kaichodesu/sotond5/liblcd/graphics/backgrounds/002.png

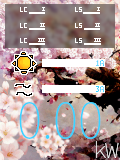
liblcd/graphics/backgrounds/002.png
