kaichodesu/sotond5/liblcd/graphics/backgrounds/characters/Agiri.png

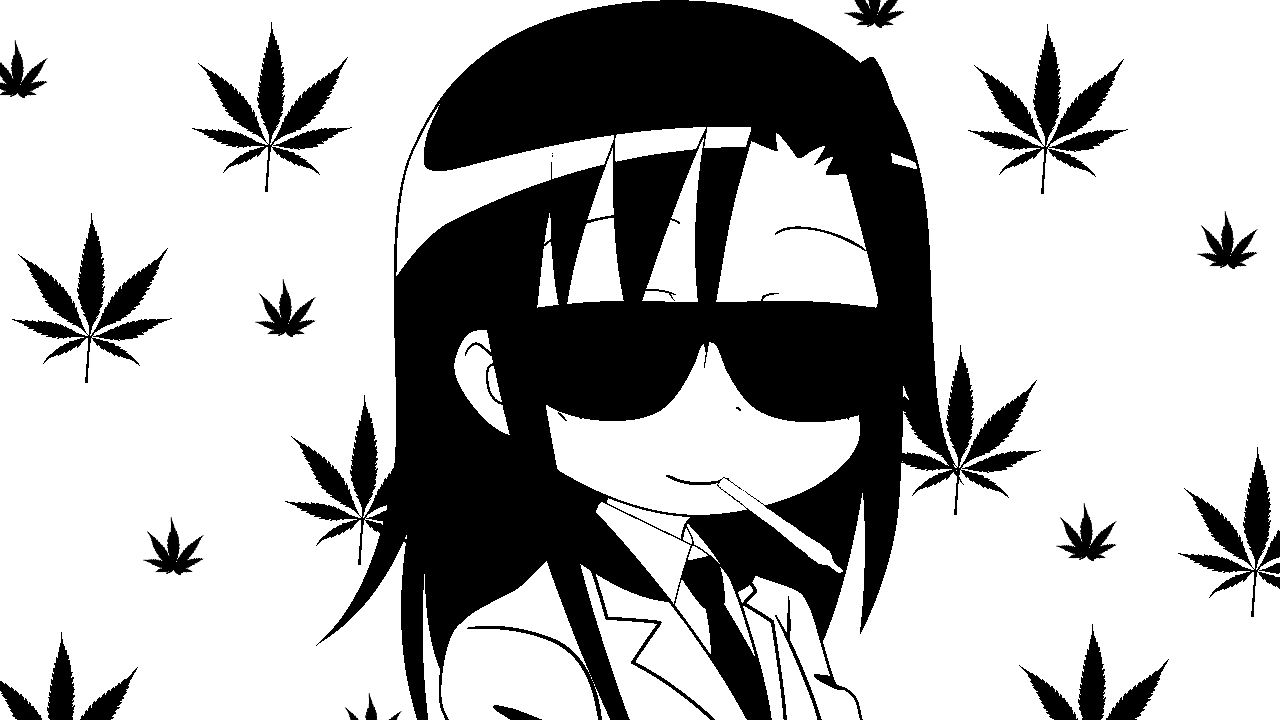
liblcd/graphics/backgrounds/characters/Agiri.png
