kaichodesu/sotond5/liblcd/graphics/backgrounds/characters/Akarin.png

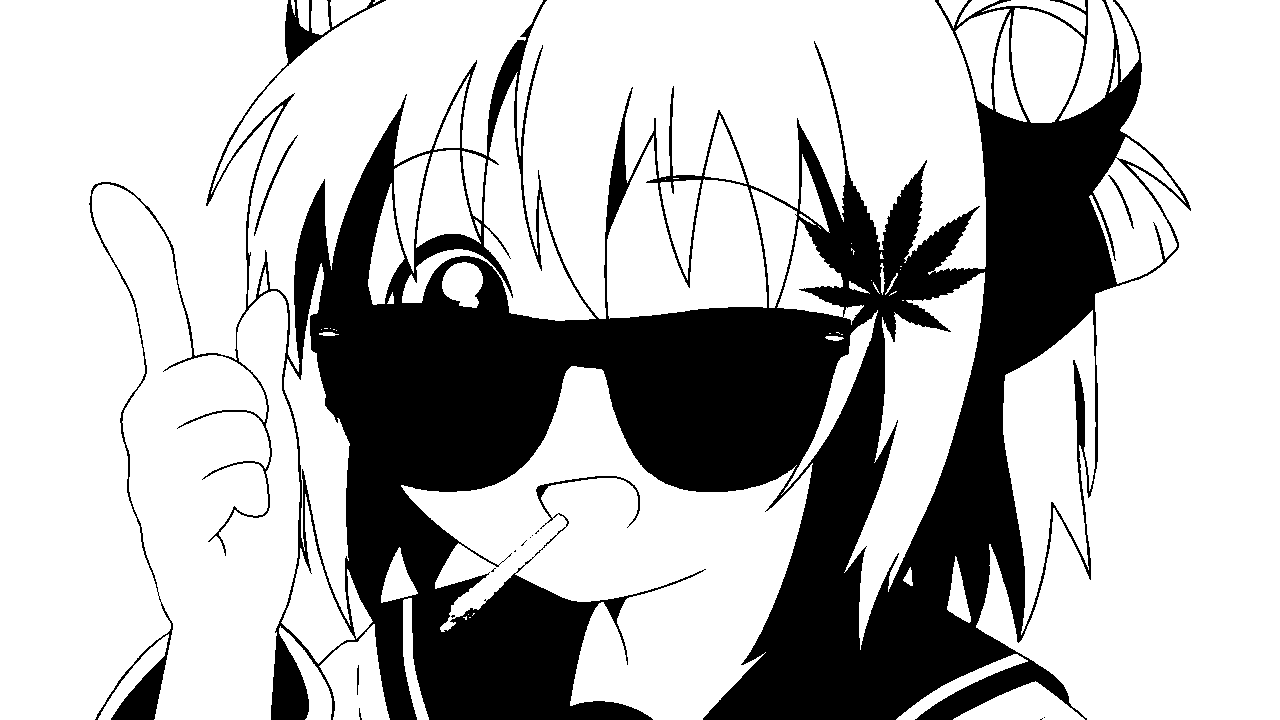
liblcd/graphics/backgrounds/characters/Akarin.png
