kaichodesu/sotond5/liblcd/graphics/backgrounds/characters/Astraea.png

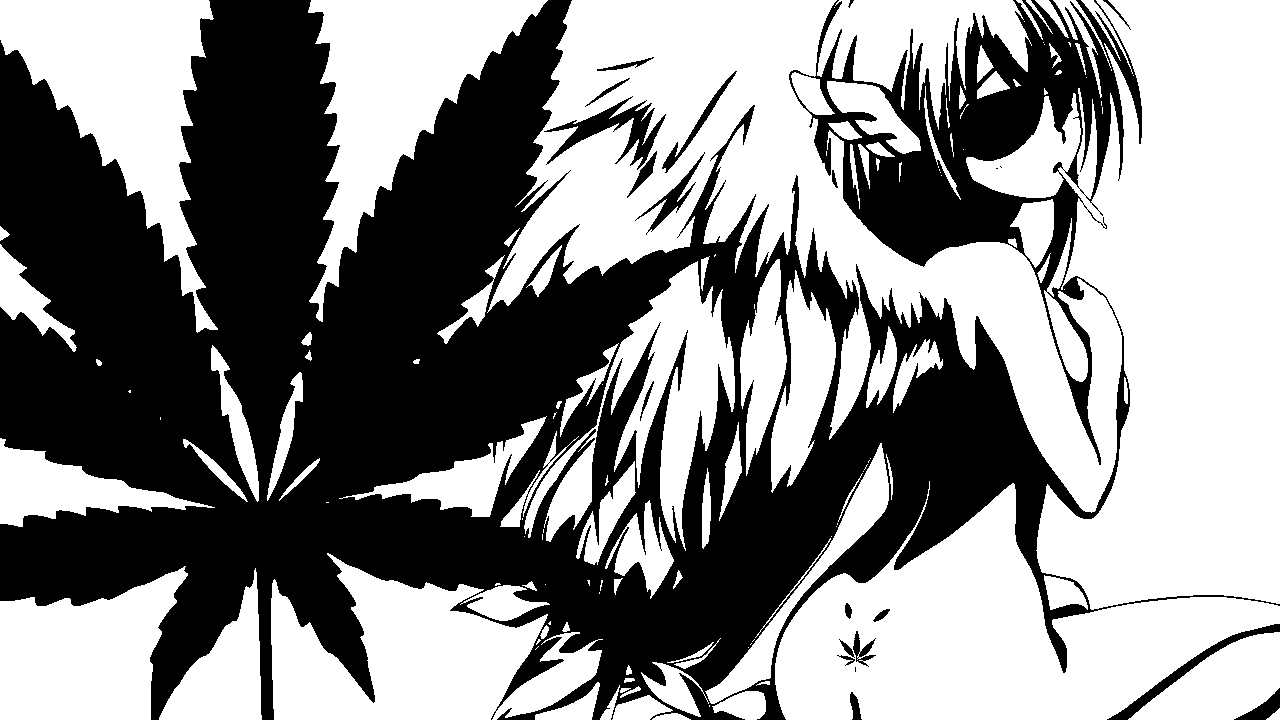
liblcd/graphics/backgrounds/characters/Astraea.png
