kaichodesu/sotond5/liblcd/graphics/backgrounds/characters/Ayase.png

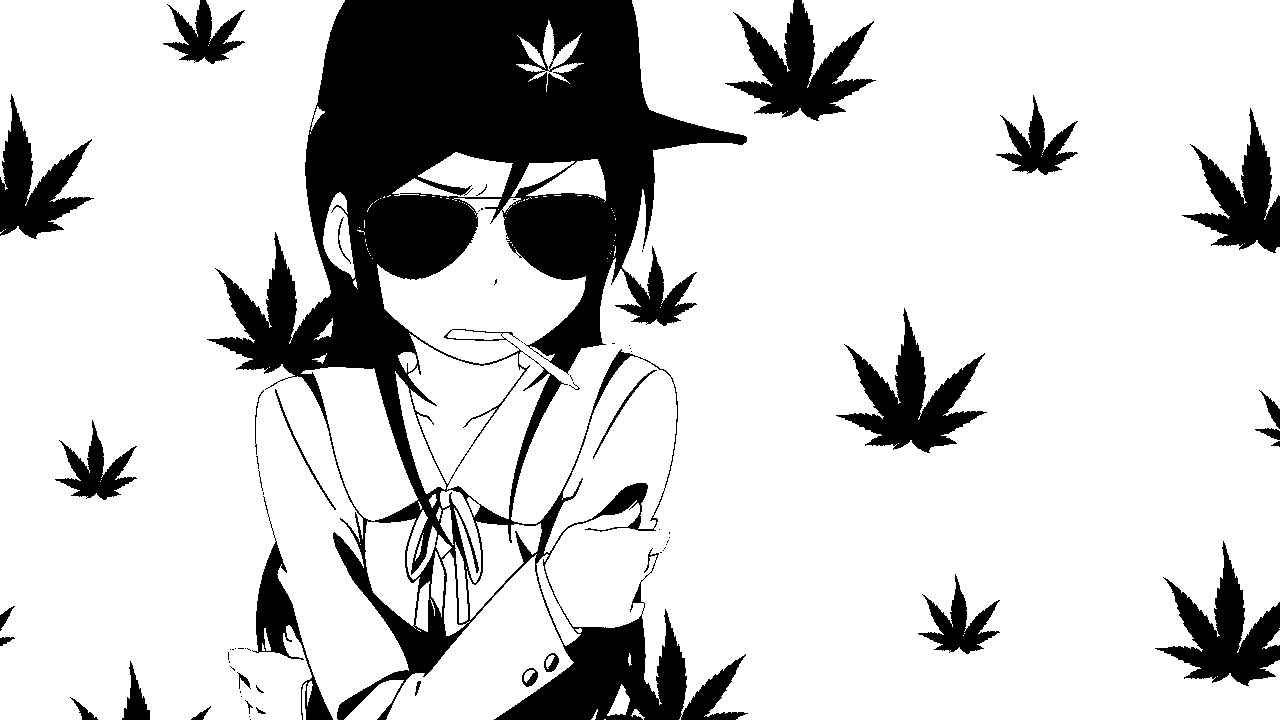
liblcd/graphics/backgrounds/characters/Ayase.png
