kaichodesu/sotond5/liblcd/graphics/backgrounds/characters/Cirno.png

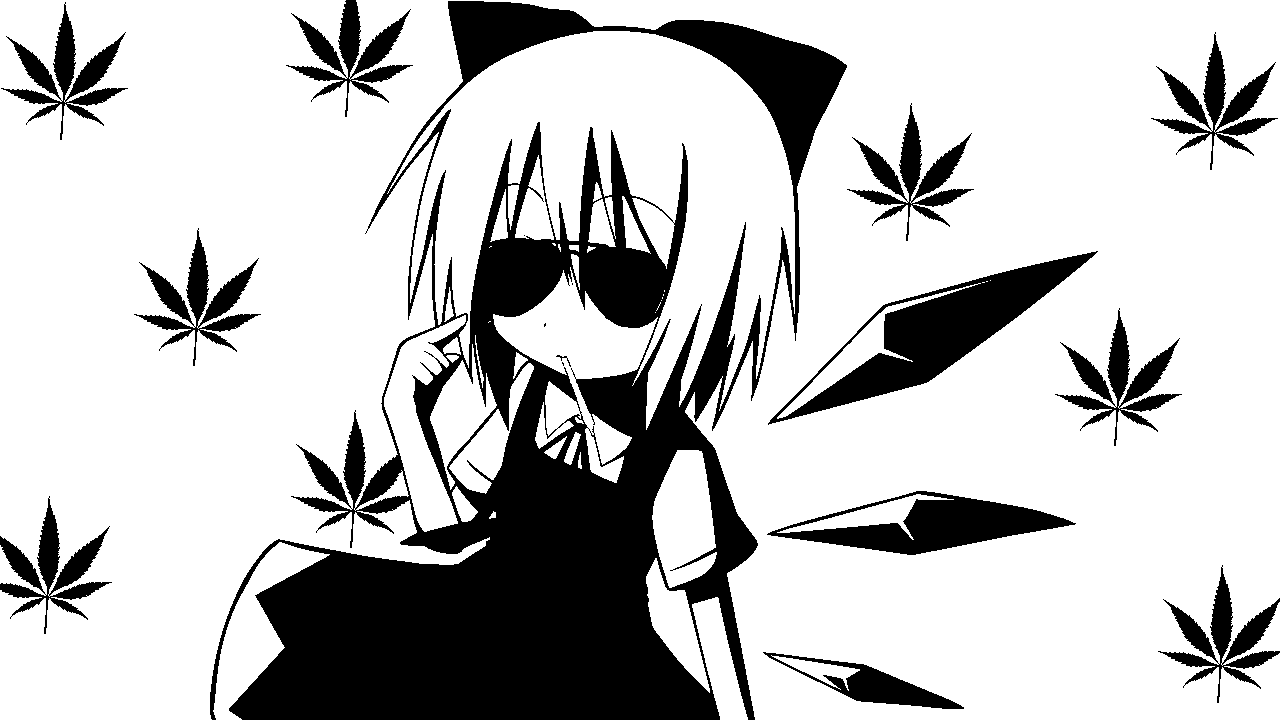
liblcd/graphics/backgrounds/characters/Cirno.png
