kaichodesu/sotond5/liblcd/graphics/backgrounds/characters/Eureka.png

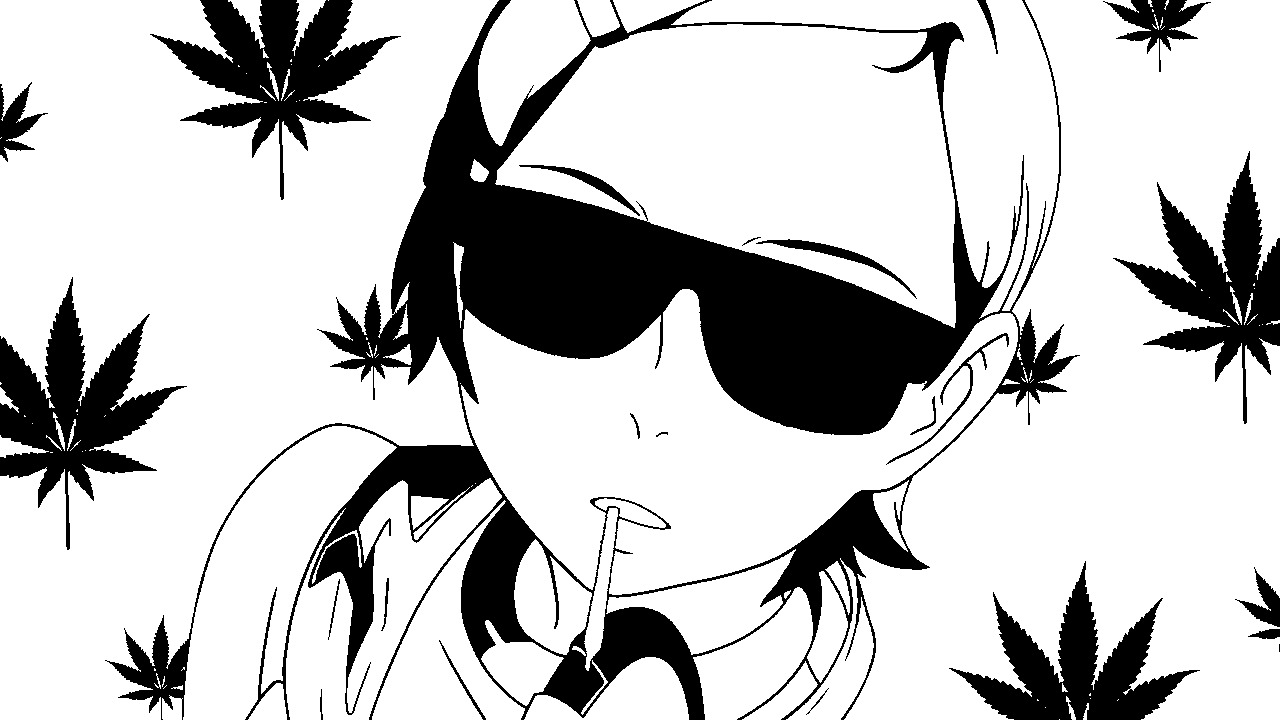
liblcd/graphics/backgrounds/characters/Eureka.png
