kaichodesu/sotond5/liblcd/graphics/backgrounds/characters/Fuu.png

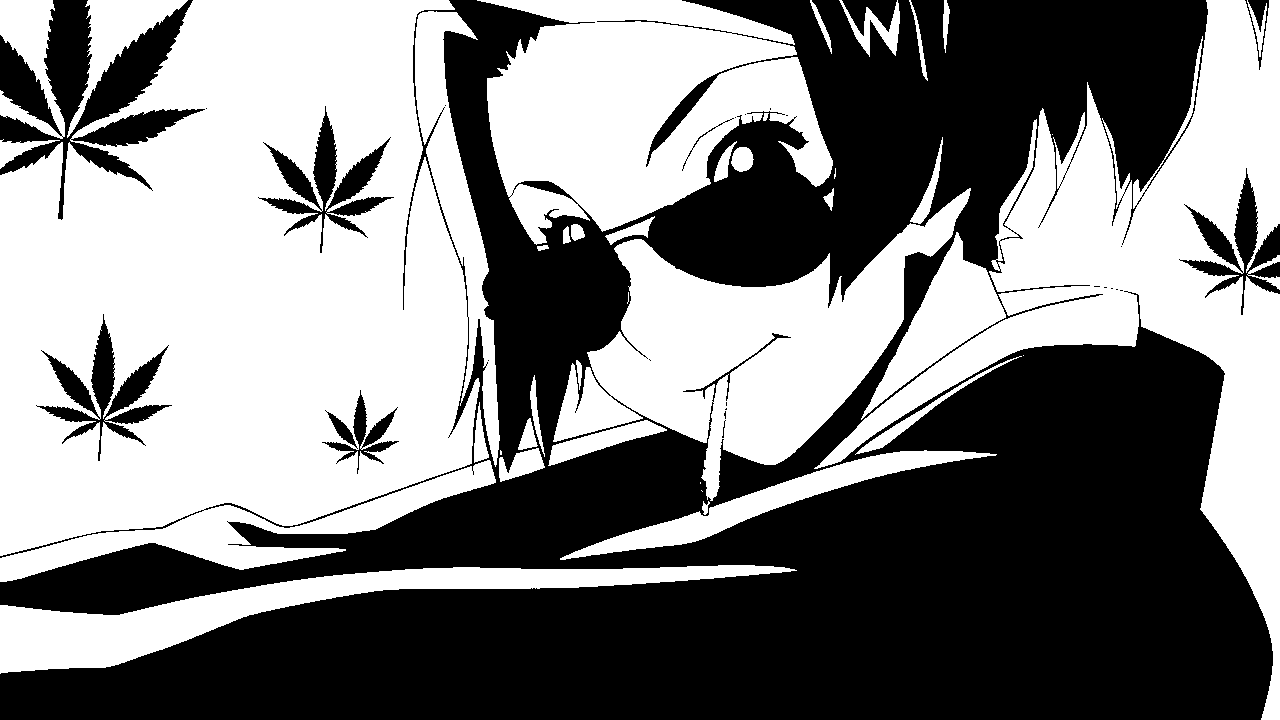
liblcd/graphics/backgrounds/characters/Fuu.png
