kaichodesu/sotond5/liblcd/graphics/backgrounds/characters/Hajime Ichinose.png

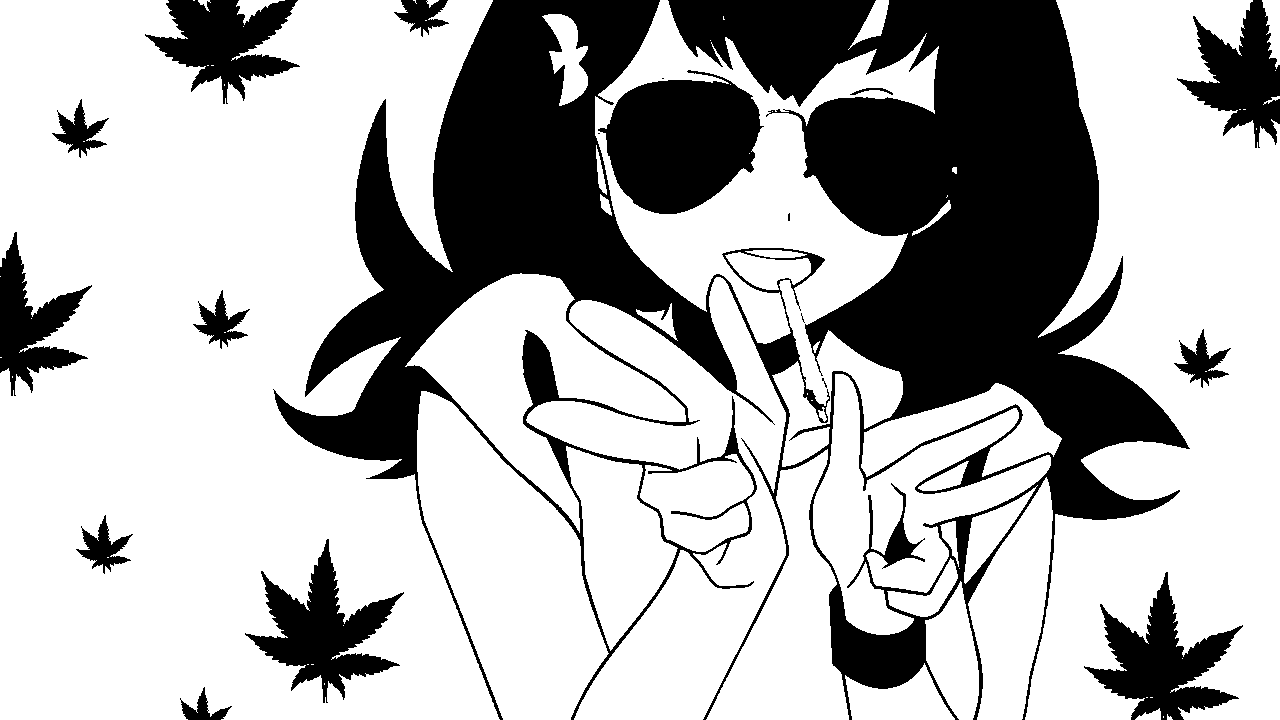
liblcd/graphics/backgrounds/characters/Hajime Ichinose.png
