kaichodesu/sotond5/liblcd/graphics/backgrounds/characters/Hanako.png

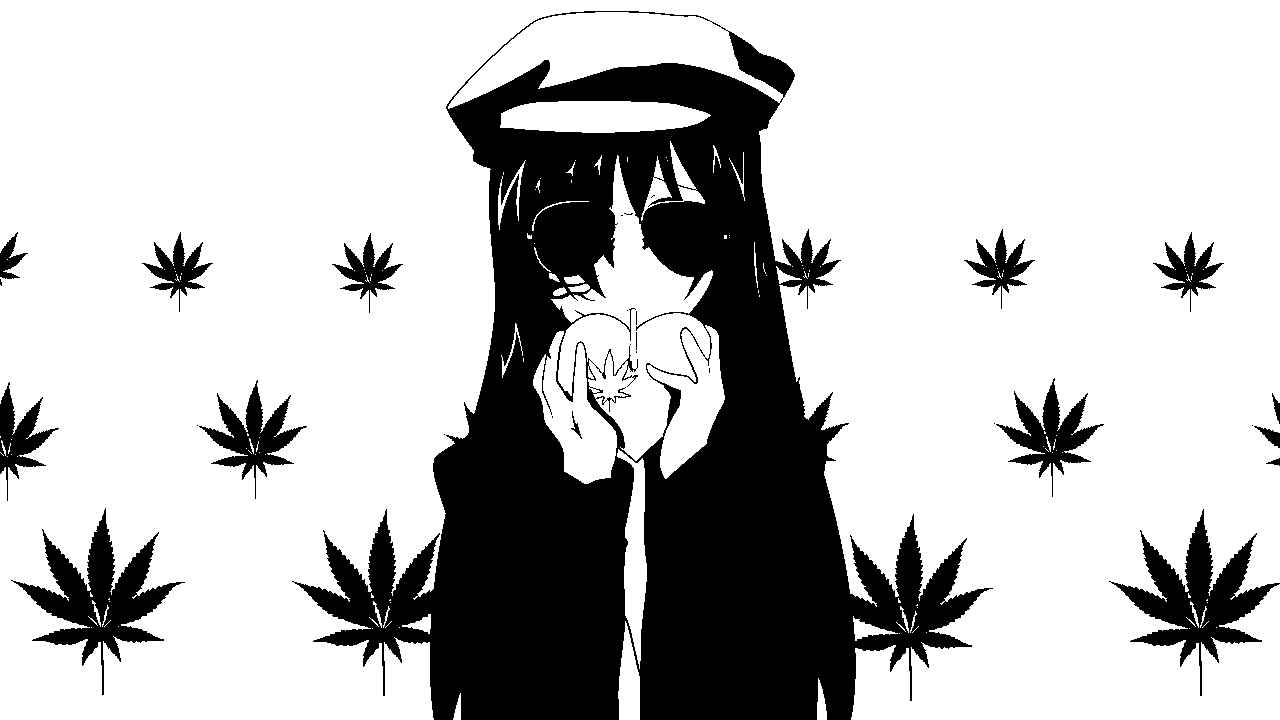
liblcd/graphics/backgrounds/characters/Hanako.png
