kaichodesu/sotond5/liblcd/graphics/backgrounds/characters/Haruhi.png

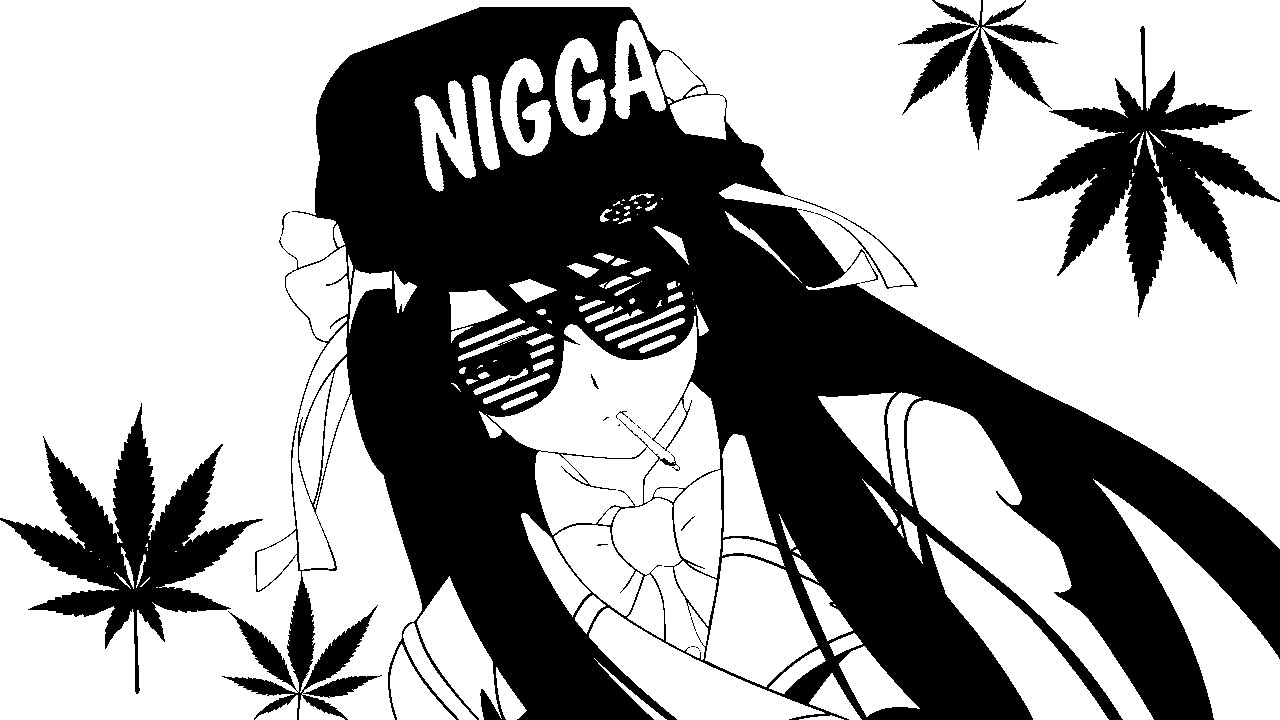
liblcd/graphics/backgrounds/characters/Haruhi.png
