kaichodesu/sotond5/liblcd/graphics/backgrounds/characters/Holo.png

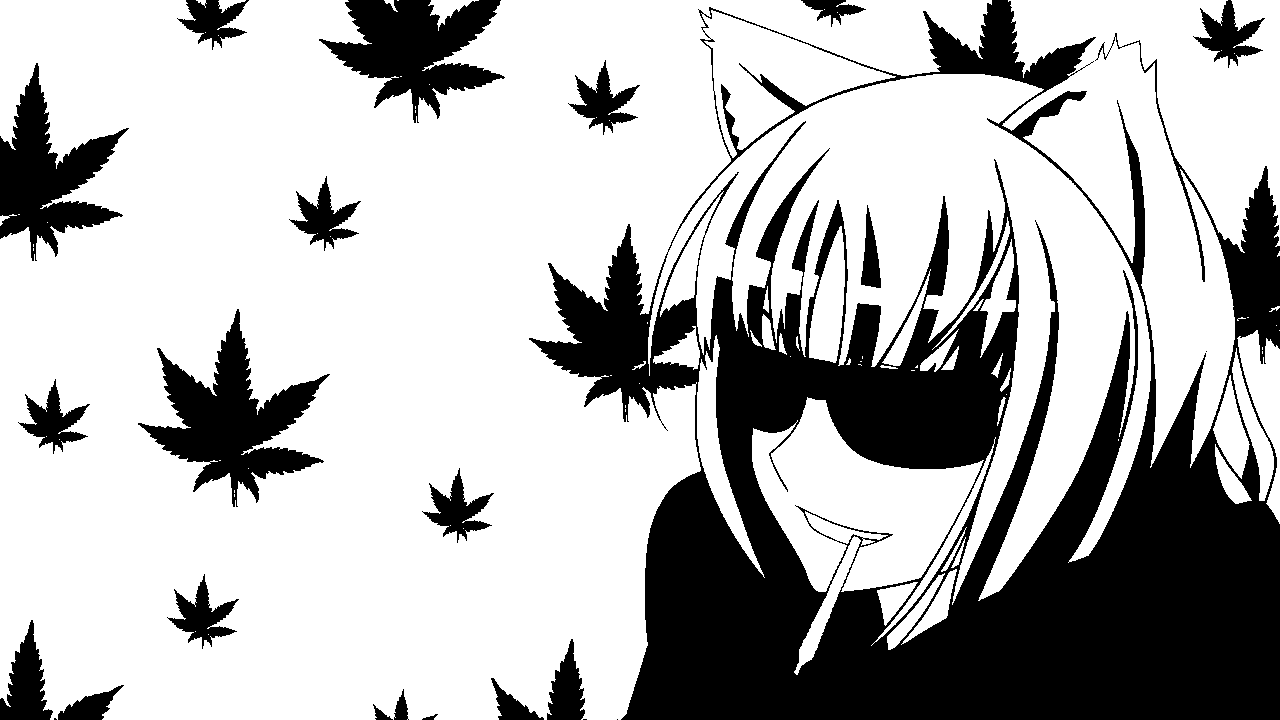
liblcd/graphics/backgrounds/characters/Holo.png
