kaichodesu/sotond5/liblcd/graphics/backgrounds/characters/Kanade.png

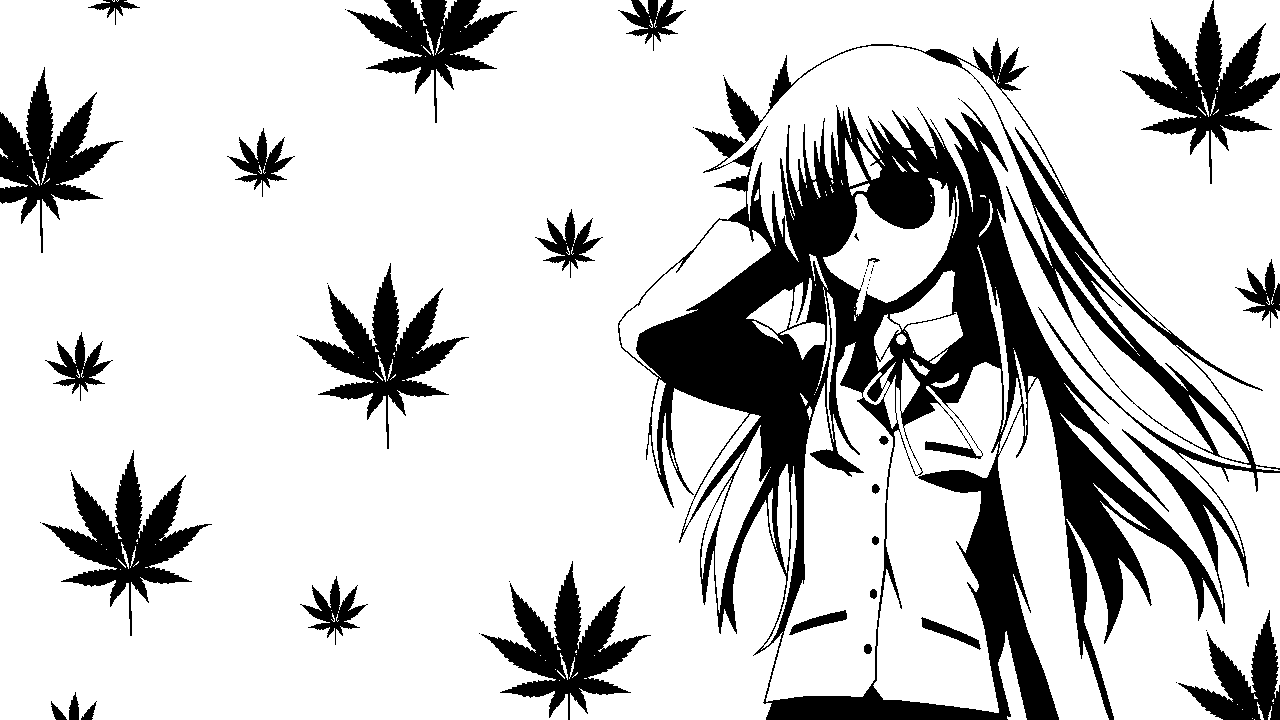
liblcd/graphics/backgrounds/characters/Kanade.png
