kaichodesu/sotond5/liblcd/graphics/backgrounds/characters/Kanoe.png

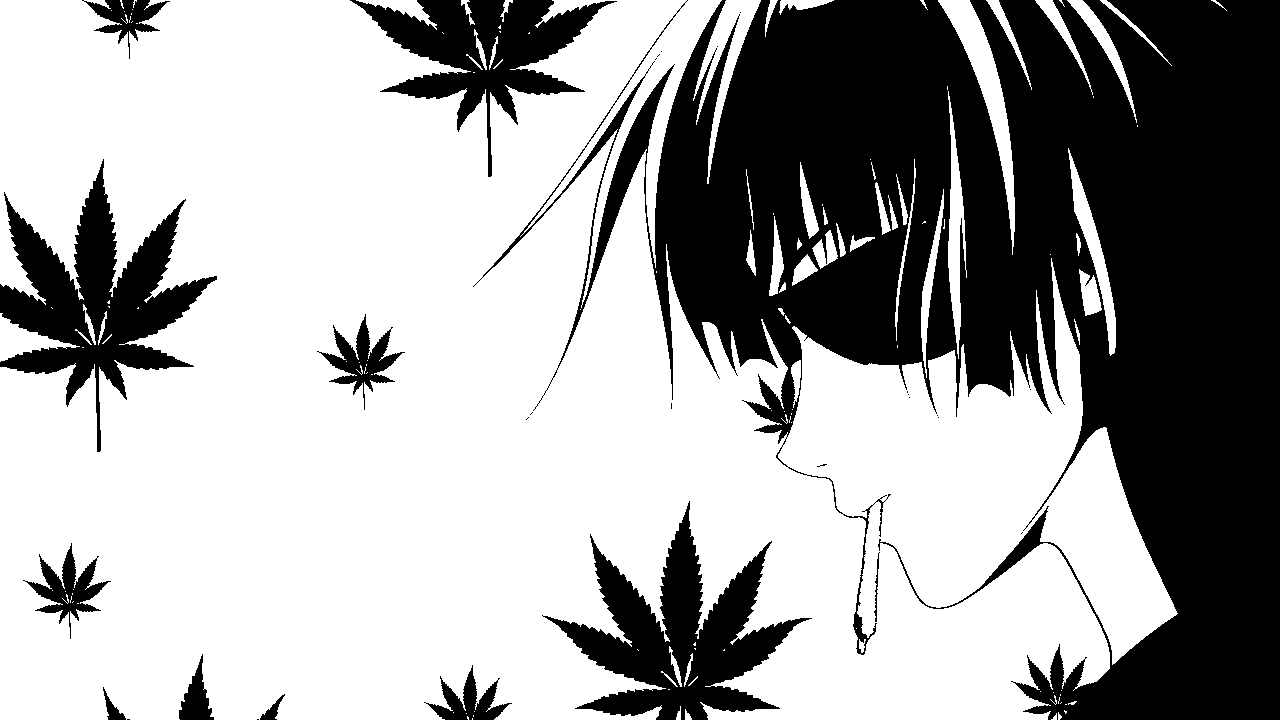
liblcd/graphics/backgrounds/characters/Kanoe.png
