kaichodesu/sotond5/liblcd/graphics/backgrounds/characters/Kyoko.png

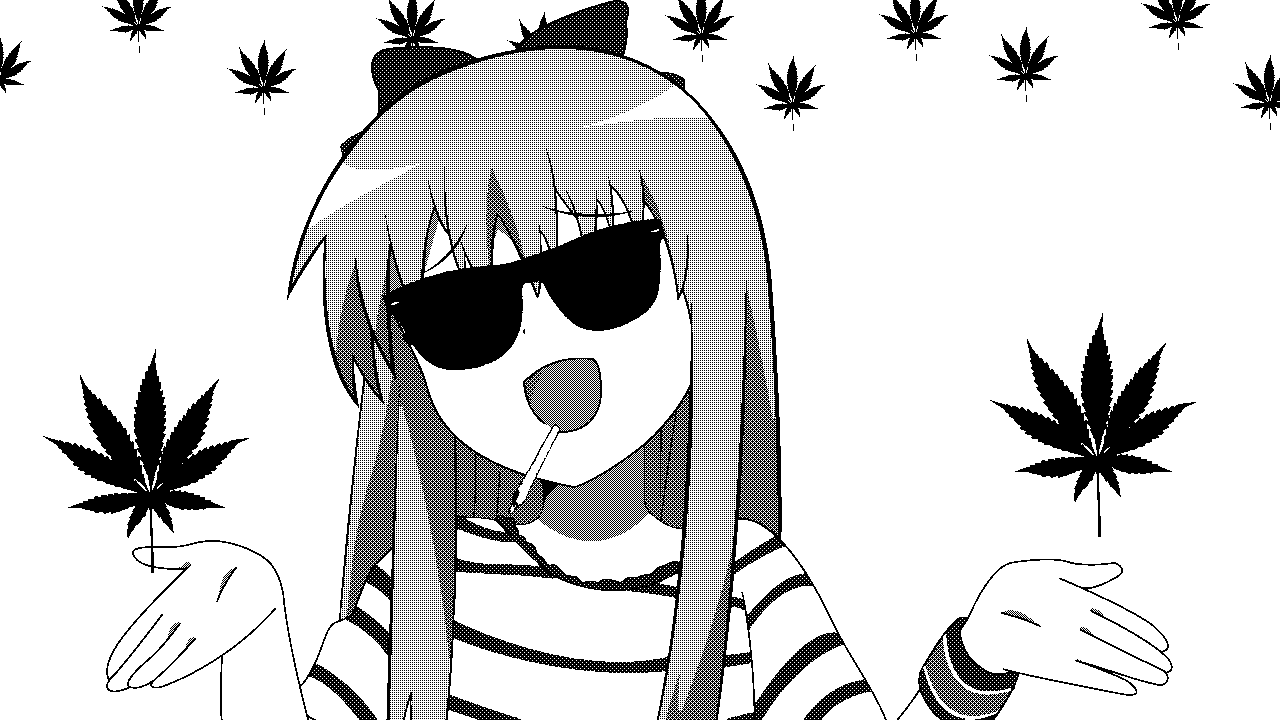
liblcd/graphics/backgrounds/characters/Kyoko.png
