kaichodesu/sotond5/liblcd/graphics/backgrounds/characters/Lala-Ru.png

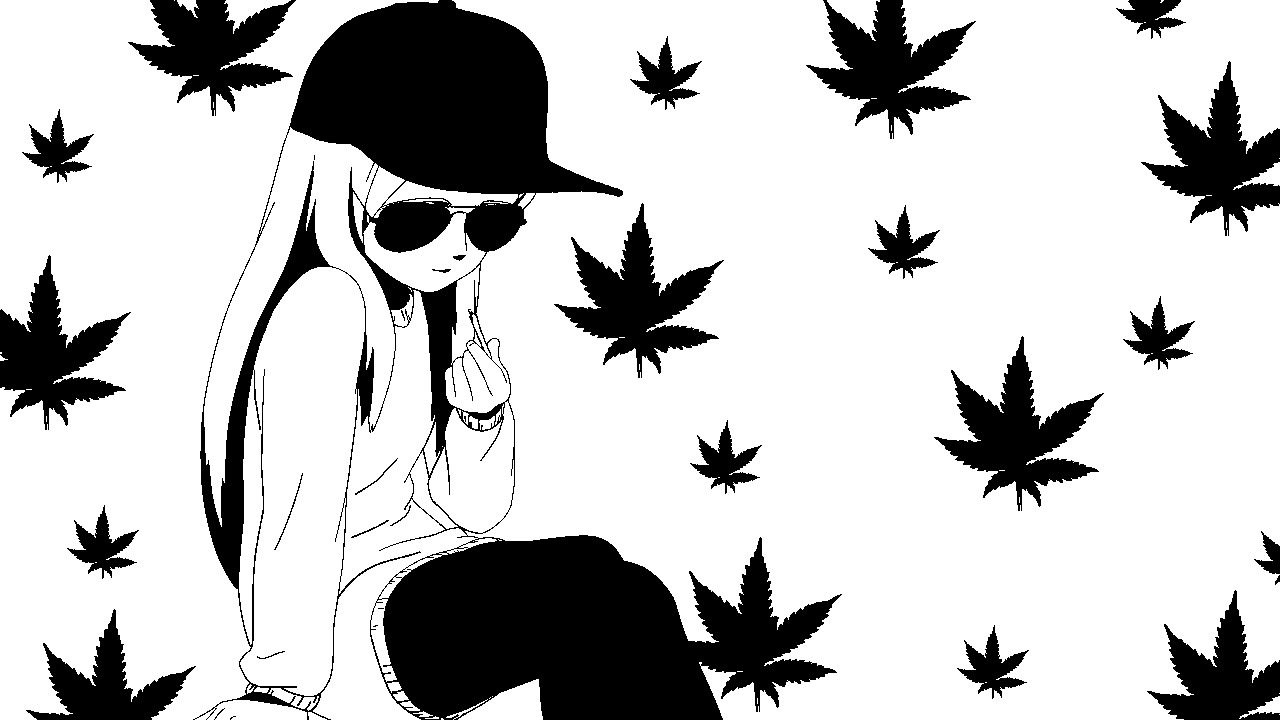
liblcd/graphics/backgrounds/characters/Lala-Ru.png
