kaichodesu/sotond5/liblcd/graphics/backgrounds/characters/Lucy.gif

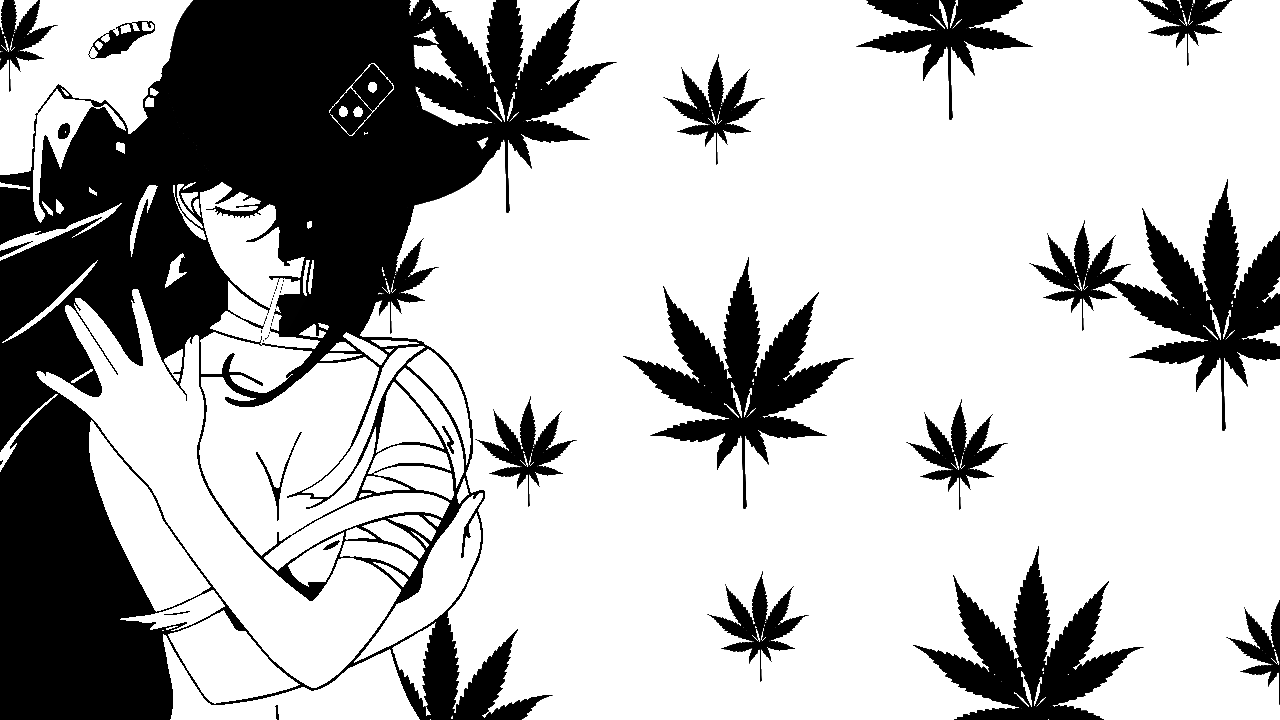
liblcd/graphics/backgrounds/characters/Lucy.gif
