kaichodesu/sotond5/liblcd/graphics/backgrounds/characters/Madotsuki.png

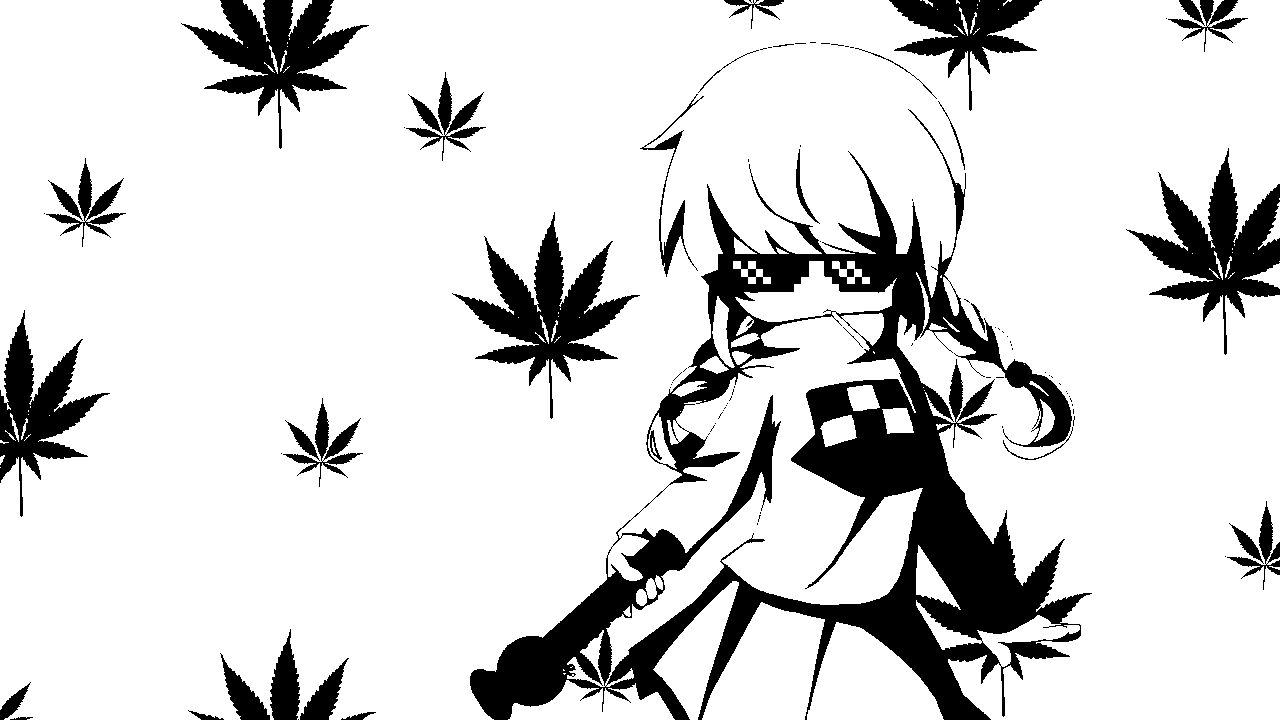
liblcd/graphics/backgrounds/characters/Madotsuki.png
