kaichodesu/sotond5/liblcd/graphics/backgrounds/characters/Mao.png

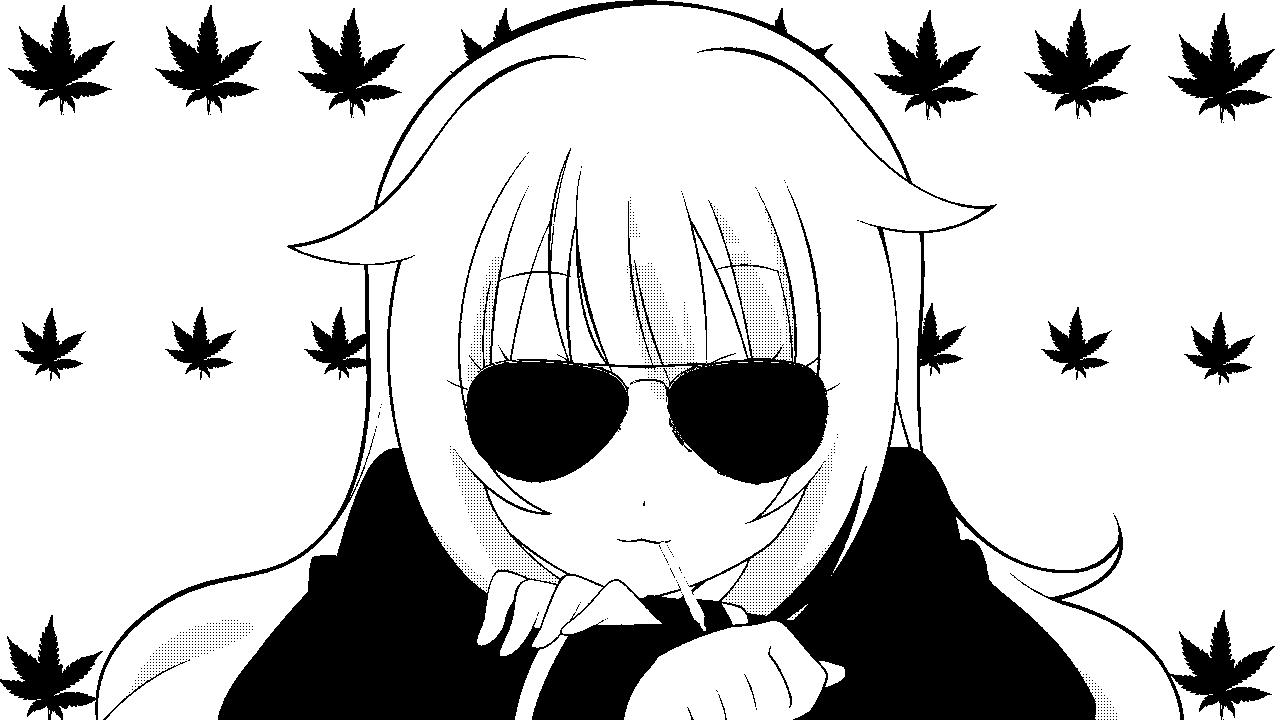
liblcd/graphics/backgrounds/characters/Mao.png
