kaichodesu/sotond5/liblcd/graphics/backgrounds/characters/Mayoi.png

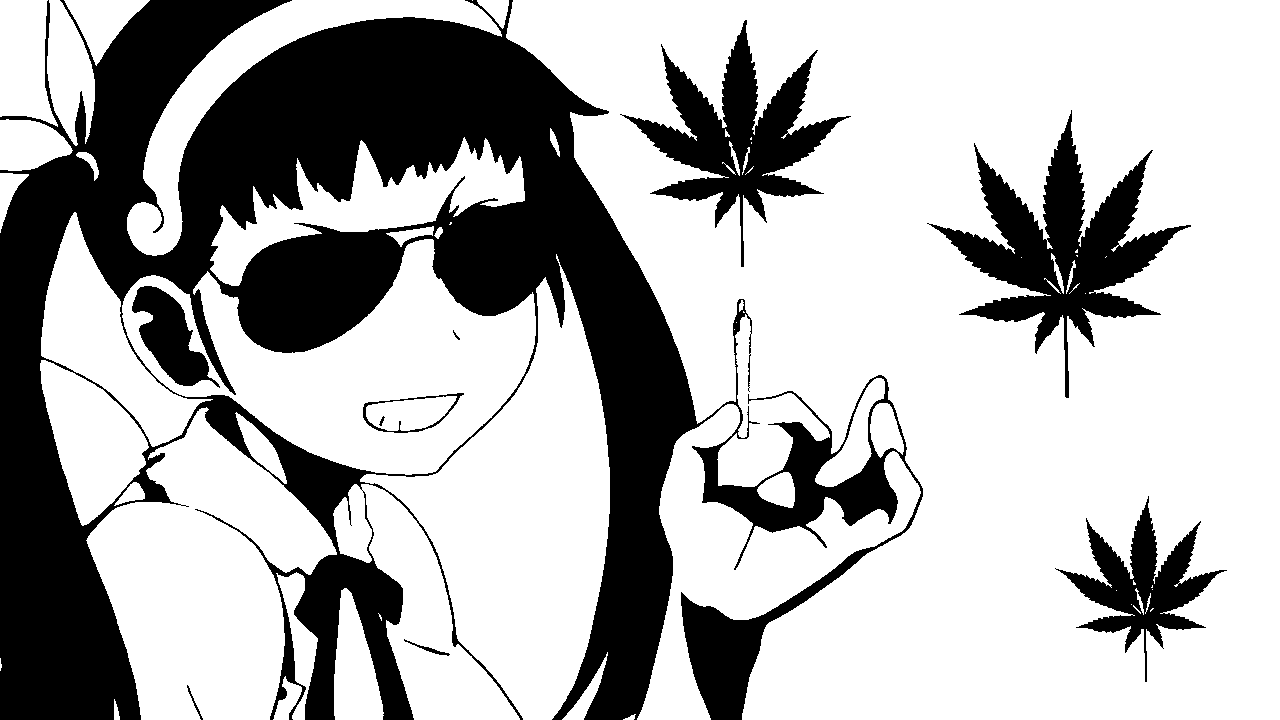
liblcd/graphics/backgrounds/characters/Mayoi.png
