kaichodesu/sotond5/liblcd/graphics/backgrounds/characters/Megumi.png

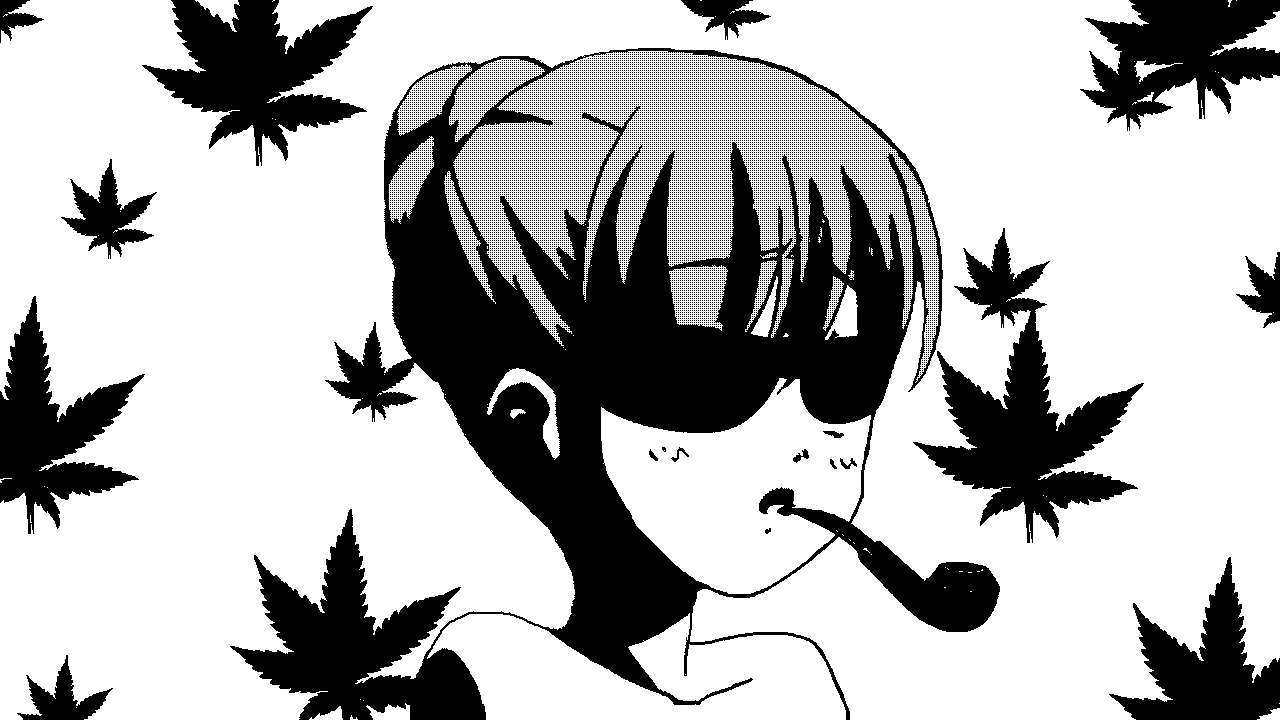
liblcd/graphics/backgrounds/characters/Megumi.png
