kaichodesu/sotond5/liblcd/graphics/backgrounds/characters/Mirai.png

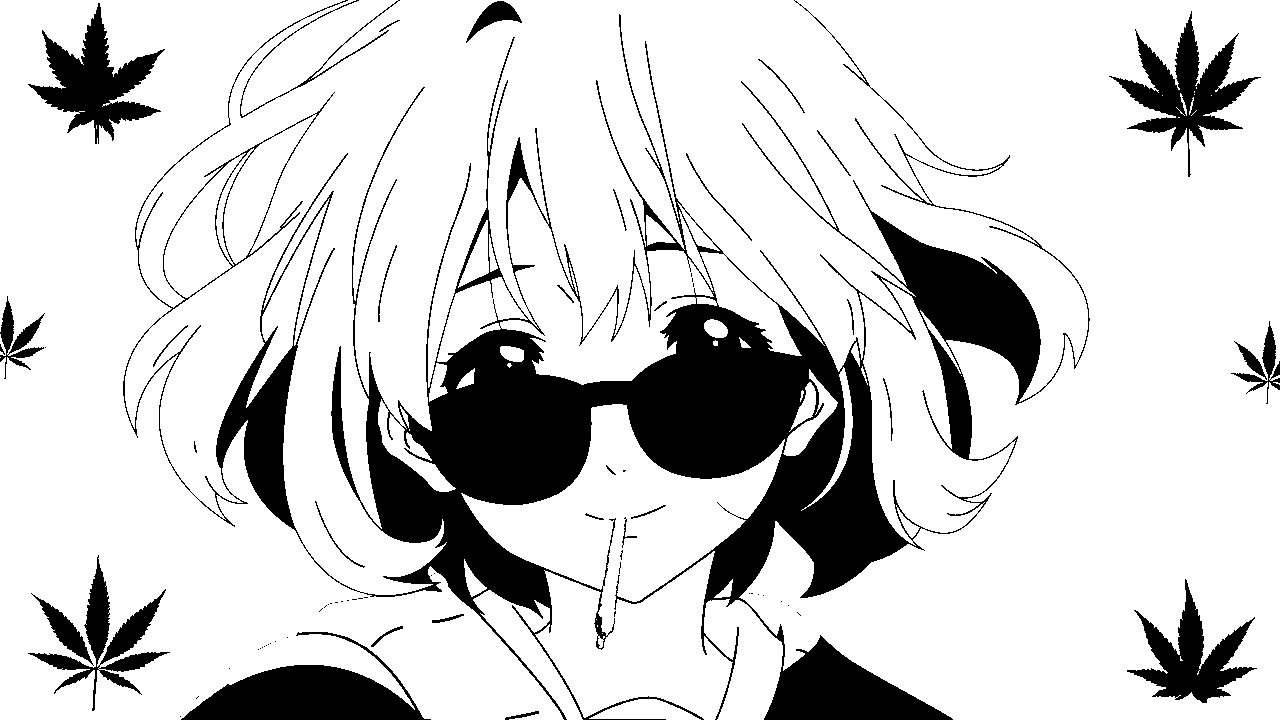
liblcd/graphics/backgrounds/characters/Mirai.png
