kaichodesu/sotond5/liblcd/graphics/backgrounds/characters/Misaki.png

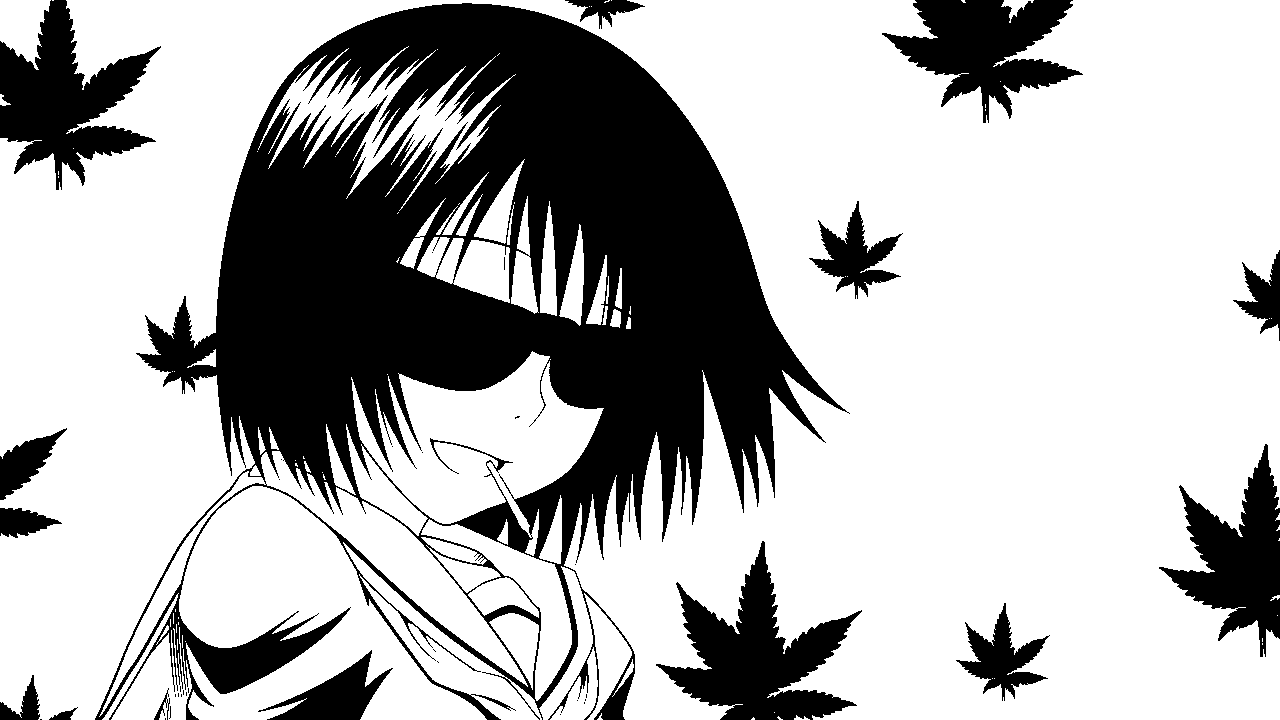
liblcd/graphics/backgrounds/characters/Misaki.png
