kaichodesu/sotond5/liblcd/graphics/backgrounds/characters/Morgiana.png

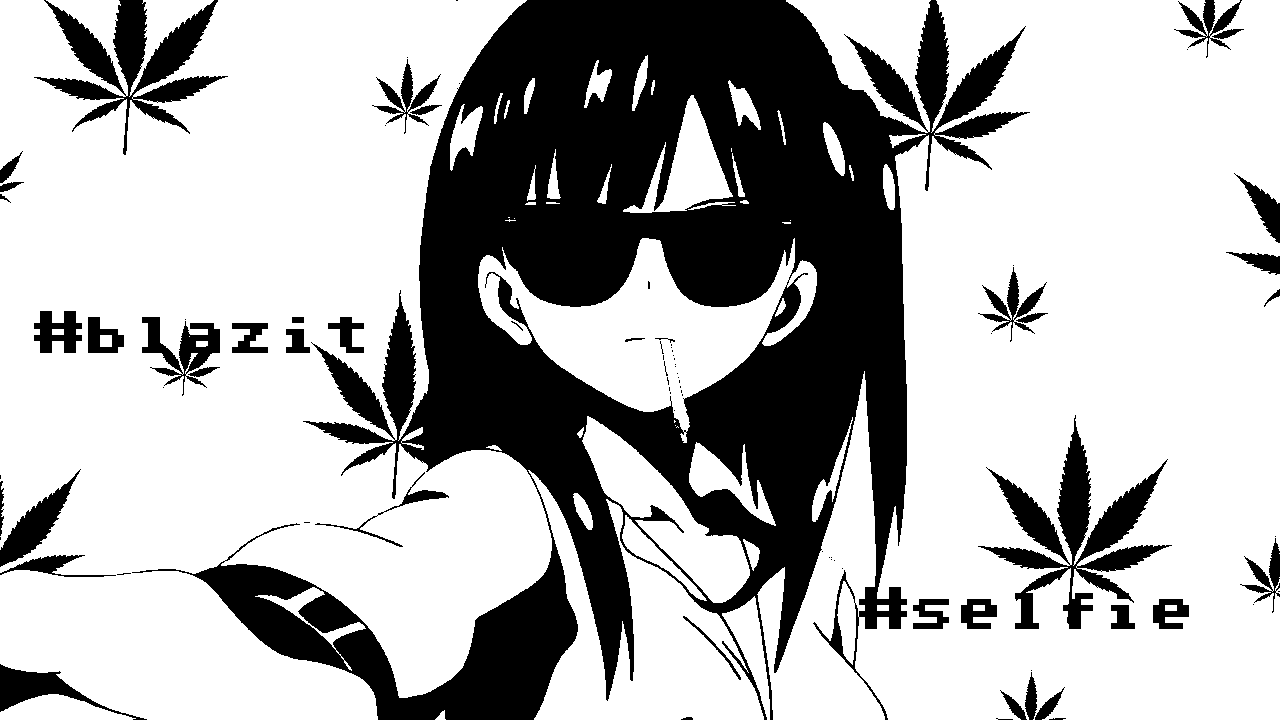
liblcd/graphics/backgrounds/characters/Morgiana.png
