kaichodesu/sotond5/liblcd/graphics/backgrounds/characters/Noel.png

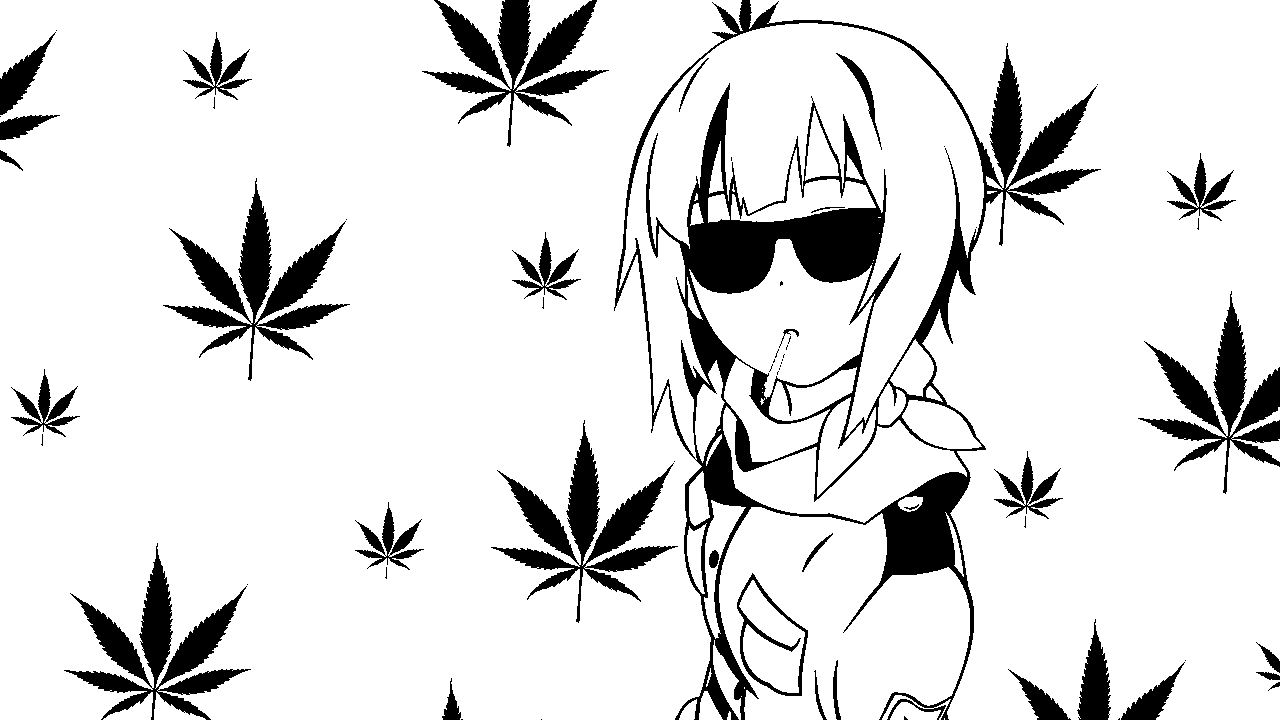
liblcd/graphics/backgrounds/characters/Noel.png
