kaichodesu/sotond5/liblcd/graphics/backgrounds/characters/Nymph.png

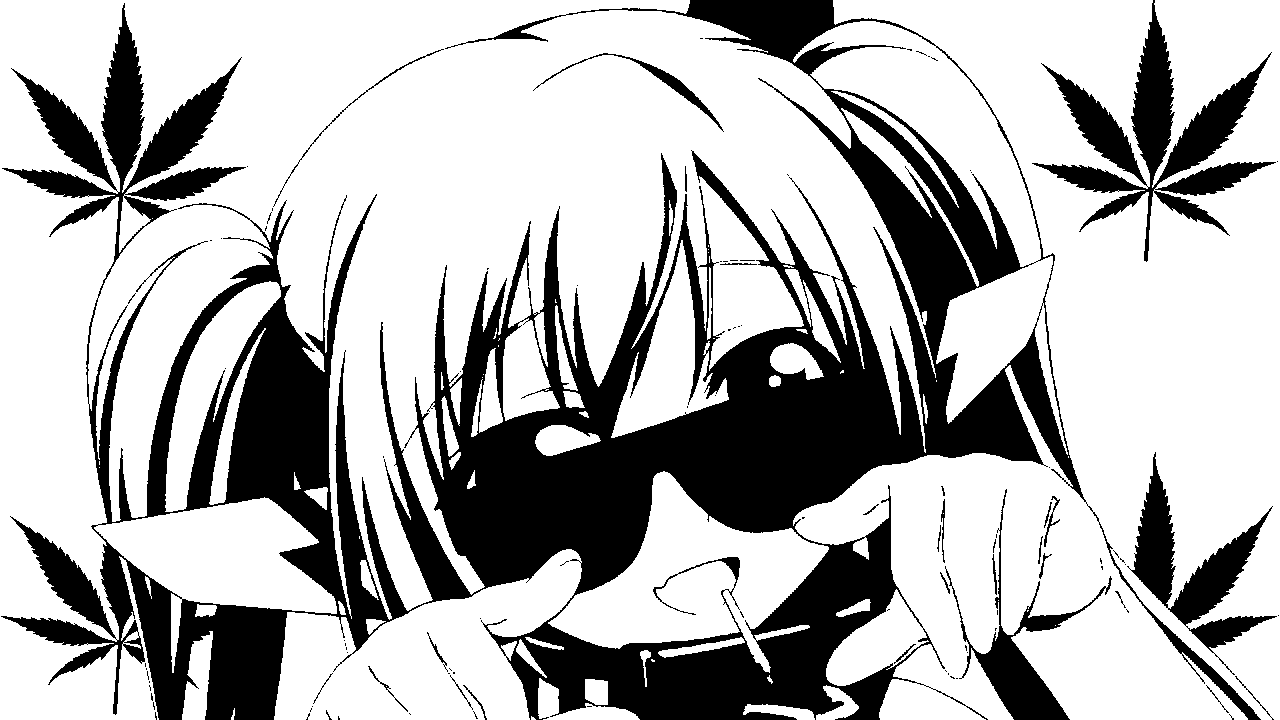
liblcd/graphics/backgrounds/characters/Nymph.png
