kaichodesu/sotond5/liblcd/graphics/backgrounds/characters/Renge.png

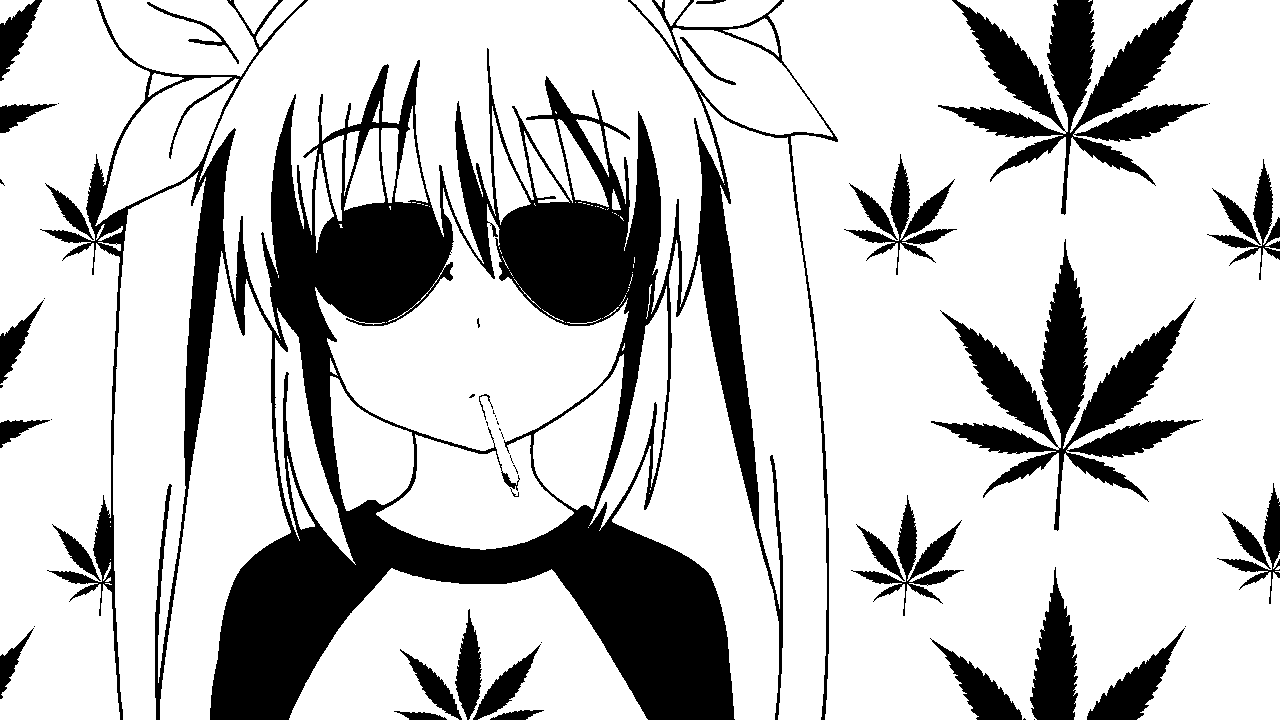
liblcd/graphics/backgrounds/characters/Renge.png
