kaichodesu/sotond5/liblcd/graphics/backgrounds/characters/Shinobu.png

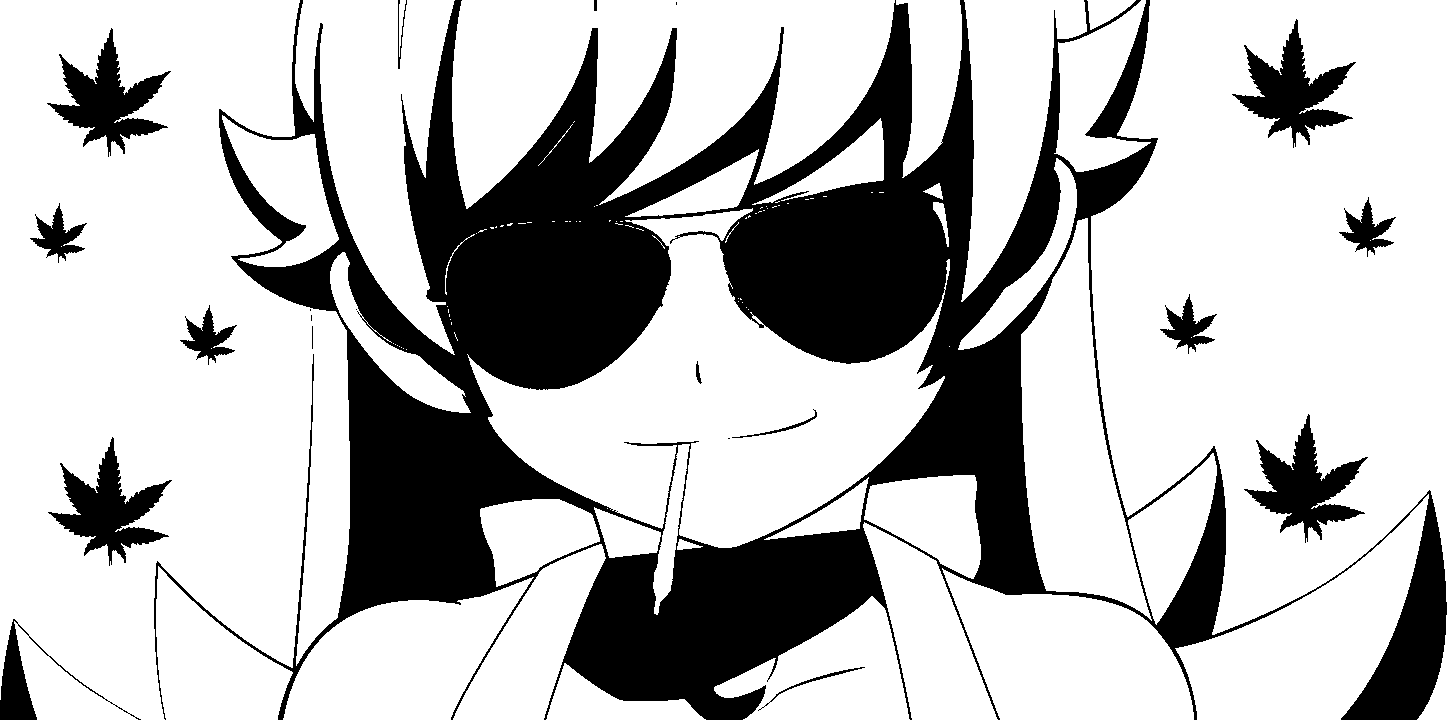
liblcd/graphics/backgrounds/characters/Shinobu.png
