kaichodesu/sotond5/liblcd/graphics/backgrounds/characters/Suiseiseki.png

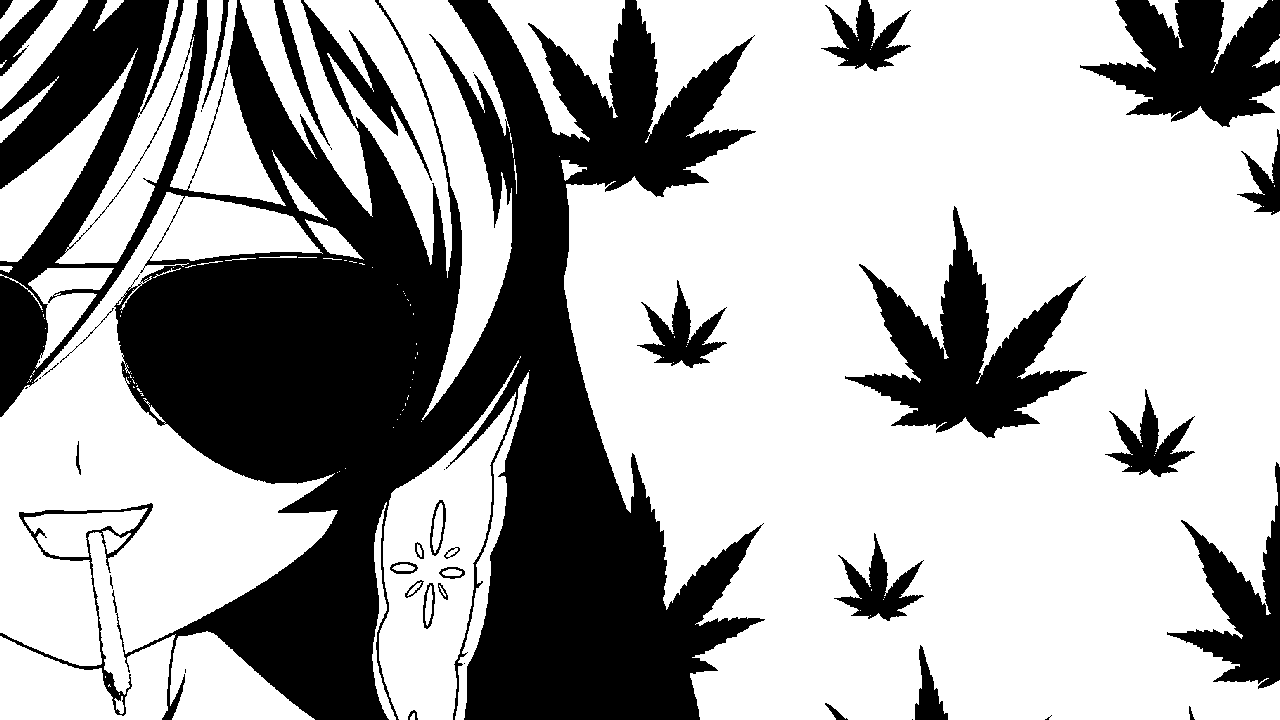
liblcd/graphics/backgrounds/characters/Suiseiseki.png
