kaichodesu/sotond5/Project Files/PSU Simulations and OrCAD files/Final/SMPS.png

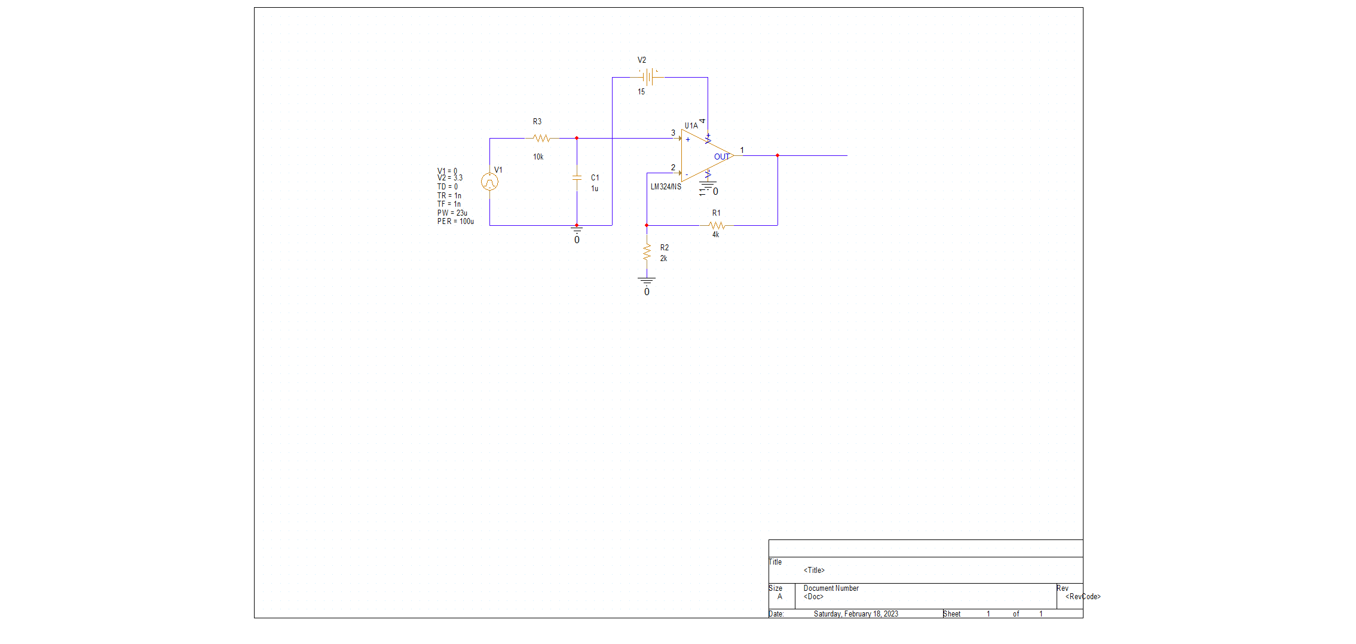
Project Files/PSU Simulations and OrCAD files/Final/SMPS.png
