kaichodesu/sotond5/Project Files/PSU Simulations and OrCAD files/Version 3/UCC28730_PSPICE_TRANS/UCC28730_DEB.png

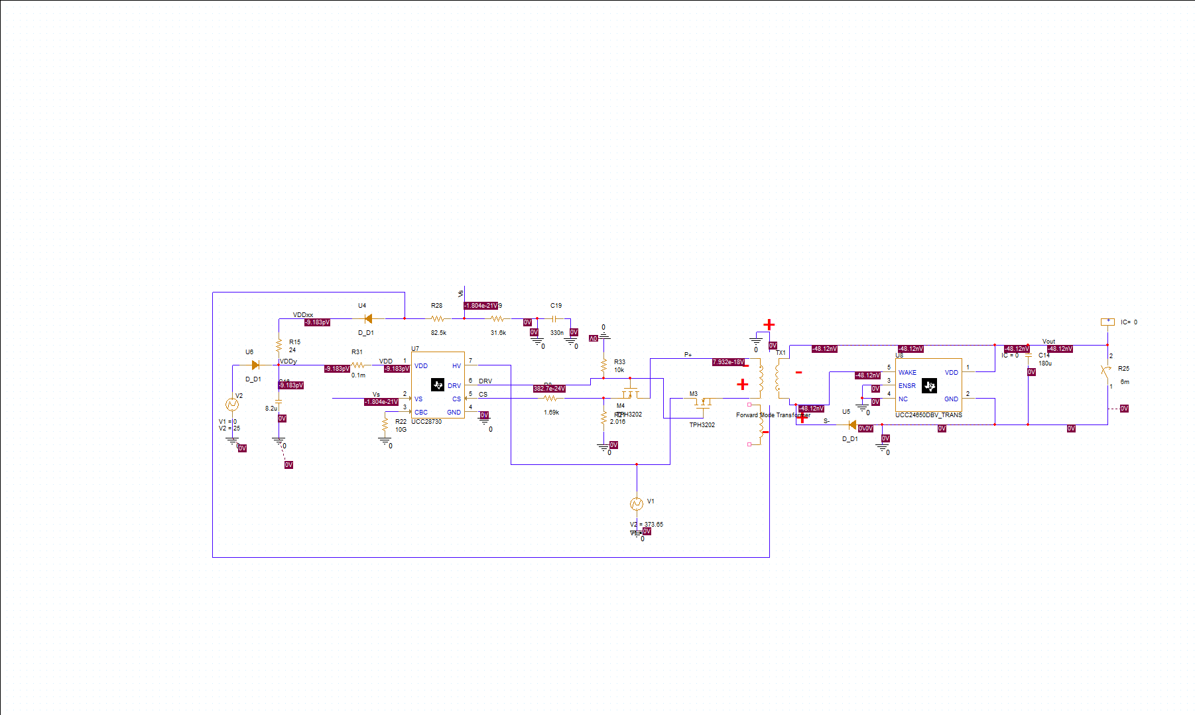
Project Files/PSU Simulations and OrCAD files/Version 3/UCC28730_PSPICE_TRANS/UCC28730_DEB.png
