kaichodesu/sotond5/Project Files/Report/D5/3.3v (main capacity) circuit.png

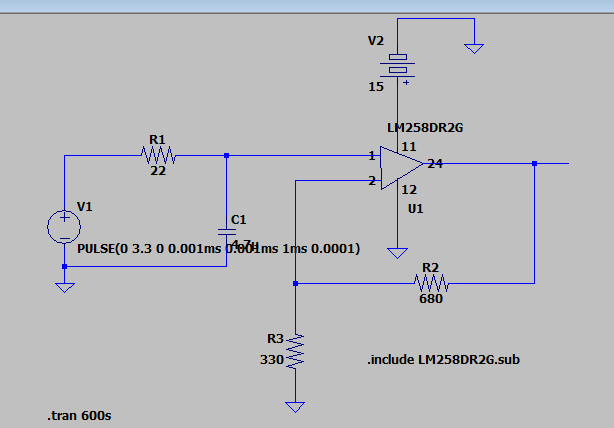
Project Files/Report/D5/3.3v (main capacity) circuit.png
