kaichodesu/sotond5/Project Files/Report/D5/4AC circuit.png

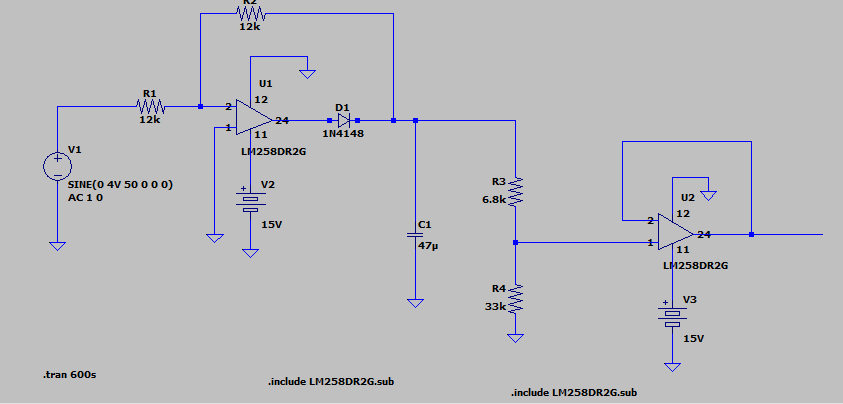
Project Files/Report/D5/4AC circuit.png
