kaichodesu/sotond5/Project Files/Report/D5/5 digital circuit.png

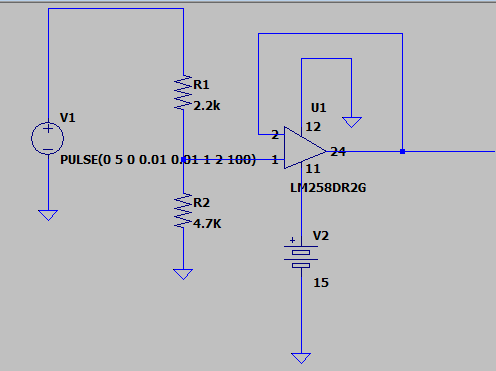
Project Files/Report/D5/5 digital circuit.png
