kaichodesu/sotond5/Project Files/Report/D5/5DC circuit.png

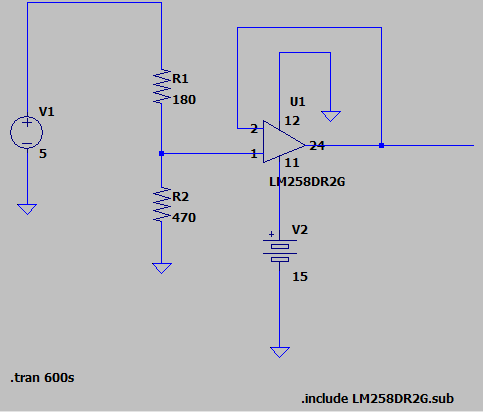
Project Files/Report/D5/5DC circuit.png
