kaichodesu/sotond5/Project Files/Report/D5/5DC.png

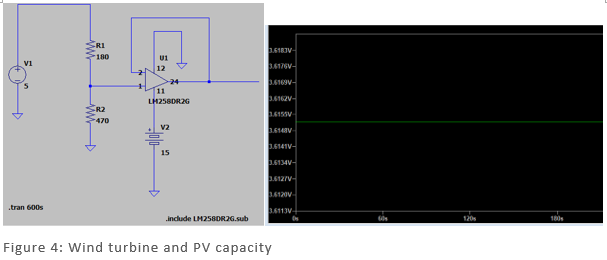
Project Files/Report/D5/5DC.png
