kaichodesu/sotond5/Project Files/Report/D5/10AC circuit.png

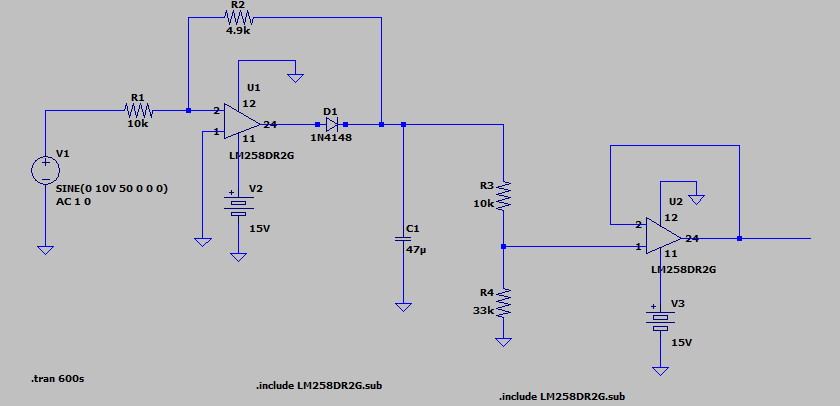
Project Files/Report/D5/10AC circuit.png
