kaichodesu/sotond5/Project Files/Report/D5/Enclosure CAD model.png

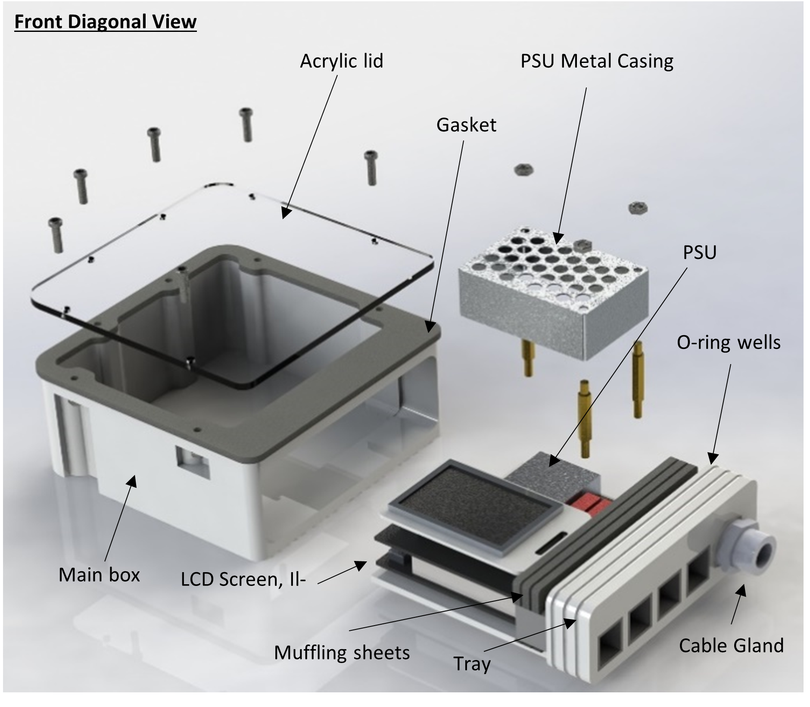
Project Files/Report/D5/Enclosure CAD model.png
