kaichodesu/sotond5/Project Files/Report/D5/IMG_3582.jpg

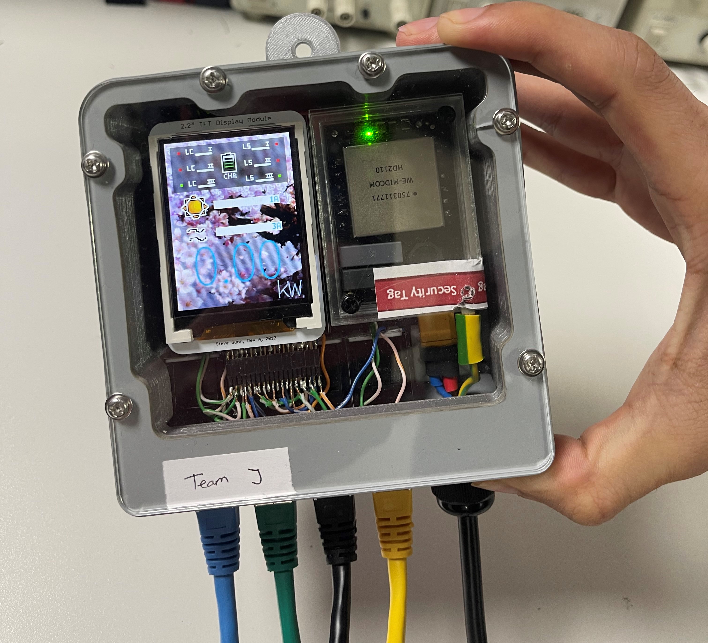
Project Files/Report/D5/IMG_3582.jpg
