kaichodesu/sotond5/Project Files/Report/D5/Tray.png

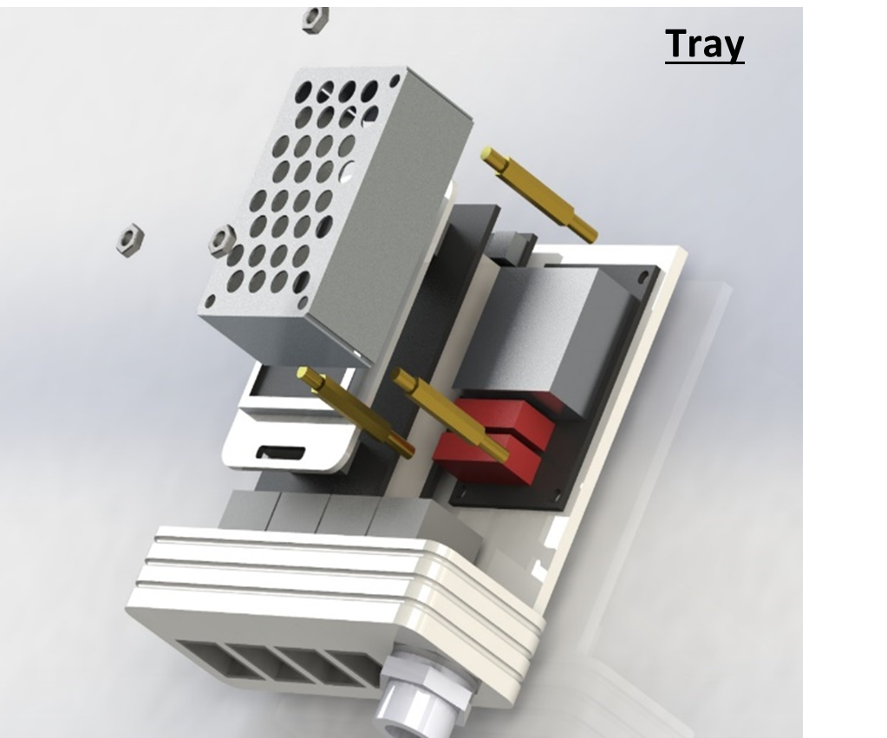
Project Files/Report/D5/Tray.png
