kaichodesu/sotond5/Project Files/Housing CAD design files/Update5.SLDASM

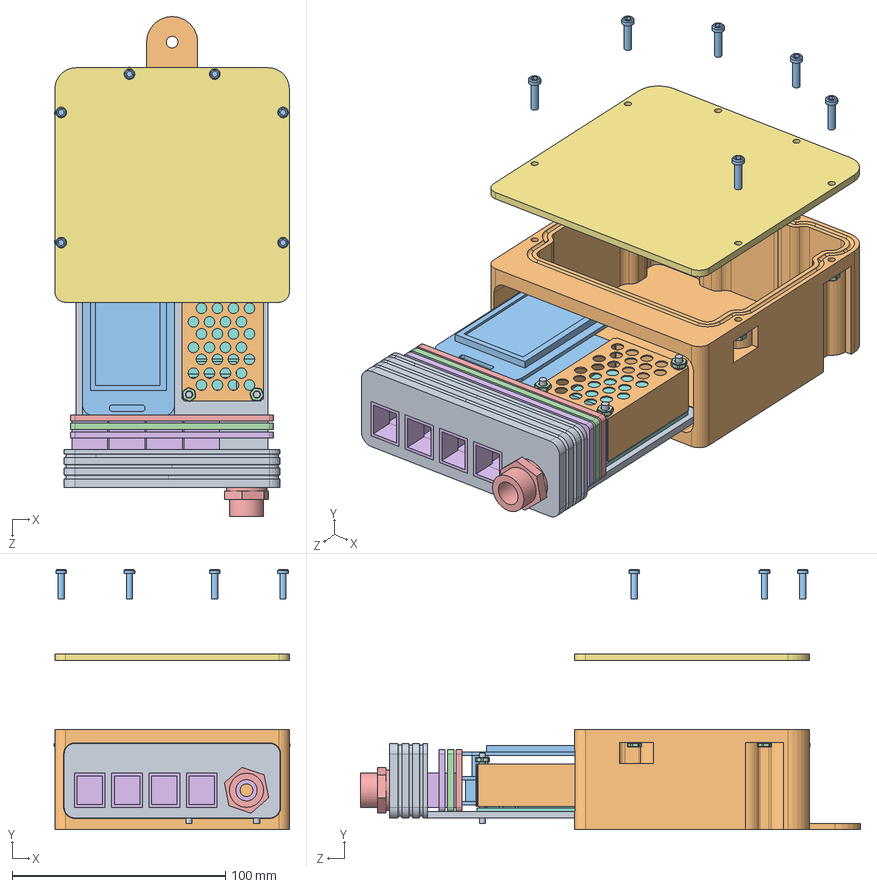
[picture p64: CAD file, 2023-03-17]
Project Files/Housing CAD design files/Update5.SLDASM
110.4 x 122.1 x 234.4 mm
Copy of Tray^Update5
Bolt x 6
Nut x 9
CableGland_1
RJ45 x 4
Acrylic_lid_latest
Part180^Update5
Part183^Update5 x 3
Part184^Update5
Part185^Update5
Copy of Part186
Copy (2) of Part186^Update5
Copy of Part186^Update5
