kaichodesu/sotond5/Project Files/Housing CAD design files/To Manufacture/3D Print/Body.STL

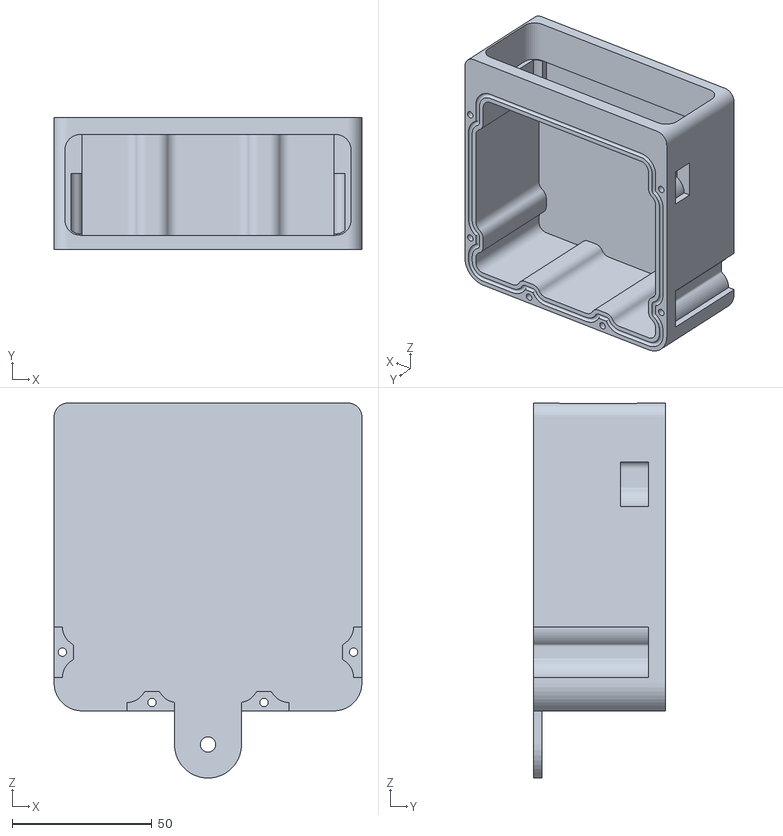
[picture p65: CAD file, 2023-03-17]
Project Files/Housing CAD design files/To Manufacture/3D Print/Body.STL
110.0 x 47.0 x 134.0
