kaichodesu/sotond5/Project Files/Housing CAD design files/To Manufacture/Laser Cut/Clear Acrylic 3mm.DXF

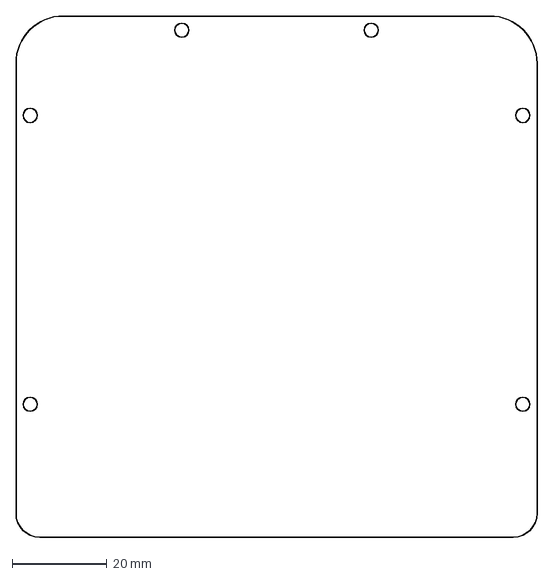
[picture p66: CAD file, 2023-03-17]
Project Files/Housing CAD design files/To Manufacture/Laser Cut/Clear Acrylic 3mm.DXF
110.0 x 110.0 mm
