kaichodesu/sotond5/Project Files/PSU Simulations and OrCAD files/Version 3/TEA2209T_1J/3D/TEA2209T_1J.stp

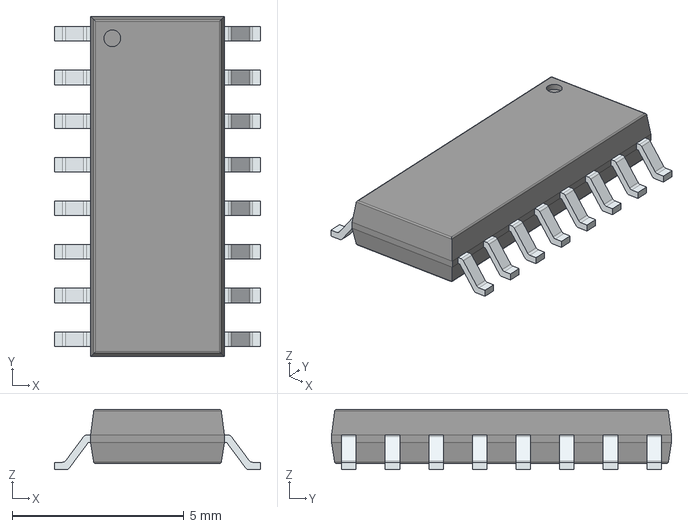
[picture p67: CAD file, 2023-03-17]
Project Files/PSU Simulations and OrCAD files/Version 3/TEA2209T_1J/3D/TEA2209T_1J.stp
6.00 x 9.90 x 1.75 mm
PinsArrayLR
