kaichodesu/sotond5/Project Files/Schematics and PCB Layout/D5/PSU.step

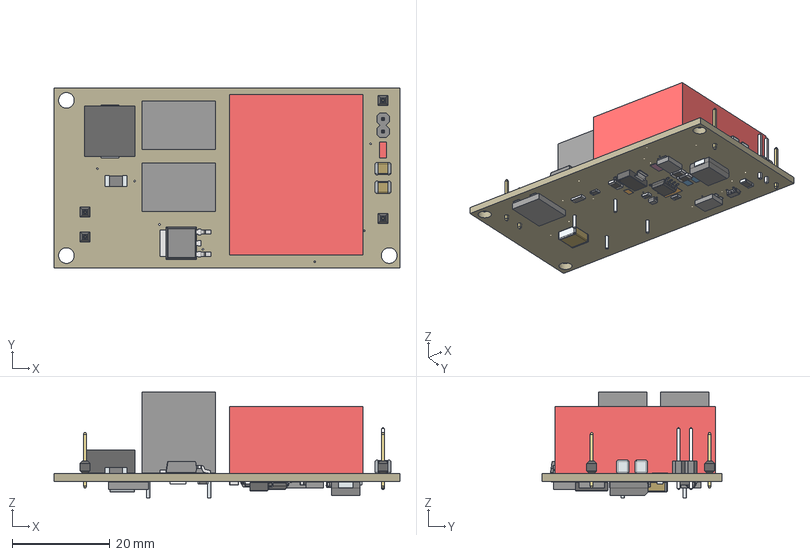
[picture p68: CAD file, 2023-03-17]
Project Files/Schematics and PCB Layout/D5/PSU.step
70.8 x 36.8 x 21.6 mm
Board
Pins
Pins (1)
FilletPinL
FilletPinR
Pins (2)
BODY-SO
LEAD-D0007A x 7
BODY-SOT
LEAD-SOT x 5
LEAD-DUMMY
1X01
1X01 (1)
1X02
APHD1608LCGCK
IPN70R1K2P7SATMA1
FQD2P40TM
820m
5k
ERA-8ARW7152V
ERA-6AEB2742V
solidBody
Terminal
solidTop
term1
term2
ERA-6AEB2742V_1
solidBody (1)
solidTop (1)
solidTerminal1
solidTerminal2
solidTerminal3
UDZLVTE-17150
Leads
CL21A475KLCLQNC x 2
CRCW12062M74FKEA
term1 (1)
term2 (1)
term1 (2)
term2 (2)
1X01 (2)
1X01 (3)
Leads (1)
INDDFN1000X1000X480-2N
FilletPin1
FilletPin2
