kaichodesu/sotond5/Project Files/Schematics and PCB Layout/EAGLE CAM Design Rules/lbr/1C20C0G220J050B/3D/1C20C0G220J050B.stp

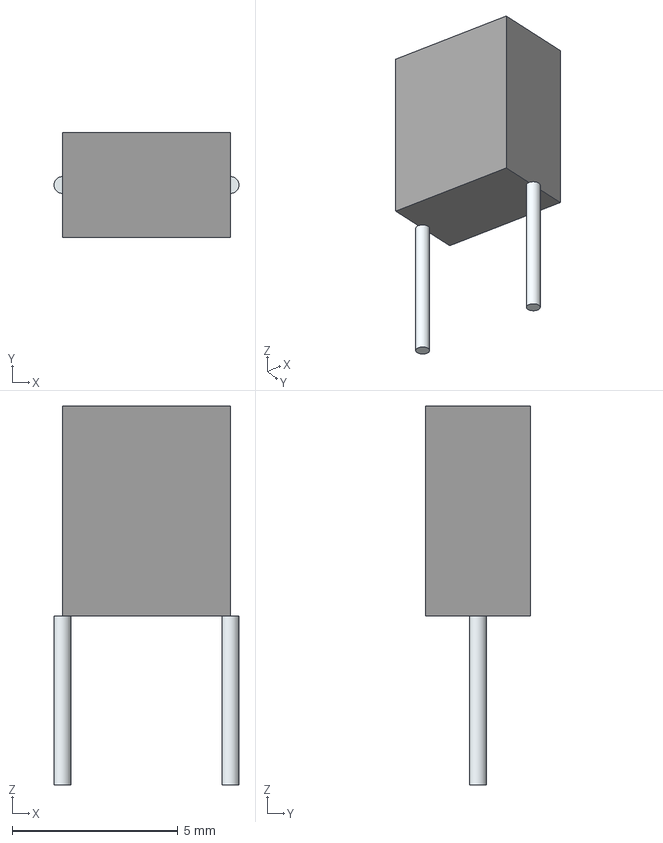
[picture p69: CAD file, 2023-03-17]
Project Files/Schematics and PCB Layout/EAGLE CAM Design Rules/lbr/1C20C0G220J050B/3D/1C20C0G220J050B.stp
5.59 x 3.18 x 11.4 mm
Leads x 2
