kaichodesu/sotond5/Project Files/Schematics and PCB Layout/EAGLE CAM Design Rules/lbr/1SS406,H3F/3D/1SS406,H3F.stp

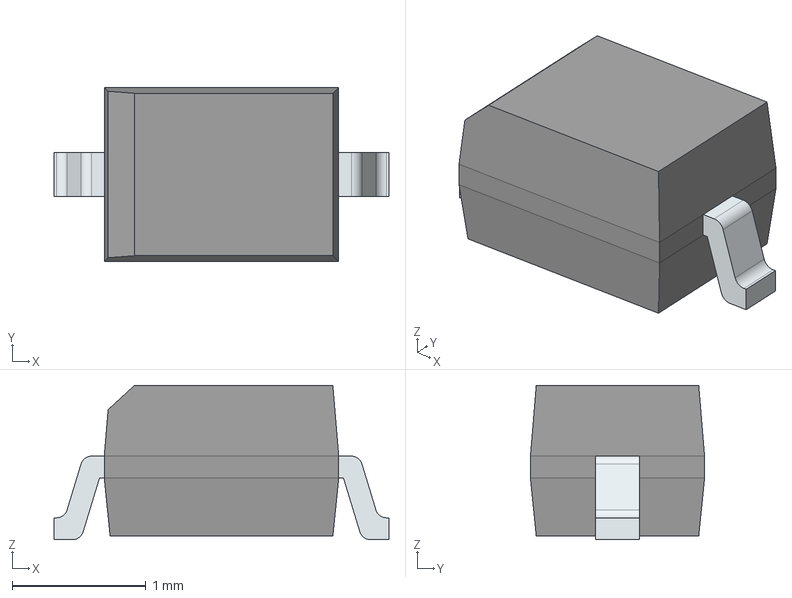
[picture p70: CAD file, 2023-03-17]
Project Files/Schematics and PCB Layout/EAGLE CAM Design Rules/lbr/1SS406,H3F/3D/1SS406,H3F.stp
2.50 x 1.30 x 1.15 mm
FilletPinL
FilletPinR
