kaichodesu/sotond5/Project Files/Schematics and PCB Layout/EAGLE CAM Design Rules/lbr/35SVPD8R2M/3D/35SVPD8R2M.stp

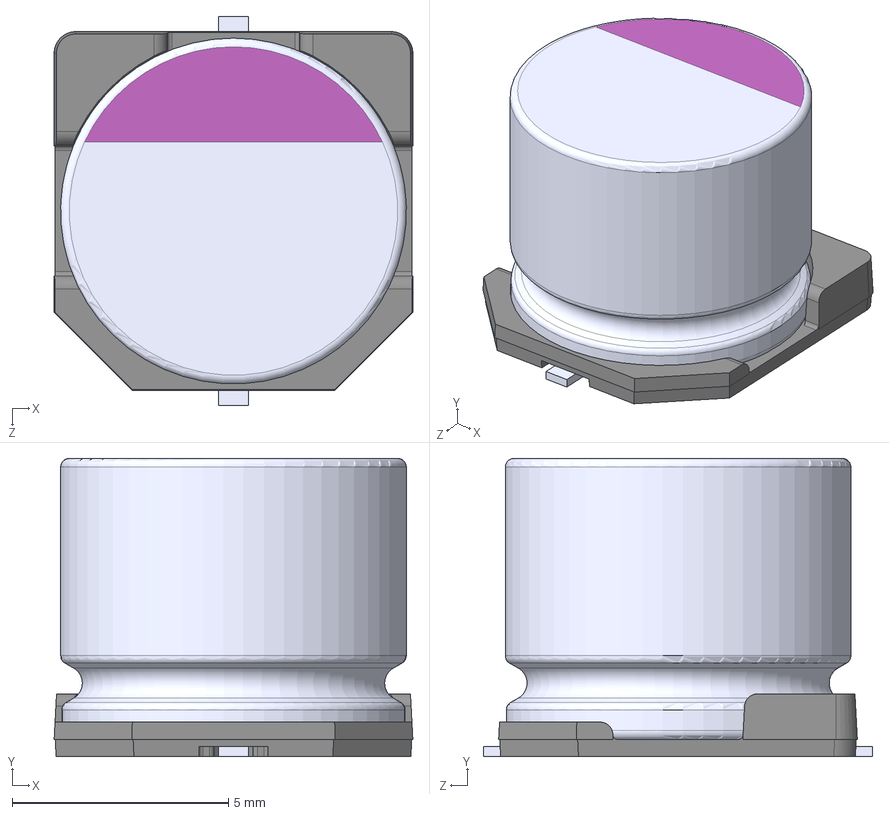
[picture p71: CAD file, 2023-03-17]
Project Files/Schematics and PCB Layout/EAGLE CAM Design Rules/lbr/35SVPD8R2M/3D/35SVPD8R2M.stp
8.30 x 6.90 x 9.00 mm
