kaichodesu/sotond5/Project Files/Schematics and PCB Layout/EAGLE CAM Design Rules/lbr/3v3/3D/MCP1799-3302H_DB.stp

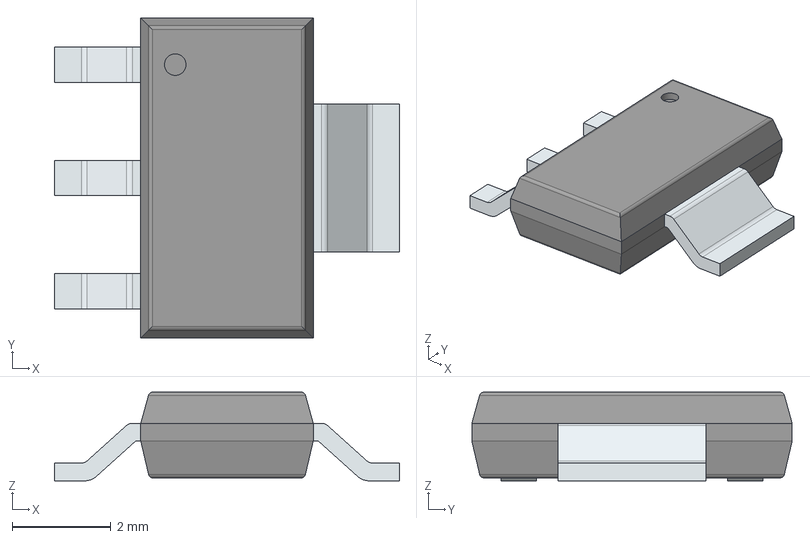
[picture p72: CAD file, 2023-03-17]
Project Files/Schematics and PCB Layout/EAGLE CAM Design Rules/lbr/3v3/3D/MCP1799-3302H_DB.stp
7.00 x 6.50 x 1.80 mm
PinsArrayL
FilletPinR
