kaichodesu/sotond5/Project Files/Schematics and PCB Layout/EAGLE CAM Design Rules/lbr/ACGRAT103L-HF/3D/ACGRAT103L-HF.stp

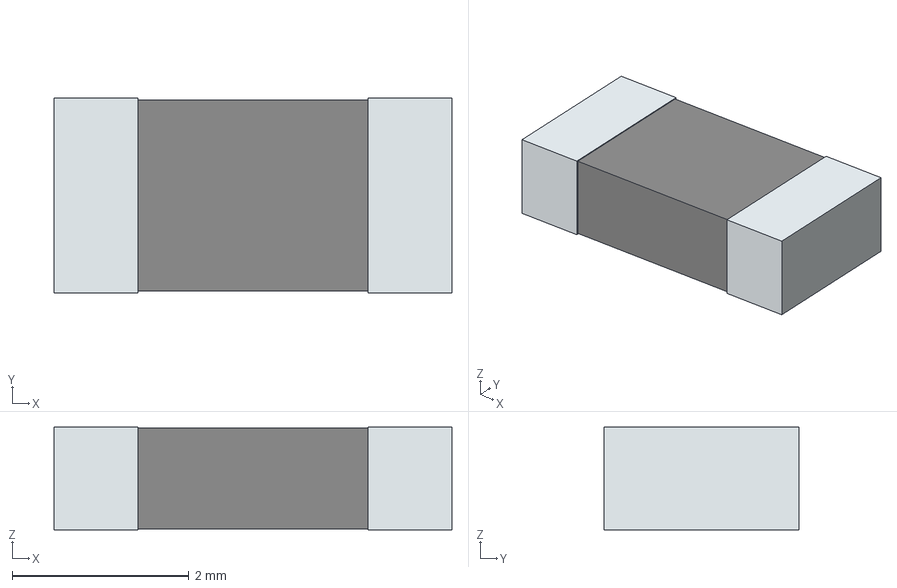
[picture p73: CAD file, 2023-03-17]
Project Files/Schematics and PCB Layout/EAGLE CAM Design Rules/lbr/ACGRAT103L-HF/3D/ACGRAT103L-HF.stp
4.50 x 2.20 x 1.16 mm
term1
term2
