kaichodesu/sotond5/Project Files/Schematics and PCB Layout/EAGLE CAM Design Rules/lbr/APHD1608LCGCK/3D/APHD1608LCGCK.stp

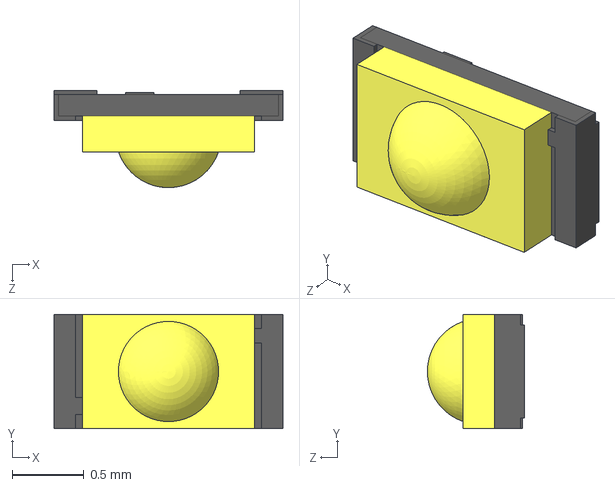
[picture p74: CAD file, 2023-03-17]
Project Files/Schematics and PCB Layout/EAGLE CAM Design Rules/lbr/APHD1608LCGCK/3D/APHD1608LCGCK.stp
1.60 x 0.8 x 0.68 mm
