kaichodesu/sotond5/Project Files/Schematics and PCB Layout/EAGLE CAM Design Rules/lbr/ATMEGA644P-20PU/3D/ATMEGA644P-20PU.stp

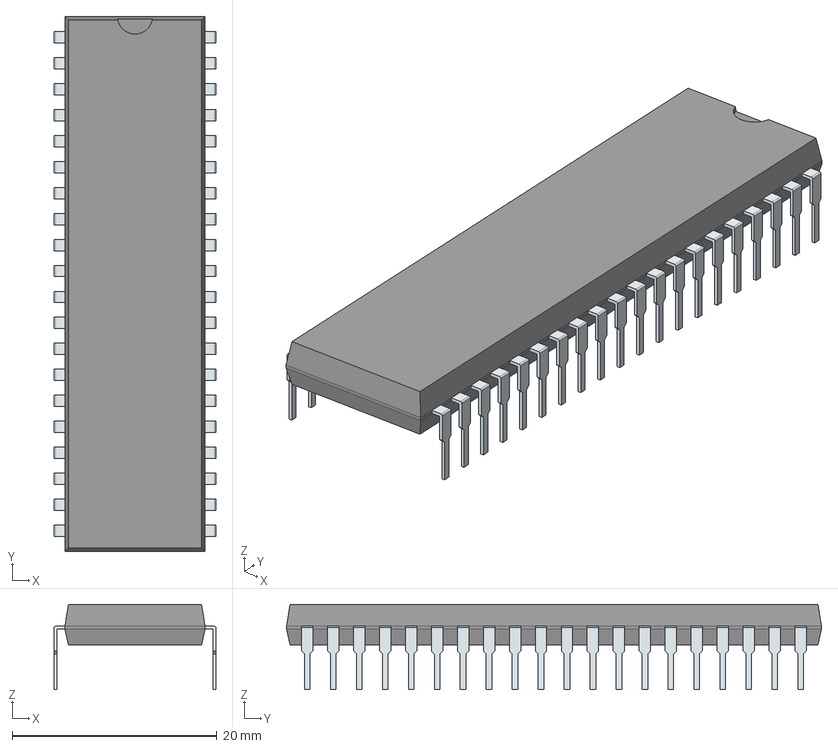
[picture p75: CAD file, 2023-03-17]
Project Files/Schematics and PCB Layout/EAGLE CAM Design Rules/lbr/ATMEGA644P-20PU/3D/ATMEGA644P-20PU.stp
15.8 x 52.3 x 8.33 mm
PinsArrayLR
