kaichodesu/sotond5/Project Files/Schematics and PCB Layout/EAGLE CAM Design Rules/lbr/BAS3007ARPPE6327HTSA1/3D/BAS3007ARPPE6327HTSA1.stp

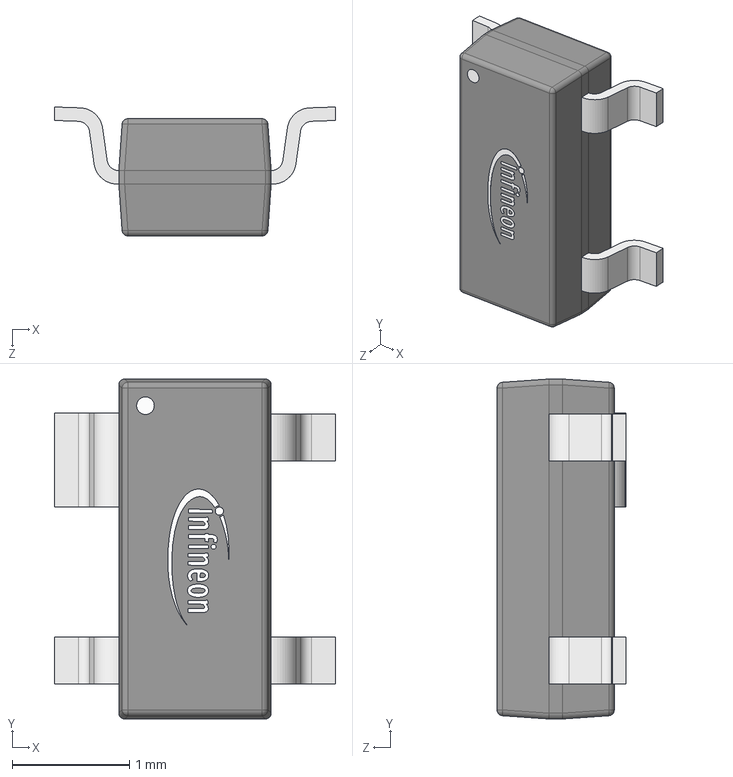
[picture p76: CAD file, 2023-03-17]
Project Files/Schematics and PCB Layout/EAGLE CAM Design Rules/lbr/BAS3007ARPPE6327HTSA1/3D/BAS3007ARPPE6327HTSA1.stp
2.40 x 2.90 x 1.10 mm
BAS70-07E6327
Infineon_Logo_1.4mm-LAPTOP-NQA1DCQ3
