kaichodesu/sotond5/Project Files/Schematics and PCB Layout/EAGLE CAM Design Rules/lbr/BZX84C3V3-7-F/3D/BZX84C3V3-7-F.stp

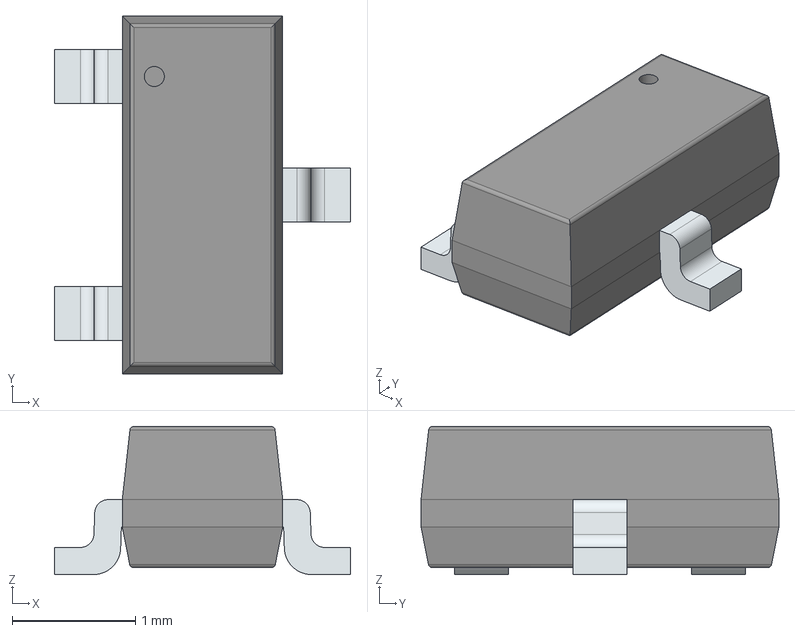
[picture p77: CAD file, 2023-03-17]
Project Files/Schematics and PCB Layout/EAGLE CAM Design Rules/lbr/BZX84C3V3-7-F/3D/BZX84C3V3-7-F.stp
2.40 x 2.90 x 1.20 mm
PinsArrayL
FilletPinR
