kaichodesu/sotond5/Project Files/Schematics and PCB Layout/EAGLE CAM Design Rules/lbr/C315C220J2G5TA/3D/C315C220J2G5TA.stp

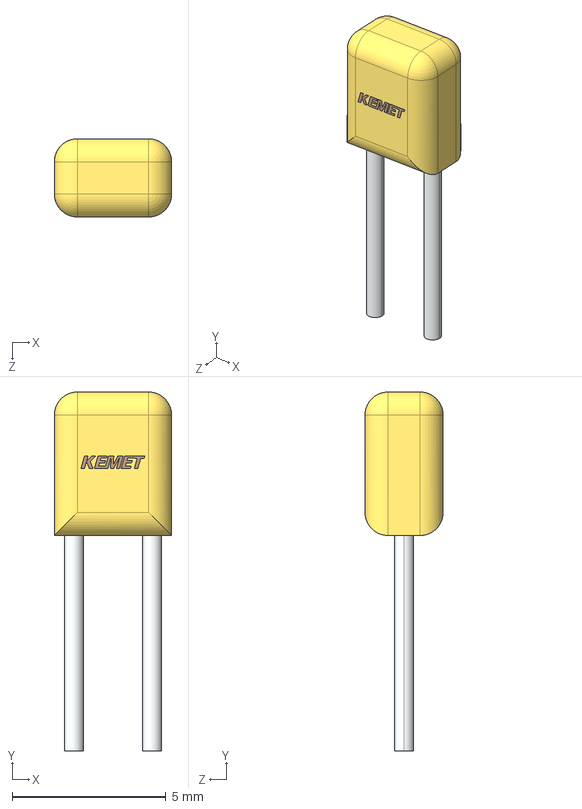
[picture p78: CAD file, 2023-03-17]
Project Files/Schematics and PCB Layout/EAGLE CAM Design Rules/lbr/C315C220J2G5TA/3D/C315C220J2G5TA.stp
3.81 x 11.7 x 2.54 mm
