kaichodesu/sotond5/Project Files/Schematics and PCB Layout/EAGLE CAM Design Rules/lbr/CD-DF406SL/3D/CD-DF406SL.stp

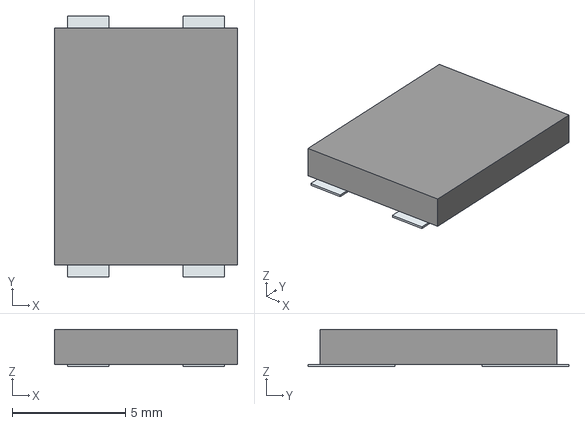
[picture p79: CAD file, 2023-03-17]
Project Files/Schematics and PCB Layout/EAGLE CAM Design Rules/lbr/CD-DF406SL/3D/CD-DF406SL.stp
8.10 x 11.5 x 1.65 mm
Pins
