kaichodesu/sotond5/Project Files/Schematics and PCB Layout/EAGLE CAM Design Rules/lbr/CD214B-FS2K/3D/CD214B-FS2K.stp

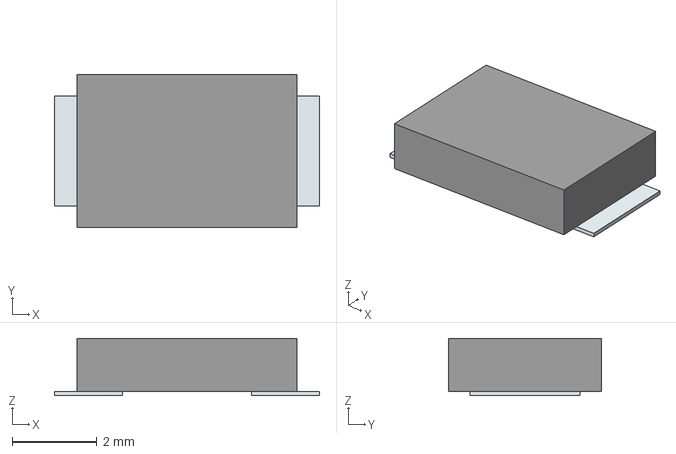
[picture p80: CAD file, 2023-03-17]
Project Files/Schematics and PCB Layout/EAGLE CAM Design Rules/lbr/CD214B-FS2K/3D/CD214B-FS2K.stp
6.25 x 3.60 x 1.35 mm
Pins
