kaichodesu/sotond5/Project Files/Schematics and PCB Layout/EAGLE CAM Design Rules/lbr/CDBC5200-HF/3D/CDBC5200-HF.stp

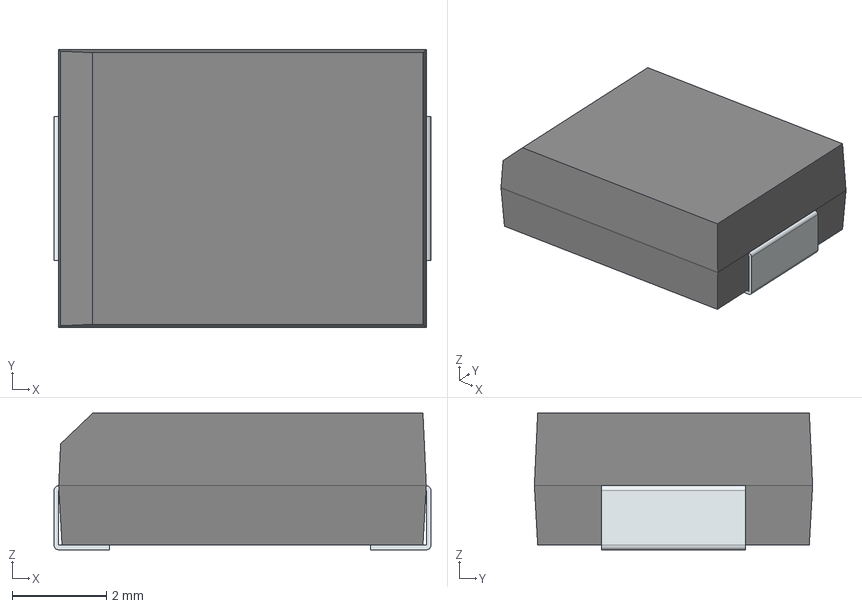
[picture p81: CAD file, 2023-03-17]
Project Files/Schematics and PCB Layout/EAGLE CAM Design Rules/lbr/CDBC5200-HF/3D/CDBC5200-HF.stp
8.00 x 5.91 x 2.90 mm
FilletPin1
FilletPin2
