kaichodesu/sotond5/Project Files/Schematics and PCB Layout/EAGLE CAM Design Rules/lbr/CL21A475KLCLQNC/3D/CL21A475KLCLQNC.stp

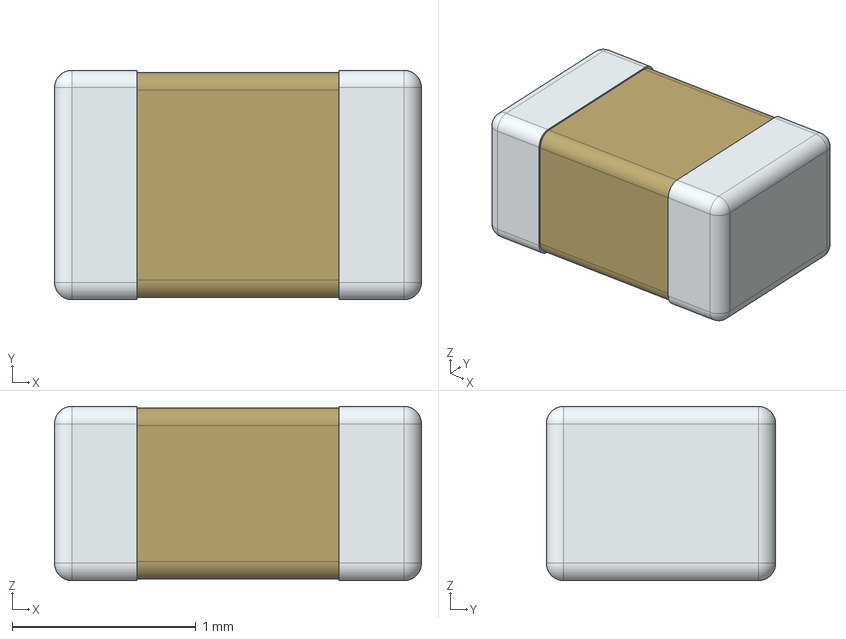
[picture p82: CAD file, 2023-03-17]
Project Files/Schematics and PCB Layout/EAGLE CAM Design Rules/lbr/CL21A475KLCLQNC/3D/CL21A475KLCLQNC.stp
2.00 x 1.25 x 0.95 mm
