kaichodesu/sotond5/Project Files/Schematics and PCB Layout/EAGLE CAM Design Rules/lbr/CR0603-FX-4701ELF/3D/CR0603-FX-4701ELF.stp

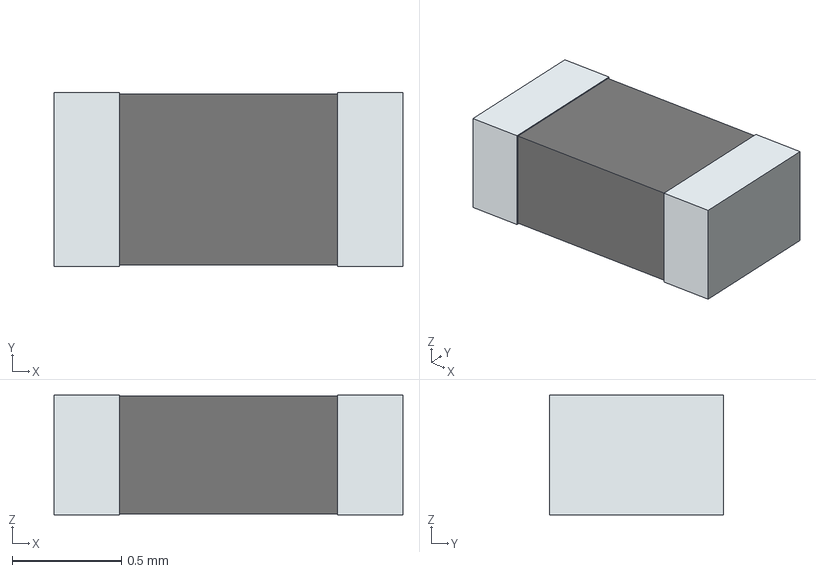
[picture p83: CAD file, 2023-03-17]
Project Files/Schematics and PCB Layout/EAGLE CAM Design Rules/lbr/CR0603-FX-4701ELF/3D/CR0603-FX-4701ELF.stp
1.60 x 0.8 x 0.55 mm
term1
term2
