kaichodesu/sotond5/Project Files/Schematics and PCB Layout/EAGLE CAM Design Rules/lbr/CR1206-FX-6491ELF/3D/CR1206-FX-6491ELF.stp

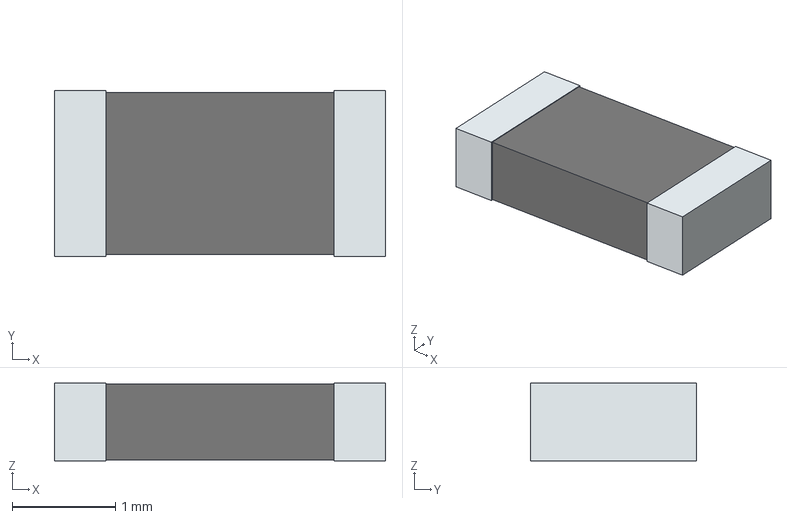
[picture p84: CAD file, 2023-03-17]
Project Files/Schematics and PCB Layout/EAGLE CAM Design Rules/lbr/CR1206-FX-6491ELF/3D/CR1206-FX-6491ELF.stp
3.20 x 1.60 x 0.75 mm
term1
term2
