kaichodesu/sotond5/Project Files/Schematics and PCB Layout/EAGLE CAM Design Rules/lbr/CRCW0805200MJPEAHR/3D/CRCW0805200MJPEAHR.stp

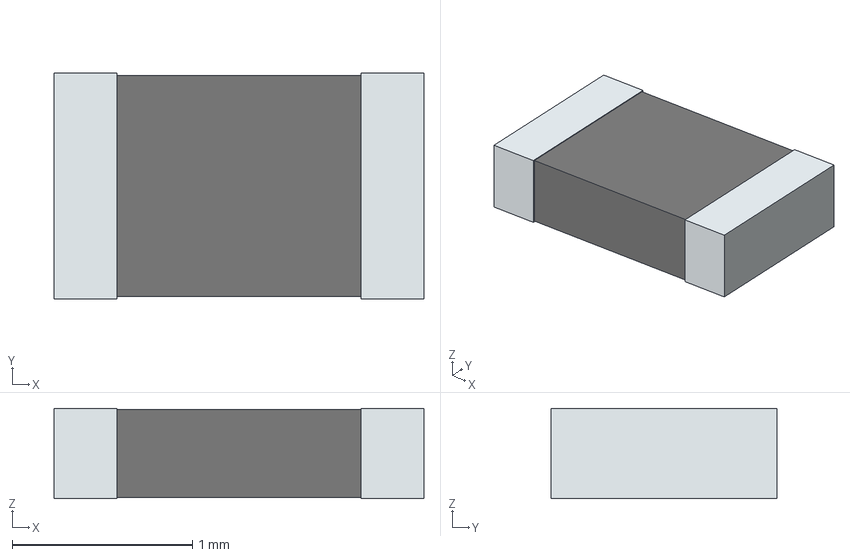
[picture p85: CAD file, 2023-03-17]
Project Files/Schematics and PCB Layout/EAGLE CAM Design Rules/lbr/CRCW0805200MJPEAHR/3D/CRCW0805200MJPEAHR.stp
2.05 x 1.25 x 0.5 mm
term1
term2
