kaichodesu/sotond5/Project Files/Schematics and PCB Layout/EAGLE CAM Design Rules/lbr/CRCW12062M74FKEA/3D/CRCW12062M74FKEA.stp

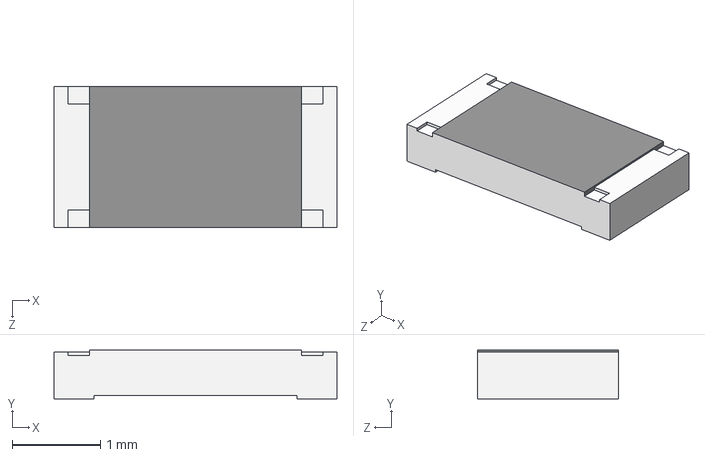
[picture p86: CAD file, 2023-03-17]
Project Files/Schematics and PCB Layout/EAGLE CAM Design Rules/lbr/CRCW12062M74FKEA/3D/CRCW12062M74FKEA.stp
3.20 x 0.55 x 1.60 mm
