kaichodesu/sotond5/Project Files/Schematics and PCB Layout/EAGLE CAM Design Rules/lbr/CRMA1206AF6M00DKEF/3D/CRMA1206AF6M00DKEF.stp

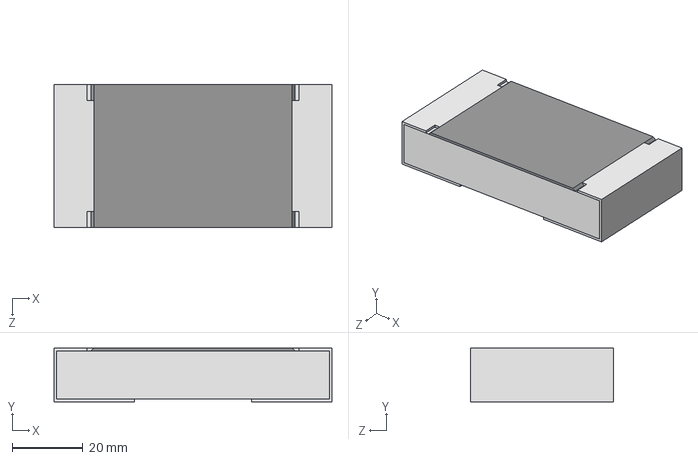
[picture p87: CAD file, 2023-03-17]
Project Files/Schematics and PCB Layout/EAGLE CAM Design Rules/lbr/CRMA1206AF6M00DKEF/3D/CRMA1206AF6M00DKEF.stp
78.7 x 15.2 x 40.6 mm
