kaichodesu/sotond5/Project Files/Schematics and PCB Layout/EAGLE CAM Design Rules/lbr/EG1218/3D/EG1218.stp

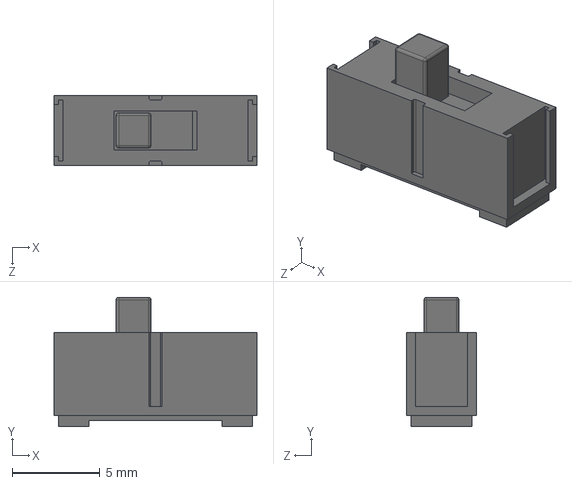
[picture p88: CAD file, 2023-03-17]
Project Files/Schematics and PCB Layout/EAGLE CAM Design Rules/lbr/EG1218/3D/EG1218.stp
11.6 x 7.40 x 4.00 mm
