kaichodesu/sotond5/Project Files/Schematics and PCB Layout/EAGLE CAM Design Rules/lbr/EMK325ABJ107MM-T/3D/EMK325ABJ107MM-T.stp

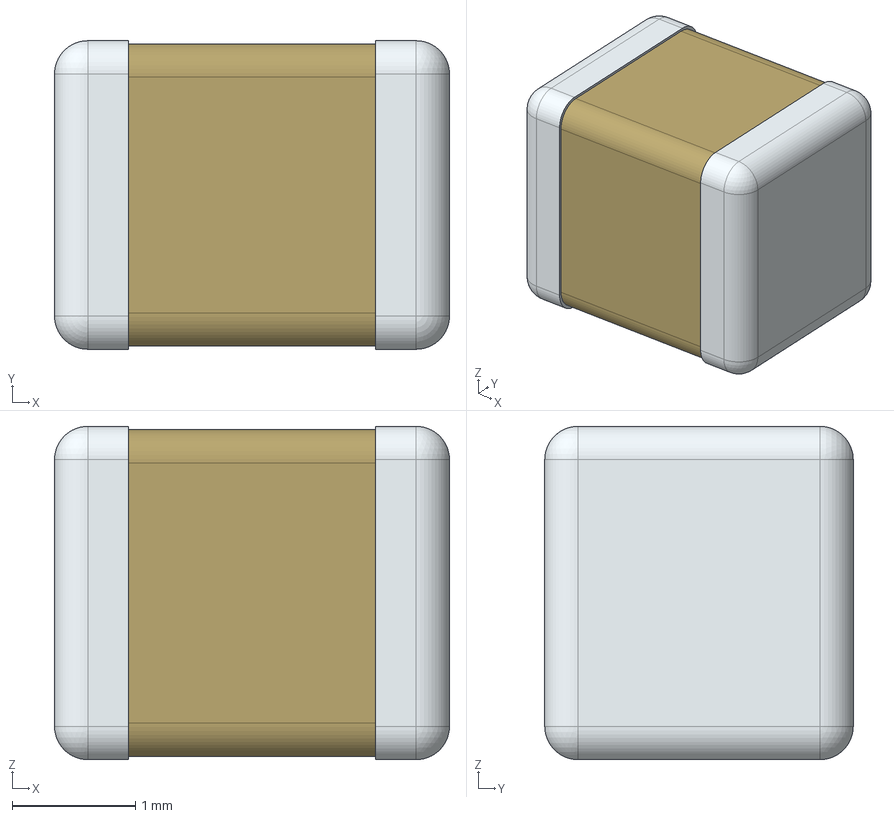
[picture p89: CAD file, 2023-03-17]
Project Files/Schematics and PCB Layout/EAGLE CAM Design Rules/lbr/EMK325ABJ107MM-T/3D/EMK325ABJ107MM-T.stp
3.20 x 2.50 x 2.70 mm
