kaichodesu/sotond5/Project Files/Schematics and PCB Layout/EAGLE CAM Design Rules/lbr/ERA-6AEB2742V/3D/ERA-6AEB2742V.stp

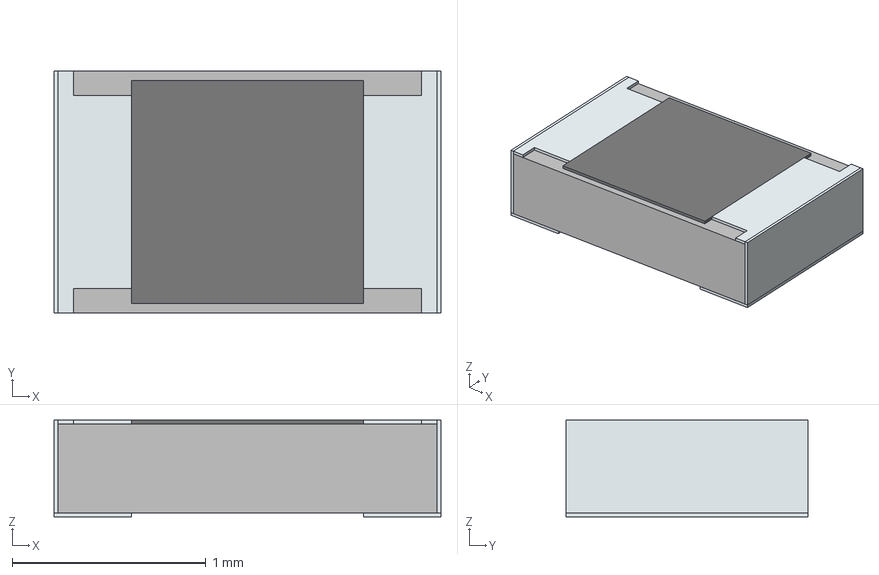
[picture p90: CAD file, 2023-03-17]
Project Files/Schematics and PCB Layout/EAGLE CAM Design Rules/lbr/ERA-6AEB2742V/3D/ERA-6AEB2742V.stp
2.00 x 1.25 x 0.5 mm
solidBody
solidTop
solidTerminal1
solidTerminal2
solidTerminal3
