kaichodesu/sotond5/Project Files/Schematics and PCB Layout/EAGLE CAM Design Rules/lbr/ERA-6VEB1000V/3D/ERA-6VEB1000V.stp

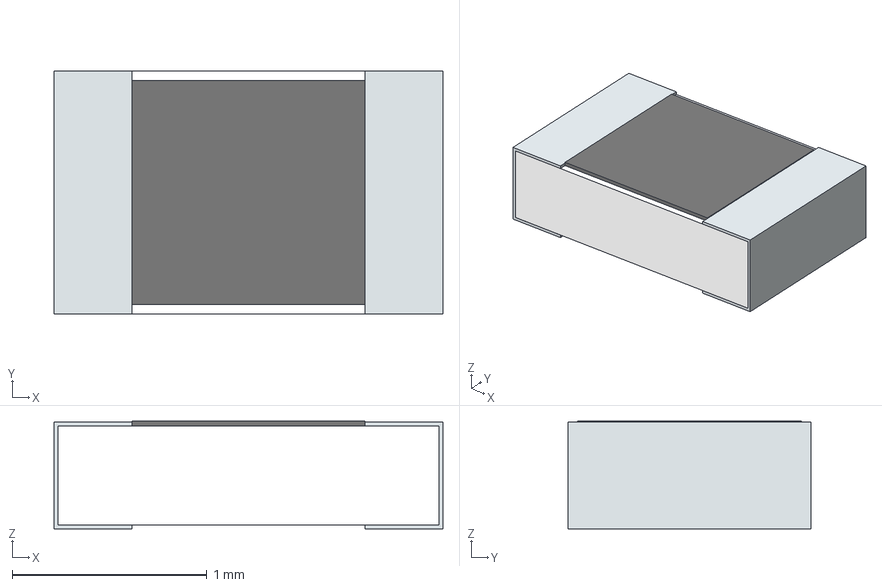
[picture p91: CAD file, 2023-03-17]
Project Files/Schematics and PCB Layout/EAGLE CAM Design Rules/lbr/ERA-6VEB1000V/3D/ERA-6VEB1000V.stp
2.00 x 1.25 x 0.555 mm
solidBody
Terminal
solidTop
