kaichodesu/sotond5/Project Files/Schematics and PCB Layout/EAGLE CAM Design Rules/lbr/ERA-8ARW7152V/3D/ERA-8ARW7152V.stp

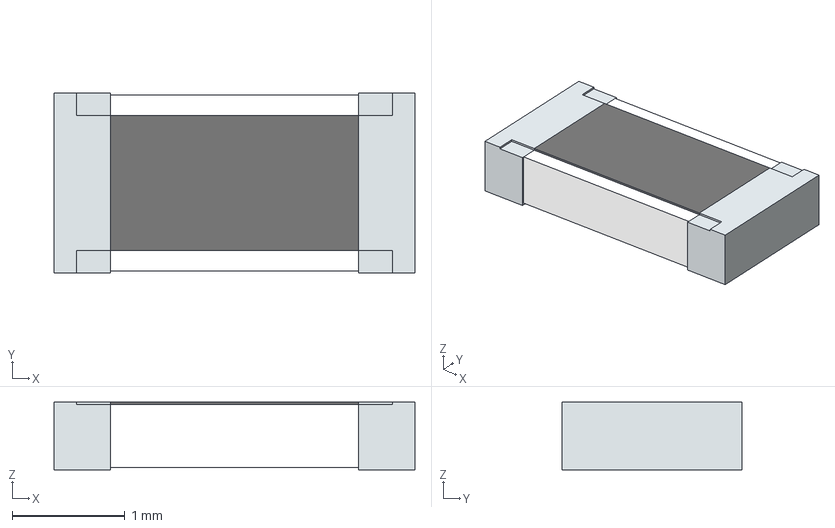
[picture p92: CAD file, 2023-03-17]
Project Files/Schematics and PCB Layout/EAGLE CAM Design Rules/lbr/ERA-8ARW7152V/3D/ERA-8ARW7152V.stp
3.20 x 1.60 x 0.6 mm
solidBody
Terminal
solidTop
