kaichodesu/sotond5/Project Files/Schematics and PCB Layout/EAGLE CAM Design Rules/lbr/F861BB104M310A/3D/F861BB104M310A.stp

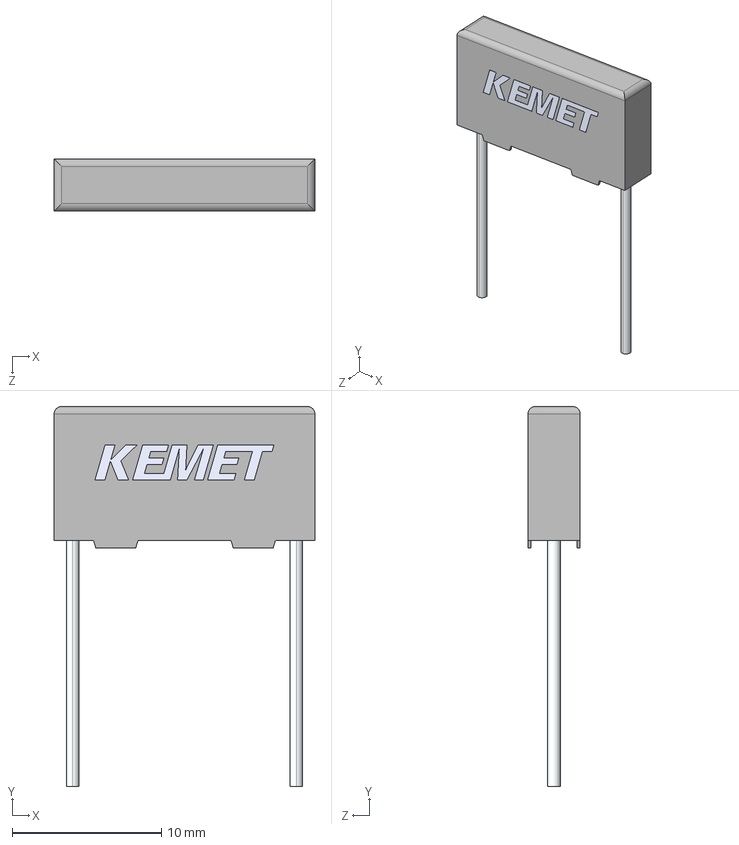
[picture p93: CAD file, 2023-03-17]
Project Files/Schematics and PCB Layout/EAGLE CAM Design Rules/lbr/F861BB104M310A/3D/F861BB104M310A.stp
17.5 x 25.5 x 3.50 mm
