kaichodesu/sotond5/Project Files/Schematics and PCB Layout/EAGLE CAM Design Rules/lbr/FQD2P40TM/3D/FQD2P40TM.stp

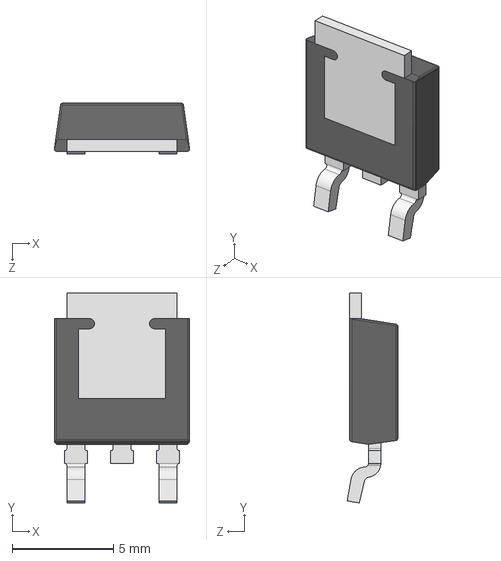
[picture p94: CAD file, 2023-03-17]
Project Files/Schematics and PCB Layout/EAGLE CAM Design Rules/lbr/FQD2P40TM/3D/FQD2P40TM.stp
6.70 x 10.4 x 2.51 mm
