kaichodesu/sotond5/Project Files/Schematics and PCB Layout/EAGLE CAM Design Rules/lbr/FSM4JH/3D/FSM4JH.stp

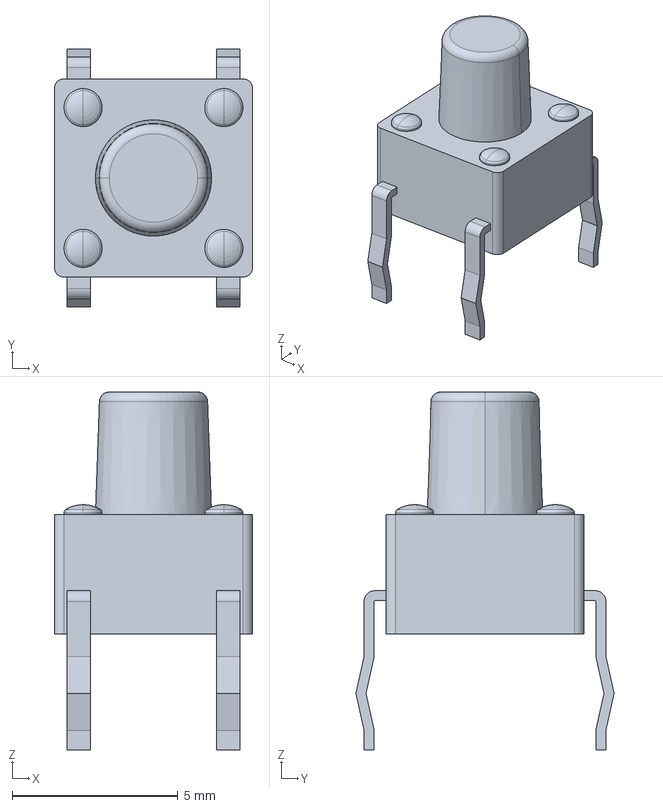
[picture p95: CAD file, 2023-03-17]
Project Files/Schematics and PCB Layout/EAGLE CAM Design Rules/lbr/FSM4JH/3D/FSM4JH.stp
5.99 x 7.80 x 10.8 mm
