kaichodesu/sotond5/Project Files/Schematics and PCB Layout/EAGLE CAM Design Rules/lbr/MBR5U100-TP/3D/MBR5U100-TP.stp

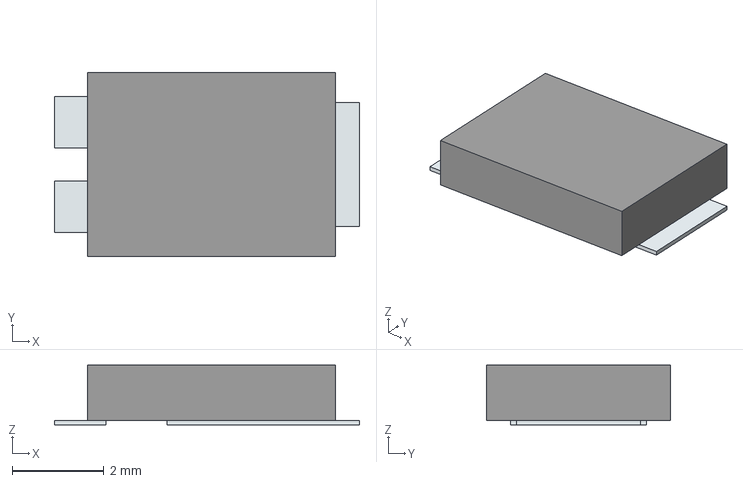
[picture p97: CAD file, 2023-03-17]
Project Files/Schematics and PCB Layout/EAGLE CAM Design Rules/lbr/MBR5U100-TP/3D/MBR5U100-TP.stp
6.63 x 4.00 x 1.30 mm
Pins
