kaichodesu/sotond5/Project Files/Schematics and PCB Layout/EAGLE CAM Design Rules/lbr/R463I32204002M/3D/R463I32204002M.stp

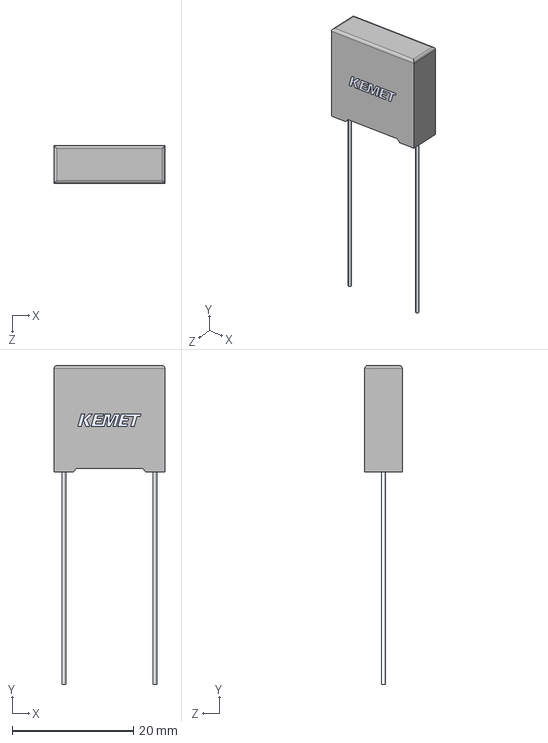
[picture p98: CAD file, 2023-03-17]
Project Files/Schematics and PCB Layout/EAGLE CAM Design Rules/lbr/R463I32204002M/3D/R463I32204002M.stp
18.3 x 52.6 x 6.20 mm
