kaichodesu/sotond5/Project Files/Schematics and PCB Layout/EAGLE CAM Design Rules/lbr/R523I322050P0K/3D/R523I322050P0K.stp

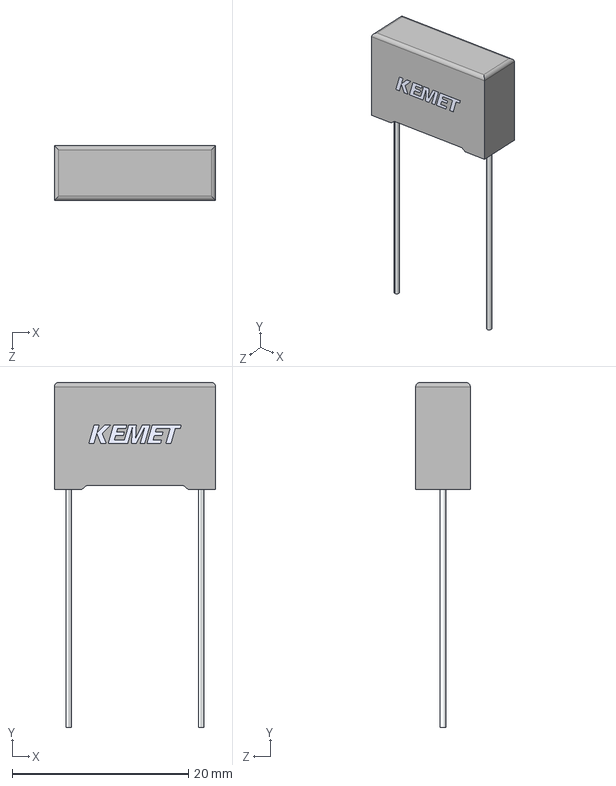
[picture p99: CAD file, 2023-03-17]
Project Files/Schematics and PCB Layout/EAGLE CAM Design Rules/lbr/R523I322050P0K/3D/R523I322050P0K.stp
18.3 x 39.1 x 6.20 mm
