kaichodesu/sotond5/Project Files/Schematics and PCB Layout/EAGLE CAM Design Rules/lbr/SSM3K15AFS,LF/3D/SSM3K15AFS,LF.stp

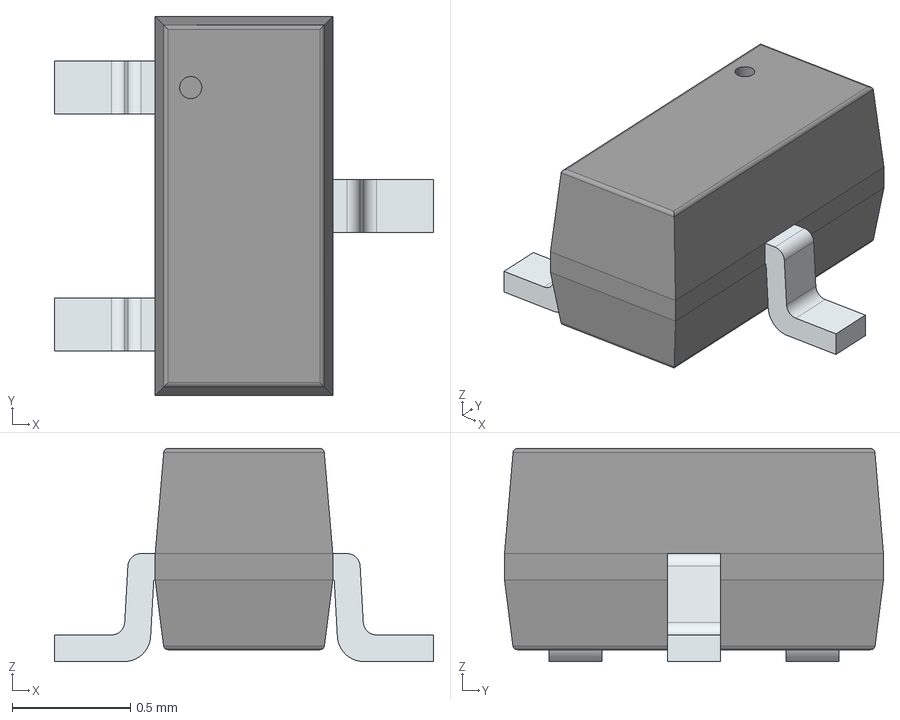
[picture p100: CAD file, 2023-03-17]
Project Files/Schematics and PCB Layout/EAGLE CAM Design Rules/lbr/SSM3K15AFS,LF/3D/SSM3K15AFS,LF.stp
1.60 x 1.60 x 0.9 mm
PinsArrayL
FilletPinR
