kaichodesu/sotond5/Project Files/Schematics and PCB Layout/EAGLE CAM Design Rules/lbr/UA78M05IDCYR/3D/UA78M05IDCYR.stp

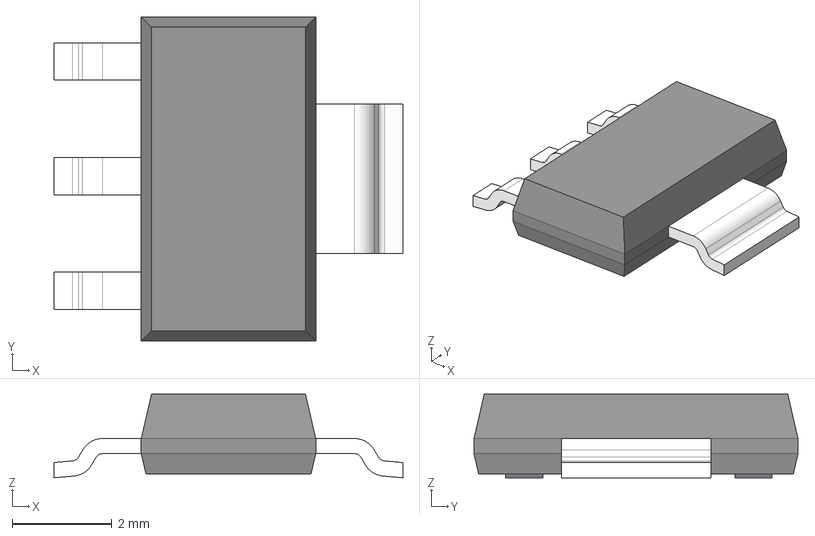
[picture p101: CAD file, 2023-03-17]
Project Files/Schematics and PCB Layout/EAGLE CAM Design Rules/lbr/UA78M05IDCYR/3D/UA78M05IDCYR.stp
7.00 x 6.50 x 1.68 mm
BODY-SOT
LEAD-SOT x 3
LEAD-SOT-WIDE
PIN1-ID
