kaichodesu/sotond5/Project Files/Schematics and PCB Layout/EAGLE CAM Design Rules/lbr/UDZLVTE-17150/3D/UDZLVTE-17150.stp

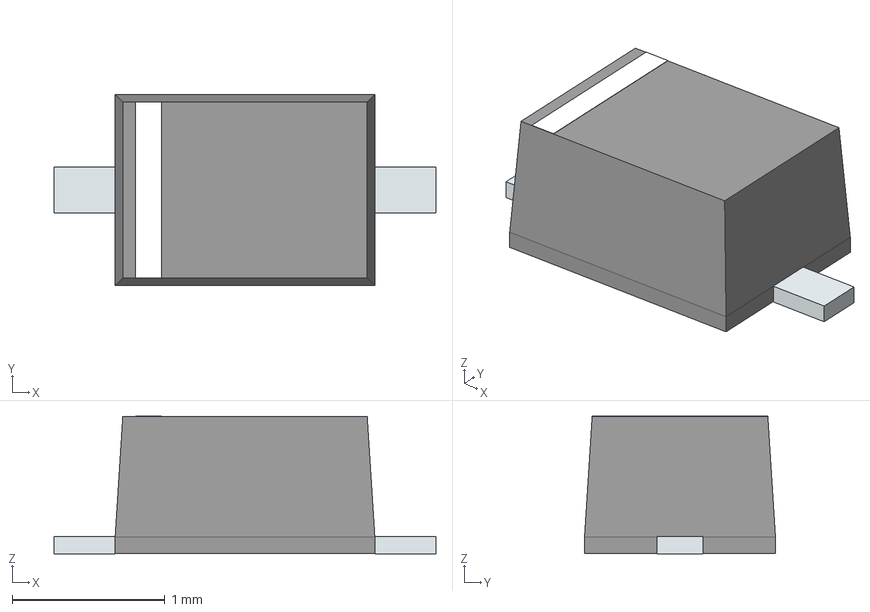
[picture p102: CAD file, 2023-03-17]
Project Files/Schematics and PCB Layout/EAGLE CAM Design Rules/lbr/UDZLVTE-17150/3D/UDZLVTE-17150.stp
2.50 x 1.25 x 0.9 mm
PinKIdent
PinK
PinA
