kaichodesu/sotond5/Project Files/Schematics and PCB Layout/EAGLE CAM Design Rules/lbr/VJ2220Y103KXUSTX2/3D/VJ2220Y103KXUSTX2.stp

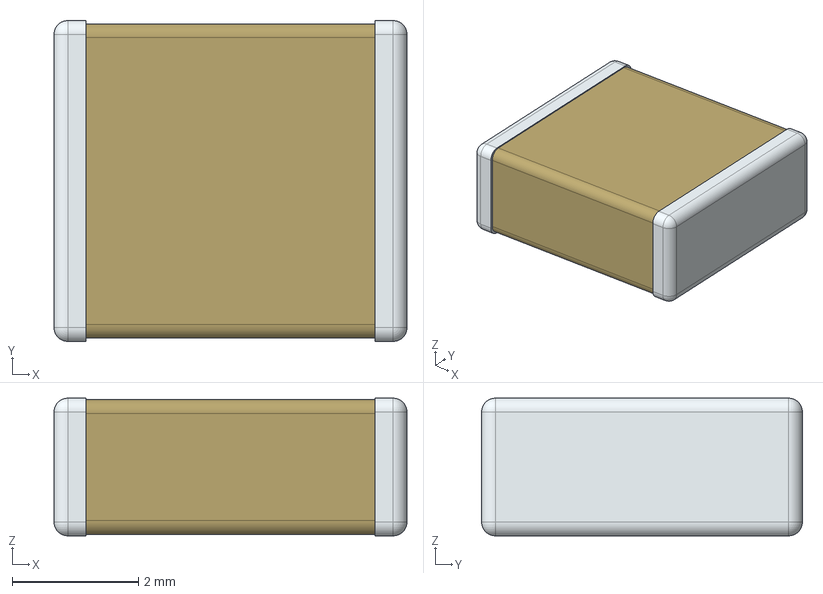
[picture p103: CAD file, 2023-03-17]
Project Files/Schematics and PCB Layout/EAGLE CAM Design Rules/lbr/VJ2220Y103KXUSTX2/3D/VJ2220Y103KXUSTX2.stp
5.59 x 5.08 x 2.18 mm
