kaichodesu/sotond5/Project Files/Schematics and PCB Layout/EAGLE CAM Design Rules/lbr/VY2472M41Y5VS63V7/3D/VY2472M41Y5VS63V7.stp

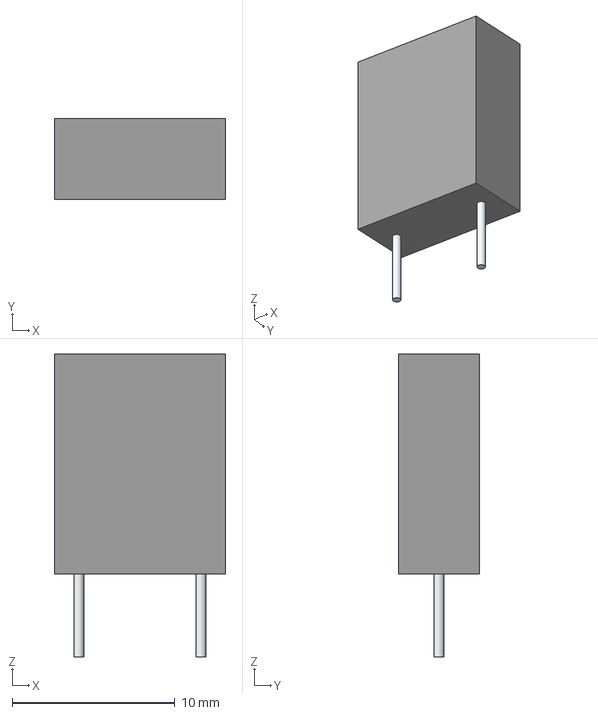
[picture p104: CAD file, 2023-03-17]
Project Files/Schematics and PCB Layout/EAGLE CAM Design Rules/lbr/VY2472M41Y5VS63V7/3D/VY2472M41Y5VS63V7.stp
10.5 x 5.00 x 18.6 mm
Leads
