kaichodesu/sotond5/Project Files/Schematics and PCB Layout/EAGLE CAM Design Rules/lbr/XT9S20ANA12M/3D/XT9S20ANA12M.stp

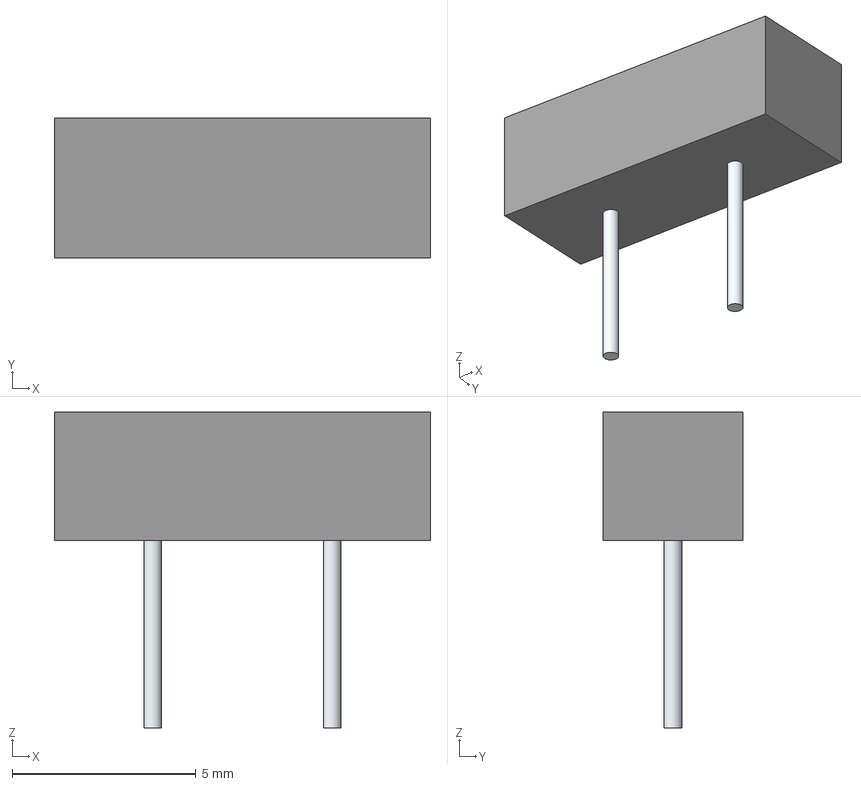
[picture p105: CAD file, 2023-03-17]
Project Files/Schematics and PCB Layout/EAGLE CAM Design Rules/lbr/XT9S20ANA12M/3D/XT9S20ANA12M.stp
10.2 x 3.81 x 8.60 mm
Leads x 2
