kaichodesu/sotond5/Project Files/Housing CAD design files/To Manufacture/3D Print/Tray.STL

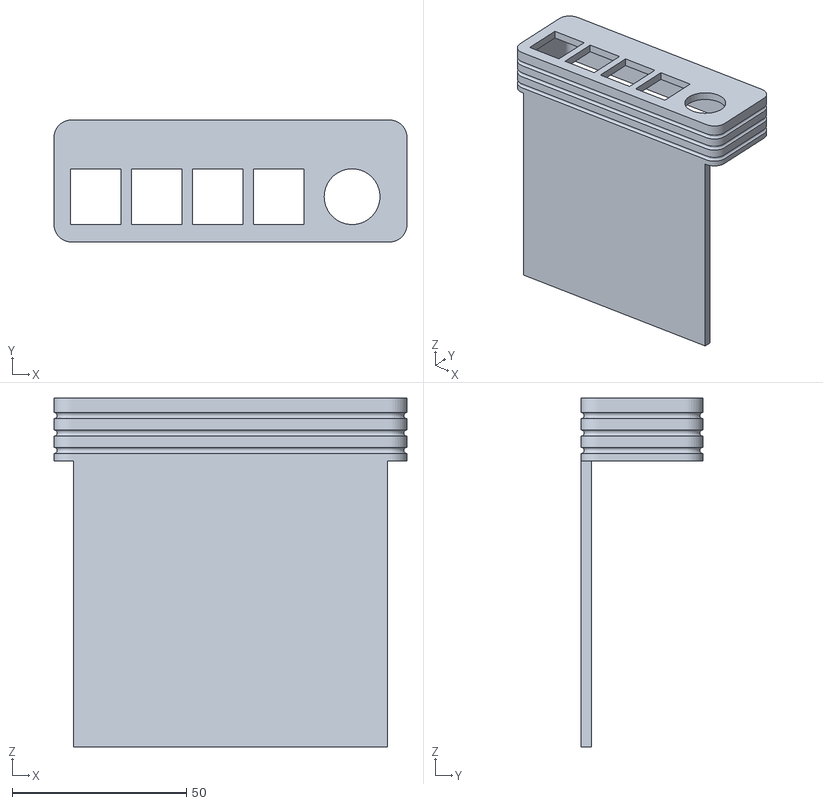
[picture p106: CAD file, 2023-03-17]
Project Files/Housing CAD design files/To Manufacture/3D Print/Tray.STL
101.2 x 35.0 x 100.0
