kaichodesu/sotond5/Project Files/Housing CAD design files/To Manufacture/Laser Cut/Gasket Sheet.DXF

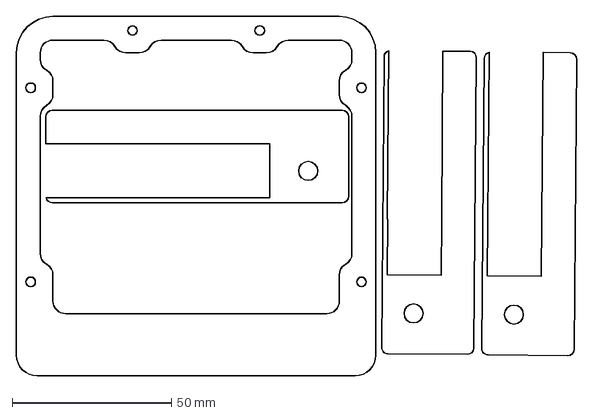
[picture p107: CAD file, 2023-03-17]
Project Files/Housing CAD design files/To Manufacture/Laser Cut/Gasket Sheet.DXF
176.1 x 113.0 mm
