kaichodesu/sotond5/Project Files/Housing CAD design files/RJ45.SLDPRT

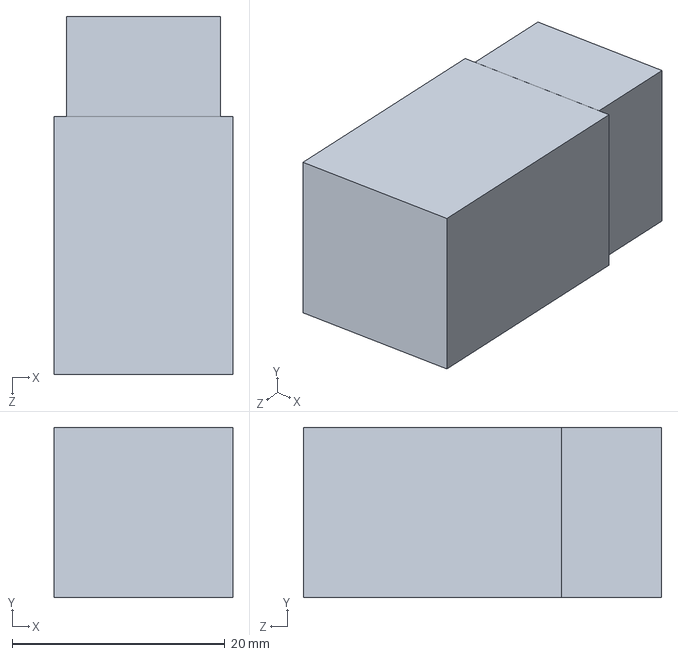
[picture p108: CAD file, 2023-03-17]
Project Files/Housing CAD design files/RJ45.SLDPRT
16.8 x 16.0 x 33.7 mm
