kaichodesu/sotond5/Project Files/Housing CAD design files/Acrylic_lid.SLDPRT

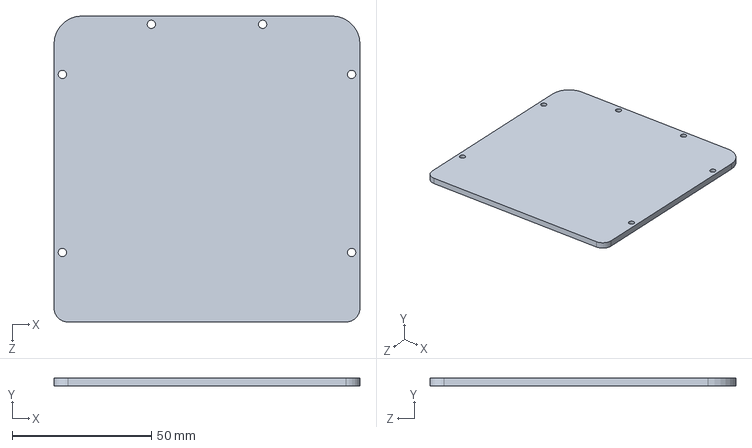
[picture p109: CAD file, 2023-03-17]
Project Files/Housing CAD design files/Acrylic_lid.SLDPRT
110.0 x 3.00 x 110.0 mm
