kaichodesu/sotond5/Project Files/Housing CAD design files/CableGland_1.SLDPRT

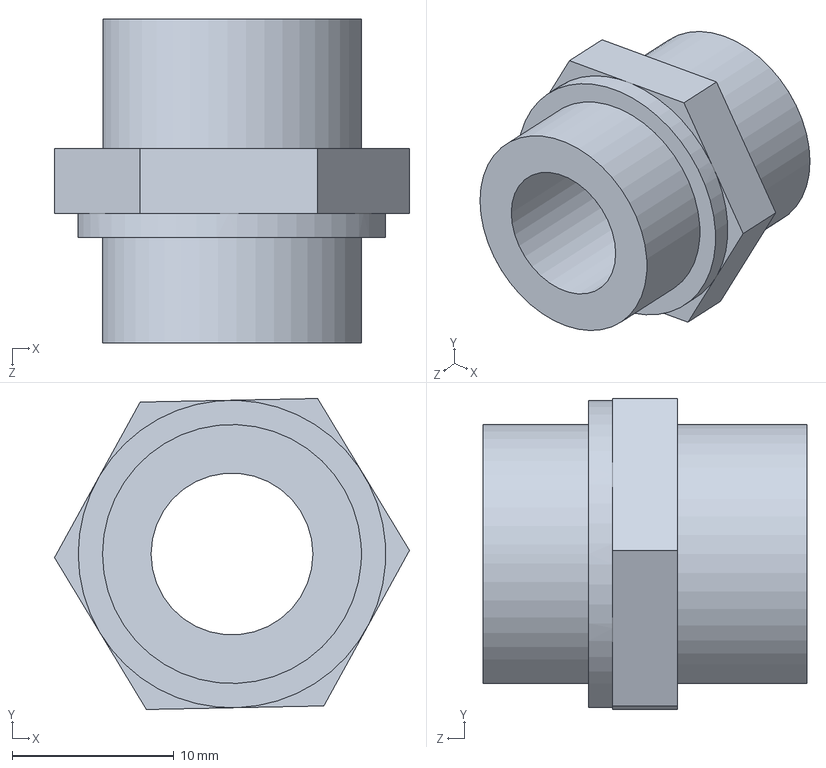
[picture p110: CAD file, 2023-03-17]
Project Files/Housing CAD design files/CableGland_1.SLDPRT
21.9 x 19.2 x 20.0 mm
