kaichodesu/sotond5/Project Files/Housing CAD design files/PSU only.step

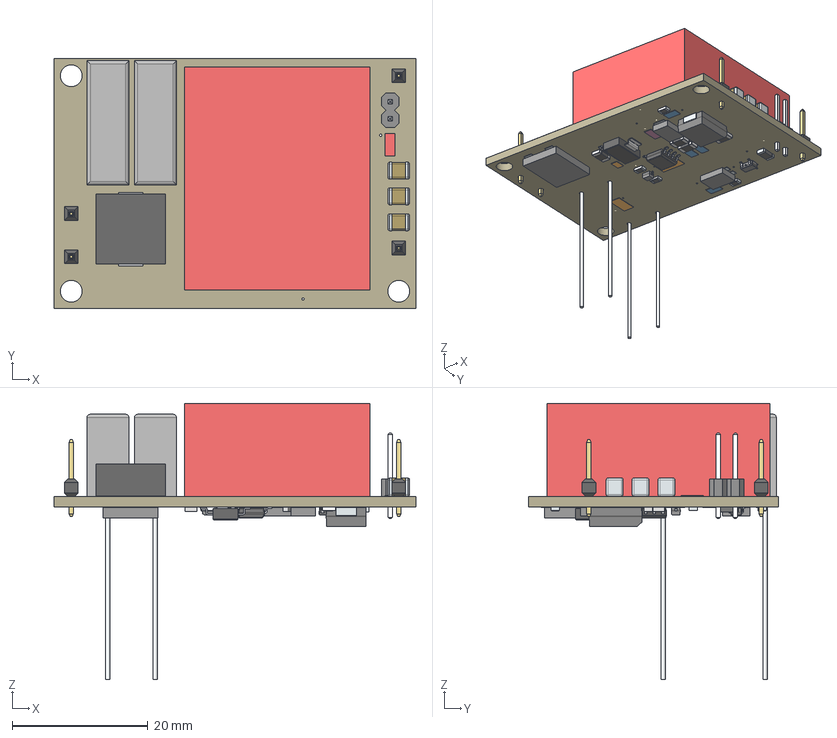
[picture p111: CAD file, 2023-03-17]
Project Files/Housing CAD design files/PSU only.step
53.3 x 36.8 x 40.7 mm
Board
Pins
Pins (1)
FilletPinL
FilletPinR
Pins (2)
BODY-SO
LEAD-D0007A x 7
BODY-SOT
LEAD-SOT x 5
LEAD-DUMMY
1X01
1X01 (1)
1X02
APHD1608LCGCK
IPN70R1K2P7SATMA1
5k
ERA-8ARW7152V
ERA-6AEB2742V
solidBody x 3
Terminal x 3
solidTop x 3
term1
term2
ERA-6AEB2742V_1
solidBody (1)
solidTop (1)
solidTerminal1
solidTerminal2
solidTerminal3
UDZLVTE-17150
CL21A475KLCLQNC x 4
1X01 (2)
1X01 (3)
INDDFN1000X1000X480-2N
FilletPin1
FilletPin2
CRMA1206AF6M00DKEF
TPB1,27 x 6
R523I322050P0K x 2
