kaichodesu/sotond5/(list of files, cad)

Other CAD files:
Project Files/Housing CAD design files/Assem1.SLDASM
Project Files/Housing CAD design files/Rubber Seal.SLDPRT
Project Files/Housing CAD design files/Copy of Part186.SLDPRT
Project Files/Housing CAD design files/Acrylic_lid_latest.SLDPRT
Project Files/Housing CAD design files/Body.SLDPRT
Project Files/Housing CAD design files/Bolt.SLDPRT
Project Files/Housing CAD design files/Nut.SLDPRT
Project Files/PSU Simulations and OrCAD files/Version 3/TEA2209T_1J/Allegro/soic127p600x175-16n.psm
Project Files/Schematics and PCB Layout/EAGLE CAM Design Rules/lbr/1C20C0G220J050B/Allegro/1c20c0g220j050b.psm
Project Files/Schematics and PCB Layout/EAGLE CAM Design Rules/lbr/1C20C0G220J050B/DEHDL/1c20c0g220j050b/chips/chips.prt
Project Files/Schematics and PCB Layout/EAGLE CAM Design Rules/lbr/1SS406,H3F/Allegro/sod2513x115n.psm
Project Files/Schematics and PCB Layout/EAGLE CAM Design Rules/lbr/1SS406,H3F/DEHDL/1ss406_h3f/chips/chips.prt
Project Files/Schematics and PCB Layout/EAGLE CAM Design Rules/lbr/35SVPD8R2M/Allegro/16svf270m.psm
Project Files/Schematics and PCB Layout/EAGLE CAM Design Rules/lbr/35SVPD8R2M/DEHDL/35svpd8r2m/chips/chips.prt
Project Files/Schematics and PCB Layout/EAGLE CAM Design Rules/lbr/3v3/Allegro/sot230p700x180-4n.psm
Project Files/Schematics and PCB Layout/EAGLE CAM Design Rules/lbr/3v3/DEHDL/mcp1799_3302h_db/chips/chips.prt
Project Files/Schematics and PCB Layout/EAGLE CAM Design Rules/lbr/750311771/3D/750311771.stp
Project Files/Schematics and PCB Layout/EAGLE CAM Design Rules/lbr/750311771/Allegro/750311771.psm
Project Files/Schematics and PCB Layout/EAGLE CAM Design Rules/lbr/750311771/DEHDL/750311771/chips/chips.prt
Project Files/Schematics and PCB Layout/EAGLE CAM Design Rules/lbr/890334024005/3D/890334024005.stp
Project Files/Schematics and PCB Layout/EAGLE CAM Design Rules/lbr/890334024005/Allegro/890334024005.psm
Project Files/Schematics and PCB Layout/EAGLE CAM Design Rules/lbr/890334024005/DEHDL/890334024005/chips/chips.prt
Project Files/Schematics and PCB Layout/EAGLE CAM Design Rules/lbr/ACGRAT103L-HF/DEHDL/acgrat103l_hf/chips/chips.prt
Project Files/Schematics and PCB Layout/EAGLE CAM Design Rules/lbr/APHD1608LCGCK/Allegro/ledm168x80n.psm
Project Files/Schematics and PCB Layout/EAGLE CAM Design Rules/lbr/APHD1608LCGCK/DEHDL/aphd1608lcgck/chips/chips.prt
Project Files/Schematics and PCB Layout/EAGLE CAM Design Rules/lbr/ATMEGA644P-20PU/Allegro/dip1556w56p254l5232h483q40n.psm
Project Files/Schematics and PCB Layout/EAGLE CAM Design Rules/lbr/ATMEGA644P-20PU/DEHDL/atmega644p_20pu/chips/chips.prt
Project Files/Schematics and PCB Layout/EAGLE CAM Design Rules/lbr/BAS3007ARPPE6327HTSA1/Allegro/bf998215.psm
Project Files/Schematics and PCB Layout/EAGLE CAM Design Rules/lbr/BAS3007ARPPE6327HTSA1/DEHDL/bas3007arppe6327htsa1/chips/chips.prt
Project Files/Schematics and PCB Layout/EAGLE CAM Design Rules/lbr/BZX84C3V3-7-F/Allegro/sot96p240x120-3n.psm
Project Files/Schematics and PCB Layout/EAGLE CAM Design Rules/lbr/BZX84C3V3-7-F/DEHDL/bzx84c3v3_7_f/chips/chips.prt
Project Files/Schematics and PCB Layout/EAGLE CAM Design Rules/lbr/C315C220J2G5TA/Allegro/c315.psm
Project Files/Schematics and PCB Layout/EAGLE CAM Design Rules/lbr/C315C220J2G5TA/DEHDL/c315c220j2g5ta/chips/chips.prt
Project Files/Schematics and PCB Layout/EAGLE CAM Design Rules/lbr/CD-DF406SL/Allegro/cddf406sl.psm
Project Files/Schematics and PCB Layout/EAGLE CAM Design Rules/lbr/CD-DF406SL/DEHDL/cd_df406sl/chips/chips.prt
Project Files/Schematics and PCB Layout/EAGLE CAM Design Rules/lbr/CD214B-FS2K/Allegro/cd214bfs2k.psm
Project Files/Schematics and PCB Layout/EAGLE CAM Design Rules/lbr/CD214B-FS2K/DEHDL/cd214b_fs2k/chips/chips.prt
Project Files/Schematics and PCB Layout/EAGLE CAM Design Rules/lbr/CDBC5200-HF/DEHDL/cdbc5200_hf/chips/chips.prt
Project Files/Schematics and PCB Layout/EAGLE CAM Design Rules/lbr/CL21A475KLCLQNC/Allegro/capc2012x95n.psm
Project Files/Schematics and PCB Layout/EAGLE CAM Design Rules/lbr/CL21A475KLCLQNC/DEHDL/cl21a475klclqnc/chips/chips.prt
Project Files/Schematics and PCB Layout/EAGLE CAM Design Rules/lbr/CR0603-FX-4701ELF/Allegro/resc1608x55n.psm
Project Files/Schematics and PCB Layout/EAGLE CAM Design Rules/lbr/CR0603-FX-4701ELF/DEHDL/cr0603_fx_4701elf/chips/chips.prt
Project Files/Schematics and PCB Layout/EAGLE CAM Design Rules/lbr/CR1206-FX-6491ELF/Allegro/resc3216x75n.psm
Project Files/Schematics and PCB Layout/EAGLE CAM Design Rules/lbr/CR1206-FX-6491ELF/DEHDL/cr1206_fx_6491elf/chips/chips.prt
Project Files/Schematics and PCB Layout/EAGLE CAM Design Rules/lbr/CRCW0805200MJPEAHR/Allegro/resc2012x50n.psm
Project Files/Schematics and PCB Layout/EAGLE CAM Design Rules/lbr/CRCW0805200MJPEAHR/DEHDL/crcw0805200mjpeahr/chips/chips.prt
Project Files/Schematics and PCB Layout/EAGLE CAM Design Rules/lbr/CRCW12062M74FKEA/Allegro/resc3216x60n.psm
Project Files/Schematics and PCB Layout/EAGLE CAM Design Rules/lbr/CRCW12062M74FKEA/DEHDL/crcw12062m74fkea/chips/chips.prt
Project Files/Schematics and PCB Layout/EAGLE CAM Design Rules/lbr/CRMA1206AF6M00DKEF/Allegro/resc3216x74n.psm
Project Files/Schematics and PCB Layout/EAGLE CAM Design Rules/lbr/CRMA1206AF6M00DKEF/DEHDL/crma1206af6m00dkef/chips/chips.prt
Project Files/Schematics and PCB Layout/EAGLE CAM Design Rules/lbr/EG1218/Allegro/eg1218.psm
Project Files/Schematics and PCB Layout/EAGLE CAM Design Rules/lbr/EG1218/DEHDL/eg1218/chips/chips.prt
Project Files/Schematics and PCB Layout/EAGLE CAM Design Rules/lbr/EMK325ABJ107MM-T/Allegro/capc3225x270n.psm
Project Files/Schematics and PCB Layout/EAGLE CAM Design Rules/lbr/EMK325ABJ107MM-T/DEHDL/emk325abj107mm_t/chips/chips.prt
Project Files/Schematics and PCB Layout/EAGLE CAM Design Rules/lbr/ERA-6AEB2742V/Allegro/era6a__0805_.psm
Project Files/Schematics and PCB Layout/EAGLE CAM Design Rules/lbr/ERA-6AEB2742V/DEHDL/era_6aeb2742v/chips/chips.prt
Project Files/Schematics and PCB Layout/EAGLE CAM Design Rules/lbr/ERA-6VEB1000V/Allegro/era6vk.psm
Project Files/Schematics and PCB Layout/EAGLE CAM Design Rules/lbr/ERA-6VEB1000V/DEHDL/era_6veb1000v/chips/chips.prt
Project Files/Schematics and PCB Layout/EAGLE CAM Design Rules/lbr/ERA-8ARW7152V/Allegro/era8a__0805_.psm
Project Files/Schematics and PCB Layout/EAGLE CAM Design Rules/lbr/ERA-8ARW7152V/DEHDL/era_8arw7152v/chips/chips.prt
Project Files/Schematics and PCB Layout/EAGLE CAM Design Rules/lbr/F861BB104M310A/Allegro/f861bb104m310a.psm
Project Files/Schematics and PCB Layout/EAGLE CAM Design Rules/lbr/F861BB104M310A/DEHDL/f861bb104m310a/chips/chips.prt
Project Files/Schematics and PCB Layout/EAGLE CAM Design Rules/lbr/FQD2P40TM/Allegro/fdd8874.psm
Project Files/Schematics and PCB Layout/EAGLE CAM Design Rules/lbr/FQD2P40TM/DEHDL/fqd2p40tm/chips/chips.prt
Project Files/Schematics and PCB Layout/EAGLE CAM Design Rules/lbr/FSM4JH/Allegro/fsm4jh.psm
Project Files/Schematics and PCB Layout/EAGLE CAM Design Rules/lbr/FSM4JH/DEHDL/fsm4jh/chips/chips.prt
Project Files/Schematics and PCB Layout/EAGLE CAM Design Rules/lbr/LP324D/Allegro/soic127p600x175-14n.psm
Project Files/Schematics and PCB Layout/EAGLE CAM Design Rules/lbr/LP324D/DEHDL/lp324d/chips/chips.prt
Project Files/Schematics and PCB Layout/EAGLE CAM Design Rules/lbr/MBR5U100-TP/Allegro/mbr5u100tp.psm
Project Files/Schematics and PCB Layout/EAGLE CAM Design Rules/lbr/MBR5U100-TP/DEHDL/mbr5u100_tp/chips/chips.prt
Project Files/Schematics and PCB Layout/EAGLE CAM Design Rules/lbr/R463I32204002M/Allegro/r463i32204002m.psm
Project Files/Schematics and PCB Layout/EAGLE CAM Design Rules/lbr/R463I32204002M/DEHDL/r463i32204002m/chips/chips.prt
Project Files/Schematics and PCB Layout/EAGLE CAM Design Rules/lbr/R523I322050P0K/DEHDL/r523i322050p0k/chips/chips.prt
Project Files/Schematics and PCB Layout/EAGLE CAM Design Rules/lbr/SSM3K15AFS,LF/Allegro/sot50p160x90-3n.psm
Project Files/Schematics and PCB Layout/EAGLE CAM Design Rules/lbr/SSM3K15AFS,LF/DEHDL/ssm3k15afs_lf/chips/chips.prt
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
