kaichodesu/sotond5/Project Files/Report/D5/3.3v (main capacity) results.png

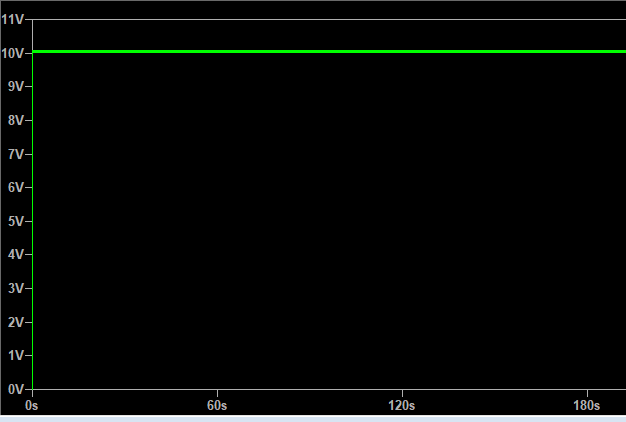
Project Files/Report/D5/3.3v (main capacity) results.png
