kaichodesu/sotond5/Project Files/Report/D5/4AC result.png

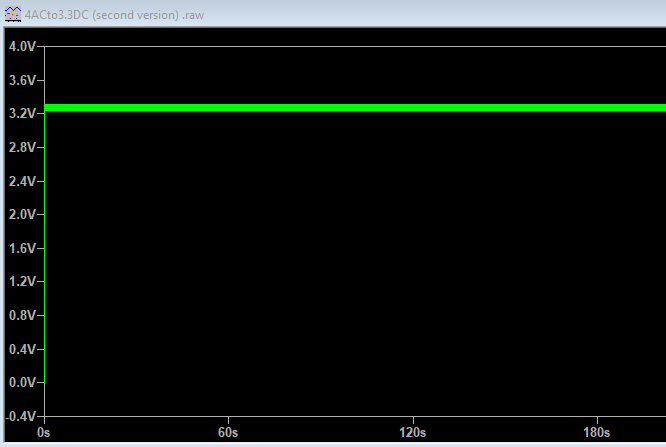
Project Files/Report/D5/4AC result.png
