kaichodesu/sotond5/Project Files/Report/D5/5 digital results.png

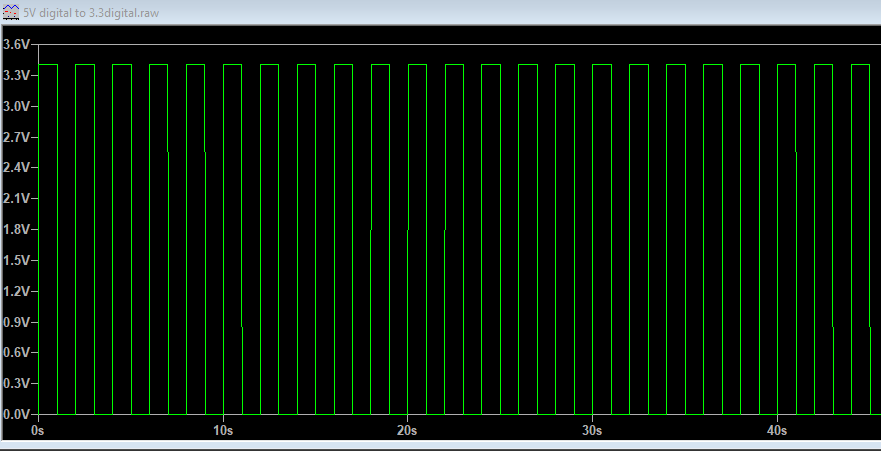
Project Files/Report/D5/5 digital results.png
