kaichodesu/sotond5/Project Files/Report/D5/10AC result.png

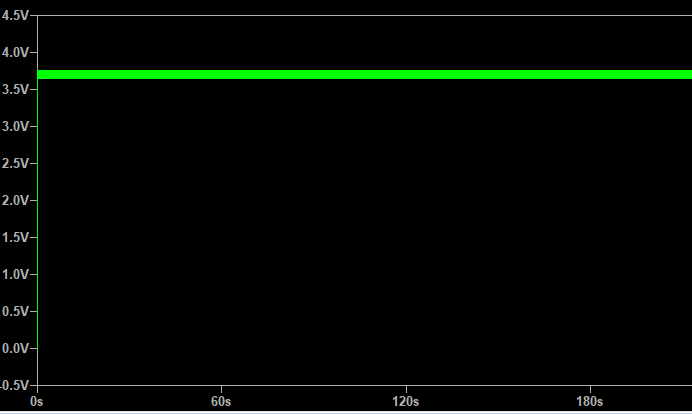
Project Files/Report/D5/10AC result.png
