kaichodesu/sotond5/Project Files/Interface Simulations/Ltspice/4AC to 3.3DC (0 cost version).asc

C1: cap; 47µ
D1: diode; 1N4148
R1: res2; 1.8k
R2: res2; 1.50k
U1: TL07ID
V1: voltage; SINE(0 4 50 0 0 0); AC 1 0
V2: battery; 15
V3: battery; 15
Named nets: 0
.tran 100ms
.include 1N4148.mod
.include TL07ID.sub
