kaichodesu/sotond5/(list of files, drawings)

Other design files:
Project Files/Interface Simulations/Multisim/3.3to10DC.ms14
Project Files/Interface Simulations/Multisim/4AC to 3.6DC (0 Cost).ms14
Project Files/Interface Simulations/Multisim/4ACto3.3DC (version 0).ms14
Project Files/Interface Simulations/Multisim/4ACto3.3DC V1.ms14
Project Files/Interface Simulations/Multisim/5DC to 3.3DC(digital output and part of analg output ).ms14
Project Files/Interface Simulations/Multisim/10ACto3.3DC (second version) .ms14
Project Files/Interface Simulations/Multisim/10ACto3.3DC V1.ms14
Project Files/Interface Simulations/Multisim/.ms14
Project Files/PSU Simulations and OrCAD files/Final/3rd Party SPICE models/STN9360.OLB
Project Files/PSU Simulations and OrCAD files/Final/3rd Party SPICE models/UCC28730_NETLIST.OLB
Project Files/PSU Simulations and OrCAD files/Final/3rd Party SPICE models/ucc28730_netlist.opj
Project Files/PSU Simulations and OrCAD files/Final/3rd Party SPICE models/WE-OLEE.OLB
Project Files/PSU Simulations and OrCAD files/Final/SMPS.DSN
Project Files/PSU Simulations and OrCAD files/Final/SMPS.opj
Project Files/PSU Simulations and OrCAD files/Version 1/D5.DSN
Project Files/PSU Simulations and OrCAD files/Version 1/D5.opj
Project Files/PSU Simulations and OrCAD files/Version 2/3rd Party SPICE models/Capture Library/INFINEON_SIMULATION MODEL_COOLMOS_C7_MOSFET_650V_SPICE.OLB
Project Files/PSU Simulations and OrCAD files/Version 2/3rd Party SPICE models/Capture Library/SIMULATION_MODEL_COOLMOS_P7_MOSFET_700V_SPICE.OLB
Project Files/PSU Simulations and OrCAD files/Version 2/3rd Party SPICE models/Capture Library/ST_FIELD_EFFECT_RECTIFIER_V7.OLB
Project Files/PSU Simulations and OrCAD files/Version 2/3rd Party SPICE models/Capture Library/UCC24650_NETLIST.OLB
Project Files/PSU Simulations and OrCAD files/Version 2/3rd Party SPICE models/Capture Library/ucc24650_netlist.opj
Project Files/PSU Simulations and OrCAD files/Version 2/3rd Party SPICE models/Capture Library/UCC28730_NETLIST.OLB
Project Files/PSU Simulations and OrCAD files/Version 2/D5 SMPS.DSN
Project Files/PSU Simulations and OrCAD files/Version 2/D5 SMPS.opj
Project Files/PSU Simulations and OrCAD files/Version 3/Power Magnetics/sub/WE-FB.OLB
Project Files/PSU Simulations and OrCAD files/Version 3/Power Magnetics/sub/we-fb.opj
Project Files/PSU Simulations and OrCAD files/Version 3/SIC.OLB
Project Files/PSU Simulations and OrCAD files/Version 3/sic.opj
Project Files/PSU Simulations and OrCAD files/Version 3/TEA2209T_1J/Altium/SOIC127P600X175-16N.PcbLib
Project Files/PSU Simulations and OrCAD files/Version 3/TEA2209T_1J/Altium/TEA2209T_1J.SchLib
Project Files/PSU Simulations and OrCAD files/Version 3/UCC28730_bckup/UCC24650DBV_TRANS.OLB
Project Files/PSU Simulations and OrCAD files/Version 3/UCC28730_bckup/UCC28730_DEB.DSN
Project Files/PSU Simulations and OrCAD files/Version 3/UCC28730_bckup/UCC28730_NETLIST.OLB
Project Files/PSU Simulations and OrCAD files/Version 3/UCC28730_bckup/UCC28730_og.opj
Project Files/PSU Simulations and OrCAD files/Version 3/UCC28730_PSPICE_TRANS/SIMULATION_MODEL_COOLMOS_PFD7_MOSFET_600V_SPICE.OLB
Project Files/PSU Simulations and OrCAD files/Version 3/UCC28730_PSPICE_TRANS/UCC24650DBV_TRANS.OLB
Project Files/PSU Simulations and OrCAD files/Version 3/UCC28730_PSPICE_TRANS/UCC28730_DEB.DSN
Project Files/PSU Simulations and OrCAD files/Version 3/UCC28730_PSPICE_TRANS/UCC28730_deb.opj
Project Files/PSU Simulations and OrCAD files/Version 3/UCC28730_PSPICE_TRANS/UCC28730_NETLIST.OLB
Project Files/Schematics and PCB Layout/EAGLE CAM Design Rules/lbr/1C20C0G220J050B/Altium/1C20C0G220J050B.PcbLib
Project Files/Schematics and PCB Layout/EAGLE CAM Design Rules/lbr/1C20C0G220J050B/Altium/1C20C0G220J050B.SchLib
Project Files/Schematics and PCB Layout/EAGLE CAM Design Rules/lbr/3v3/Altium/MCP1799-3302H_DB.SchLib
Project Files/Schematics and PCB Layout/EAGLE CAM Design Rules/lbr/3v3/Altium/SOT230P700X180-4N.PcbLib
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
