kaichodesu/sotond5/Project Files/Schematics and PCB Layout/D5/500uH.brd

## EAGLE design Project Files/Schematics and PCB Layout/D5/500uH.brd (2023-03-17)

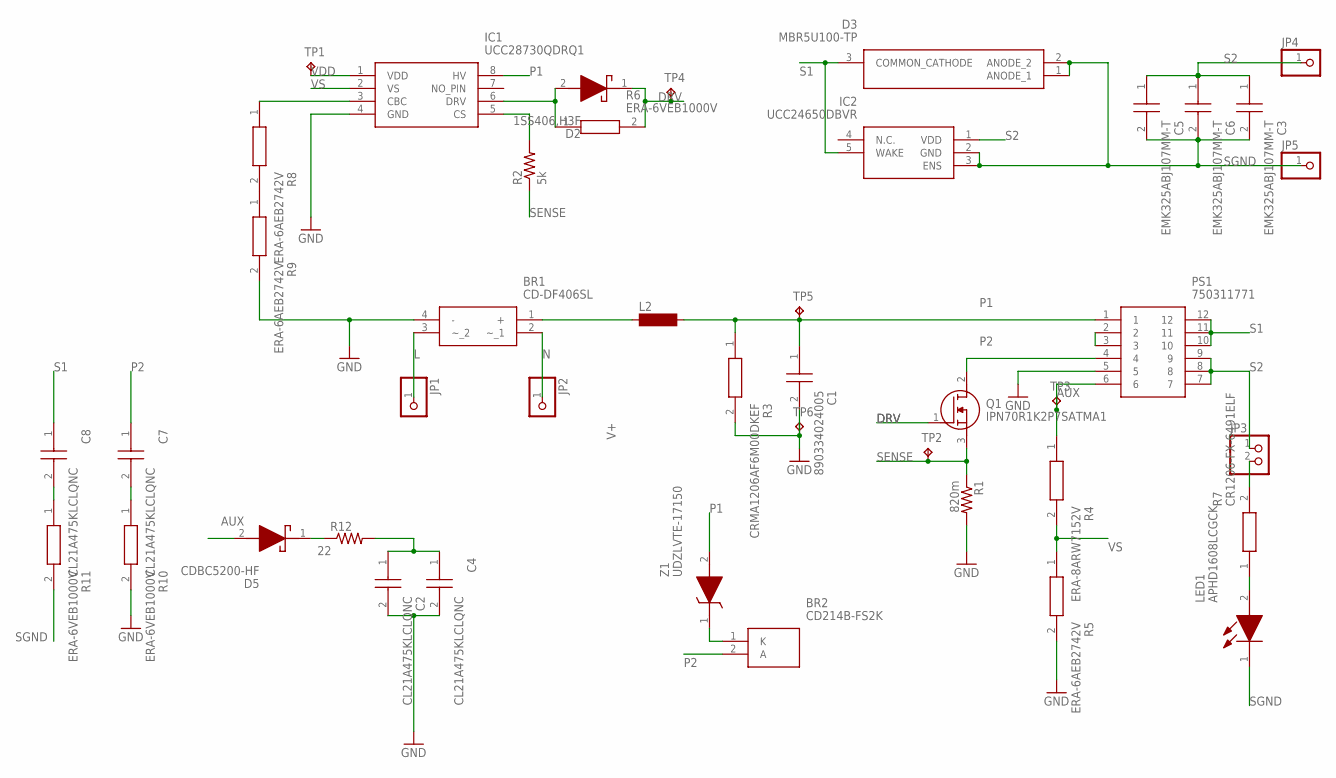
[picture p116: schematic 500uH.sch]

Parts:
BR1: CD-DF406SL; CDDF406SL
BR2: CD214B-FS2K; CD214BFS2K
C1: 890334024005
C2, C4, C7, C8: CL21A475KLCLQNC; CAPC2012X95N
C3, C5, C6: EMK325ABJ107MM-T; CAPC3225X270N
D2: 1SS406,H3F; SOD2513X115N
D3: MBR5U100-TP; MBR5U100TP
D5: CDBC5200-HF; DIOM8059X290N
IC1: UCC28730QDRQ1; SOIC127P600X175-8N
IC2: UCC24650DBVR; SOT95P280X145-5N
JP1, JP2, JP4, JP5: PINHD-1X1; 1X01
JP3: PINHD-1X2; 1X02
L2: MS50SRU1048-471Y; INDDFN1000X1000X480-2N
LED1: APHD1608LCGCK; LEDM168X80N
PS1: 750311771
Q1: IPN70R1K2P7SATMA1
R1: 820m; R0805
R2: 5k; R0805
R3: CRMA1206AF6M00DKEF; RESC3216X74N
R4: ERA-8ARW7152V; ERA8A_(0805)
R5, R8, R9: ERA-6AEB2742V; ERA6A_(0805)
R6, R10, R11: ERA-6VEB1000V; ERA6VK
R7: CR1206-FX-6491ELF; RESC3216X75N
R12: 22; R0805
TP1, TP2, TP3, TP4, TP5, TP6: TPB1,27; B1,27
Z1: UDZLVTE-17150; SODFL2512X90N

Connections:
AUX: D5.2 (A), PS1.6, R4.1, TP3.TP
DRV: D2.1 (K), Q1.1 (G), R6.2, TP4.TP
GND: BR1.4 (-), C1.2, C2.2, C4.2, IC1.4 (GND), PS1.5, R1.2, R3.2, R5.2, R9.2, R10.2, TP6.TP
L: BR1.3 (~_2), JP1.1
N: BR1.2 (~_1), JP2.1
unnamed: IC1.5 (CS), R2.2
unnamed: C7.2, R10.1
unnamed: C8.2, R11.1
unnamed: D5.1 (K), R12.1
unnamed: PS1.2, PS1.3
unnamed: BR2.1 (K), Z1.1 (K)
unnamed: D2.2 (A), IC1.6 (DRV), R6.1
unnamed: R8.2, R9.1
unnamed: LED1.2 (A), R7.1
unnamed: IC1.3 (CBC), R8.1
unnamed: JP3.2, R7.2
P1: C1.1, IC1.8 (HV), L2.2, PS1.1, R3.1, TP5.TP, Z1.2 (A)
P2: BR2.2 (A), C7.1, PS1.4, Q1.2 (D)
S1: C8.1, D3.3 (COMMON_CATHODE), IC2.5 (WAKE), PS1.10, PS1.11, PS1.12
S2: C3.1, C5.1, C6.1, IC2.1 (VDD), JP3.1, JP4.1, PS1.7, PS1.8, PS1.9
SENSE: Q1.3 (S), R1.1, R2.1, TP2.TP
SGND: C3.2, C5.2, C6.2, D3.1 (ANODE_1), D3.2 (ANODE_2), IC2.2 (GND), IC2.3 (ENS), JP5.1, LED1.1 (K), R11.2
V+: BR1.1 (+), L2.1
VDD: C2.1, C4.1, IC1.1 (VDD), R12.2, TP1.TP
VS: IC1.2 (VS), R4.2, R5.1

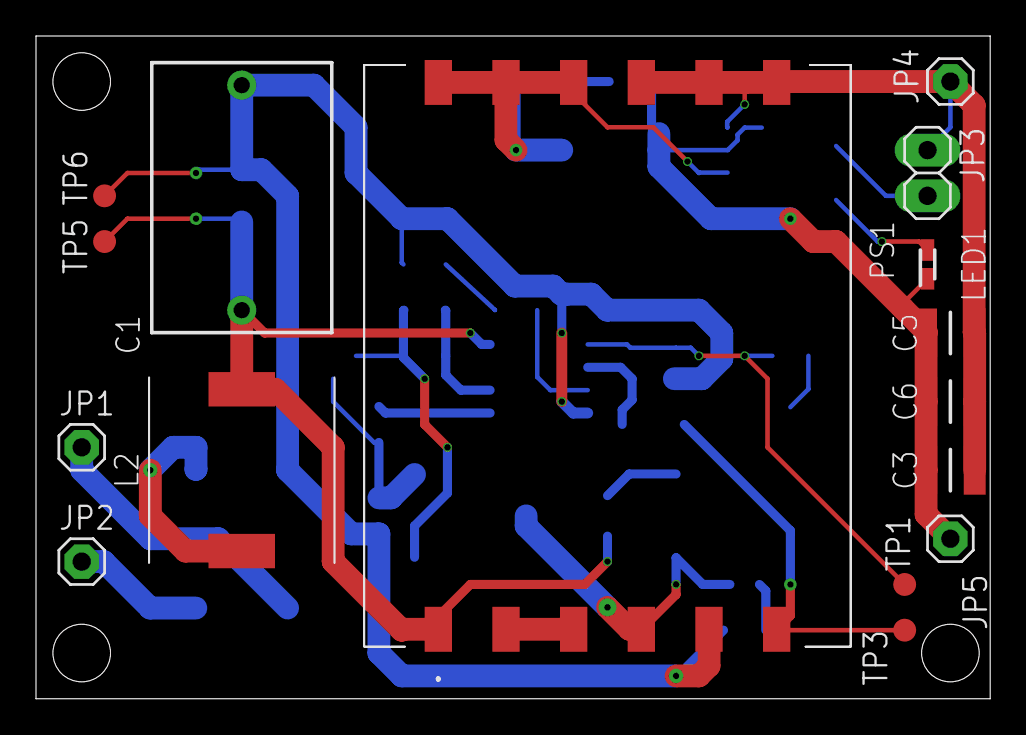
[picture p117: board 500uH.brd from above]

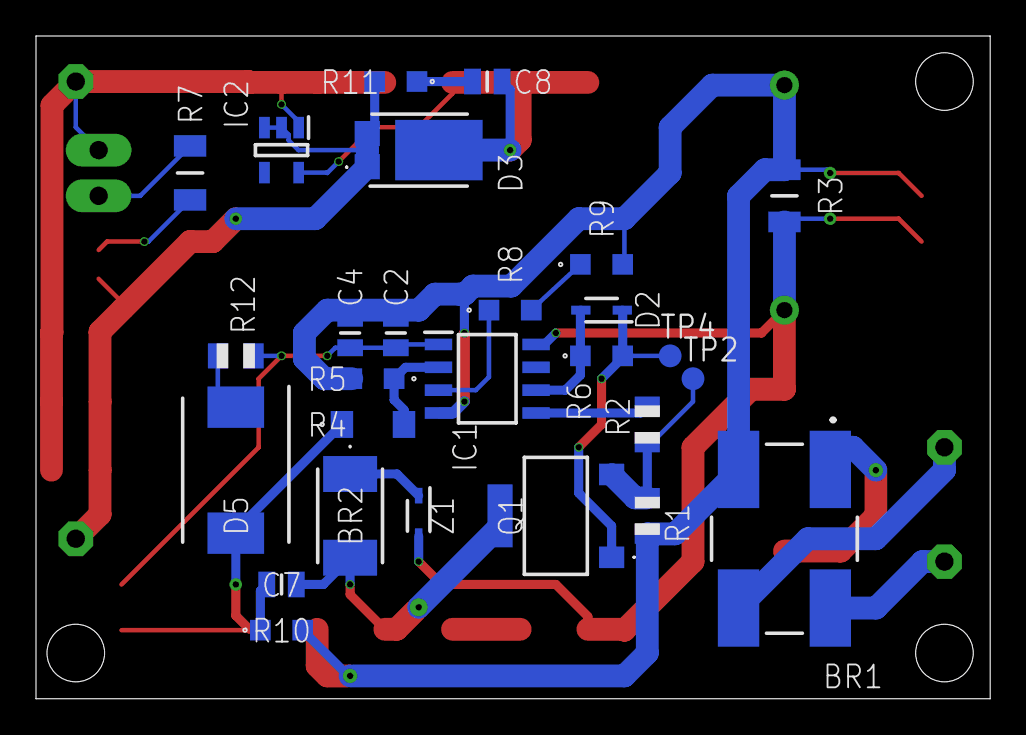
[picture p118: board 500uH.brd from below]

Board: 2 copper layers, 53.0 x 36.8 mm, 43 parts (27 on the bottom side), 25 nets.
