kaichodesu/sotond5/Project Files/Schematics and PCB Layout/D5/220nF.brd

## EAGLE design Project Files/Schematics and PCB Layout/D5/220nF.brd (2023-03-17)

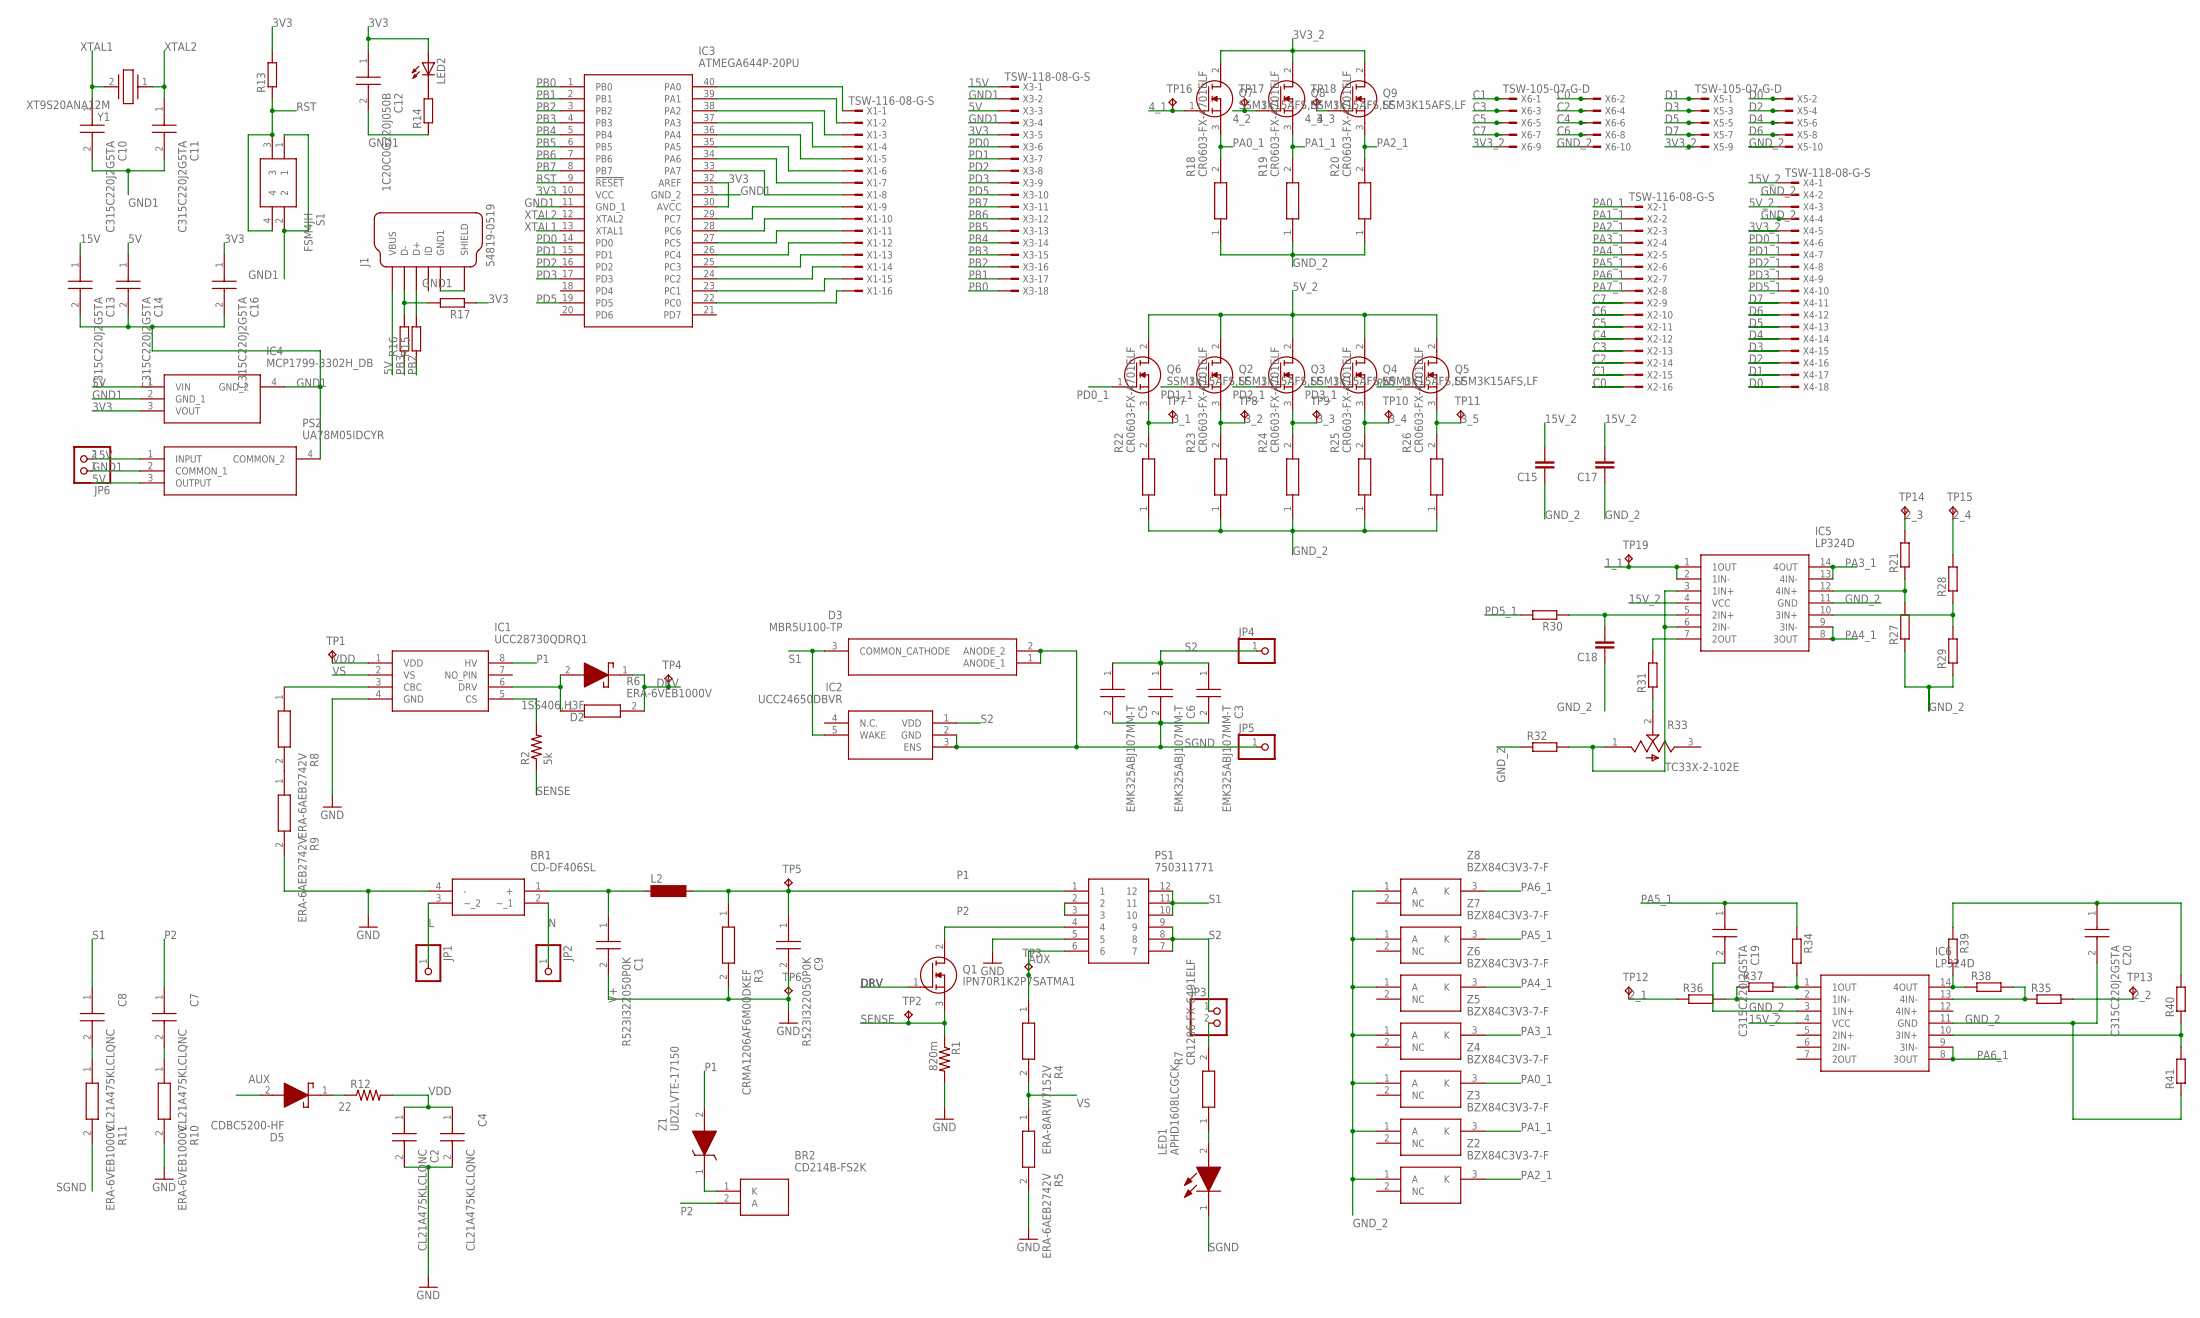
[picture p119: schematic 220nF.sch, sheet 1]

Parts:
BR1: CD-DF406SL; CDDF406SL
BR2: CD214B-FS2K; CD214BFS2K
C1, C9: R523I322050P0K; HDRV2W65P0X1500_1X2_1790X585X1
C2, C4, C7, C8: CL21A475KLCLQNC; CAPC2012X95N
C3, C5, C6: EMK325ABJ107MM-T; CAPC3225X270N
C10, C11, C13, C14, C16, C19, C20: C315C220J2G5TA; C315
C12: 1C20C0G220J050B
C15, C17, C18: C-EUC0805; C0805
D2: 1SS406,H3F; SOD2513X115N
D3: MBR5U100-TP; MBR5U100TP
D5: CDBC5200-HF; DIOM8059X290N
IC1: UCC28730QDRQ1; SOIC127P600X175-8N
IC2: UCC24650DBVR; SOT95P280X145-5N
IC3: ATMEGA644P-20PU; DIP1556W56P254L5232H483Q40N
IC4: MCP1799-3302H_DB; SOT230P700X180-4N
IC5, IC6: LP324D; SOIC127P600X175-14N
J1: 54819-0519; MOLEX_54819-0519
JP1, JP2, JP4, JP5: PINHD-1X1; 1X01
JP3, JP6: PINHD-1X2; 1X02
L2: MS50SRU1048-471Y; INDDFN1000X1000X480-2N
LED1: APHD1608LCGCK; LEDM168X80N
LED2: LED3MM
PS1: 750311771
PS2: UA78M05IDCYR; SOT230P700X180-4N
Q1: IPN70R1K2P7SATMA1
Q2, Q3, Q4, Q5, Q6, Q7, Q8, Q9: SSM3K15AFS,LF; SOT50P160X90-3N
R1: 820m; R0805
R2: 5k; R0805
R3: CRMA1206AF6M00DKEF; RESC3216X74N
R4: ERA-8ARW7152V; ERA8A_(0805)
R5, R8, R9: ERA-6AEB2742V; ERA6A_(0805)
R6, R10, R11: ERA-6VEB1000V; ERA6VK
R7: CR1206-FX-6491ELF; RESC3216X75N
R12: 22; R0805
R13, R14, R15, R16, R17, R34, R39: R-EU_0204/7; 0204/7
R18, R19, R20, R22, R23, R24, R25, R26: CR0603-FX-4701ELF; RESC1608X55N
R21, R27, R28, R29, R30, R31, R32, R35, R36, R37, R38, R40, R41: R-EU_R0805; R0805
R33: TC33X-2-102E; TRIM_TC33X-2-102E
S1: FSM4JH
TP1, TP2, TP3, TP4, TP5, TP6, TP7, TP8, TP9, TP10, TP11, TP12, TP13, TP14, TP15, TP16, TP17, TP18, TP19: TPB1,27; B1,27
X1, X2: TSW-116-08-G-S; TSW-116-XX-G-S
X3, X4: TSW-118-08-G-S; TSW-118-XX-G-S
X5, X6: TSW-105-07-G-D; TSW-105-XX-G-D
Y1: XT9S20ANA12M
Z1: UDZLVTE-17150; SODFL2512X90N
Z2, Z3, Z4, Z5, Z6, Z7, Z8: BZX84C3V3-7-F; SOT96P240X120-3N

Connections:
1_1: IC5.1 (1OUT), IC5.2 (1IN-), TP19.TP
2_1: R36.1, TP12.TP
2_2: R35.2, TP13.TP
2_3: R21.2, TP14.TP
2_4: R28.2, TP15.TP
3V3: C12.1, C16.1, IC3.10 (VCC), IC3.30 (AVCC), IC3.32 (AREF), IC4.3 (VOUT), LED2.A, R13.2, R17.1, X3.5
3V3_2: Q7.2 (D), Q8.2 (D), Q9.2 (D), X4.5, X5.9, X6.9
3_1: Q6.3 (S), R22.2, TP7.TP
3_2: Q2.3 (S), R23.2, TP8.TP
3_3: Q3.3 (S), R24.2, TP9.TP
3_4: Q4.3 (S), R25.2, TP10.TP
3_5: Q5.3 (S), R26.2, TP11.TP
4_1: Q7.1 (G), TP16.TP
4_2: Q8.1 (G), TP17.TP
4_3: Q9.1 (G), TP18.TP
5V: C14.1, IC4.1 (VIN), J1.1 (VBUS), J1.6 (VBUS), PS2.3 (OUTPUT), X3.3
5V_2: Q2.2 (D), Q3.2 (D), Q4.2 (D), Q5.2 (D), Q6.2 (D), X4.3
15V: C13.1, JP6.2, PS2.1 (INPUT), X3.1
15V_2: C15.2, C17.2, IC5.4 (VCC), IC6.4 (VCC), X4.1
AUX: D5.2 (A), PS1.6, R4.1, TP3.TP
C0: X2.16, X6.2
C1: X2.15, X6.1
C2: X2.14, X6.4
C3: X2.13, X6.3
C4: X2.12, X6.6
C5: X2.11, X6.5
C6: X2.10, X6.8
C7: X2.9, X6.7
D0: X4.18, X5.2
D1: X4.17, X5.1
D2: X4.16, X5.4
D3: X4.15, X5.3
D4: X4.14, X5.6
D5: X4.13, X5.5
D6: X4.12, X5.8
D7: X4.11, X5.7
DRV: D2.1 (K), Q1.1 (G), R6.2, TP4.TP
GND: BR1.4 (-), C1.2, C2.2, C4.2, C9.2, IC1.4 (GND), PS1.5, R1.2, R3.2, R5.2, R9.2, R10.2, TP6.TP
GND1: C10.2, C11.2, C12.2, C13.2, C14.2, C16.2, IC3.11 (GND_1), IC3.31 (GND_2), IC4.2 (GND_1), IC4.4 (GND_2), J1.5 (GND1), J1.10 (GND1), J1.11 (SHIELD), J1.12 (SHIELD), J1.S1 (SHIELD), J1.S2 (SHIELD), JP6.1, PS2.2 (COMMON_1), PS2.4 (COMMON_2), R14.1, S1.1, S1.2, X3.2, X3.4
GND_2: C15.1, C17.1, C18.1, C19.2, C20.2, IC5.11 (GND), IC6.3 (1IN+), IC6.11 (GND), R18.1, R19.1, R20.1, R22.1, R23.1, R24.1, R25.1, R26.1, R27.1, R29.1, R32.1, R41.1, X4.2, X4.4, X5.10, X6.10, Z2.1 (A), Z3.1 (A), Z4.1 (A), Z5.1 (A), Z6.1 (A), Z7.1 (A), Z8.1 (A)
L: BR1.3 (~_2), JP1.1
N: BR1.2 (~_1), JP2.1
unnamed: IC1.5 (CS), R2.2
unnamed: C7.2, R10.1
unnamed: C8.2, R11.1
unnamed: D5.1 (K), R12.1
unnamed: PS1.2, PS1.3
unnamed: BR2.1 (K), Z1.1 (K)
unnamed: D2.2 (A), IC1.6 (DRV), R6.1
unnamed: R8.2, R9.1
unnamed: LED1.2 (A), R7.1
unnamed: IC1.3 (CBC), R8.1
unnamed: JP3.2, R7.2
unnamed: IC3.40 (PA0), X1.1
unnamed: IC3.39 (PA1), X1.2
unnamed: IC3.38 (PA2), X1.3
unnamed: IC3.37 (PA3), X1.4
unnamed: IC3.36 (PA4), X1.5
unnamed: IC3.35 (PA5), X1.6
unnamed: IC3.34 (PA6), X1.7
unnamed: IC3.33 (PA7), X1.8
unnamed: IC3.22 (PC0), X1.16
unnamed: IC3.23 (PC1), X1.15
unnamed: IC3.24 (PC2), X1.14
unnamed: IC3.25 (PC3), X1.13
unnamed: IC3.26 (PC4), X1.12
unnamed: IC3.27 (PC5), X1.11
unnamed: IC3.28 (PC6), X1.10
unnamed: IC3.29 (PC7), X1.9
unnamed: LED2.K (C), R14.2
unnamed: J1.3 (D+), J1.8 (D+), R15.2
unnamed: J1.2 (D-), J1.7 (D-), R16.2, R17.2
unnamed: C18.2, IC5.5 (2IN+), R30.1
unnamed: IC5.7 (2OUT), R31.2
unnamed: IC5.12 (4IN+), R21.1, R27.2
unnamed: IC5.10 (3IN+), R28.1, R29.2
unnamed: IC5.3 (1IN+), IC5.6 (2IN-), R32.2, R33.1 (CCW)
unnamed: R31.1, R33.2 (W)
unnamed: IC6.14 (4OUT), R38.1, R39.2
unnamed: IC6.13 (4IN-), R35.1, R38.2
unnamed: IC6.2 (1IN-), R36.2, R37.1
unnamed: IC6.1 (1OUT), R34.2, R37.2
unnamed: C20.1, R39.1, R40.2
unnamed: IC6.10 (3IN+), R40.1, R41.2
P1: C9.1, IC1.8 (HV), L2.2, PS1.1, R3.1, TP5.TP, Z1.2 (A)
P2: BR2.2 (A), C7.1, PS1.4, Q1.2 (D)
PA0_1: Q7.3 (S), R18.2, X2.1, Z4.3 (K)
PA1_1: Q8.3 (S), R19.2, X2.2, Z3.3 (K)
PA2_1: Q9.3 (S), R20.2, X2.3, Z2.3 (K)
PA3_1: IC5.13 (4IN-), IC5.14 (4OUT), X2.4, Z5.3 (K)
PA4_1: IC5.8 (3OUT), IC5.9 (3IN-), X2.5, Z6.3 (K)
PA5_1: C19.1, R34.1, X2.6, Z7.3 (K)
PA6_1: IC6.8 (3OUT), IC6.9 (3IN-), X2.7, Z8.3 (K)
PA7_1: Q5.1 (G), X2.8
PB0: IC3.1 (PB0), X3.18
PB1: IC3.2 (PB1), X3.17
PB2: IC3.3 (PB2), R15.1, X3.16
PB3: IC3.4 (PB3), R16.1, X3.15
PB4: IC3.5 (PB4), X3.14
PB5: IC3.6 (PB5), X3.13
PB6: IC3.7 (PB6), X3.12
PB7: IC3.8 (PB7), X3.11
PD0: IC3.14 (PD0), X3.6
PD0_1: Q6.1 (G), X4.6
PD1: IC3.15 (PD1), X3.7
PD1_1: Q2.1 (G), X4.7
PD2: IC3.16 (PD2), X3.8
PD2_1: Q3.1 (G), X4.8
PD3: IC3.17 (PD3), X3.9
PD3_1: Q4.1 (G), X4.9
PD5: IC3.19 (PD5), X3.10
PD5_1: R30.2, X4.10
RST: IC3.9 (!RESET), R13.1, S1.3, S1.4
S1: C8.1, D3.3 (COMMON_CATHODE), IC2.5 (WAKE), PS1.10, PS1.11, PS1.12
S2: C3.1, C5.1, C6.1, IC2.1 (VDD), JP3.1, JP4.1, PS1.7, PS1.8, PS1.9
SENSE: Q1.3 (S), R1.1, R2.1, TP2.TP
SGND: C3.2, C5.2, C6.2, D3.1 (ANODE_1), D3.2 (ANODE_2), IC2.2 (GND), IC2.3 (ENS), JP5.1, LED1.1 (K), R11.2
V+: BR1.1 (+), C1.1, L2.1
VDD: C2.1, C4.1, IC1.1 (VDD), R12.2, TP1.TP
VS: IC1.2 (VS), R4.2, R5.1
XTAL1: C10.1, IC3.13 (XTAL1), Y1.2
XTAL2: C11.1, IC3.12 (XTAL2), Y1.1

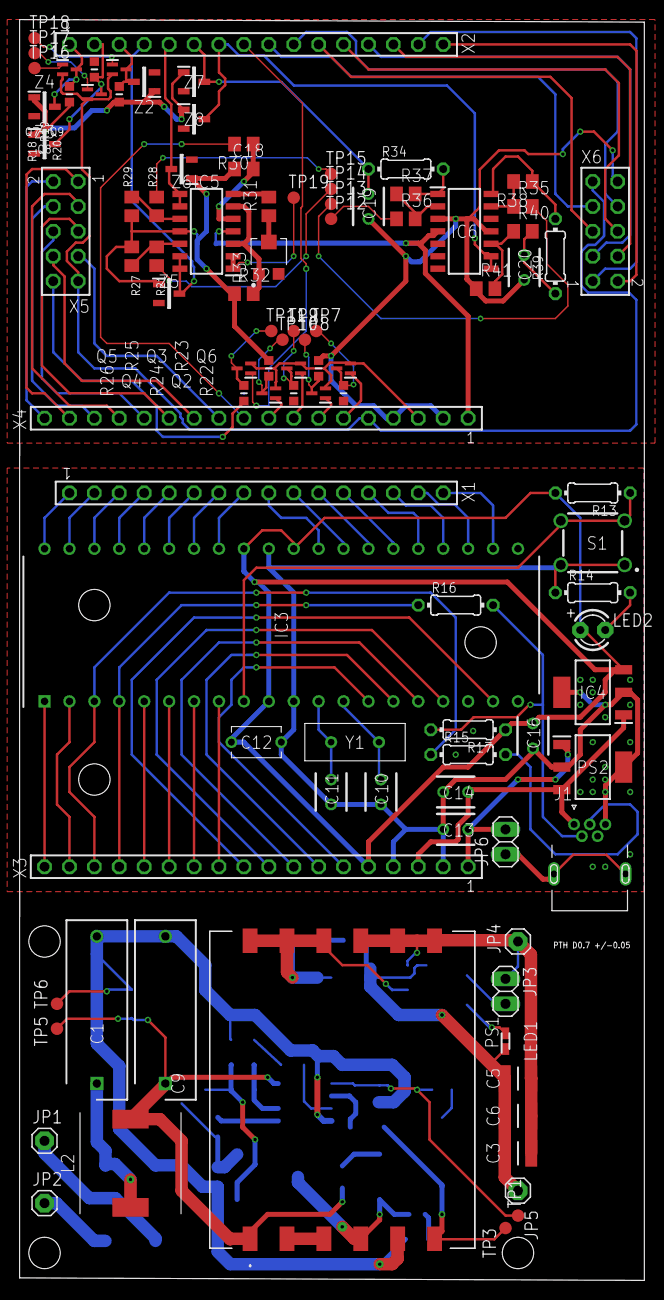
[picture p120: board 220nF.brd from above]

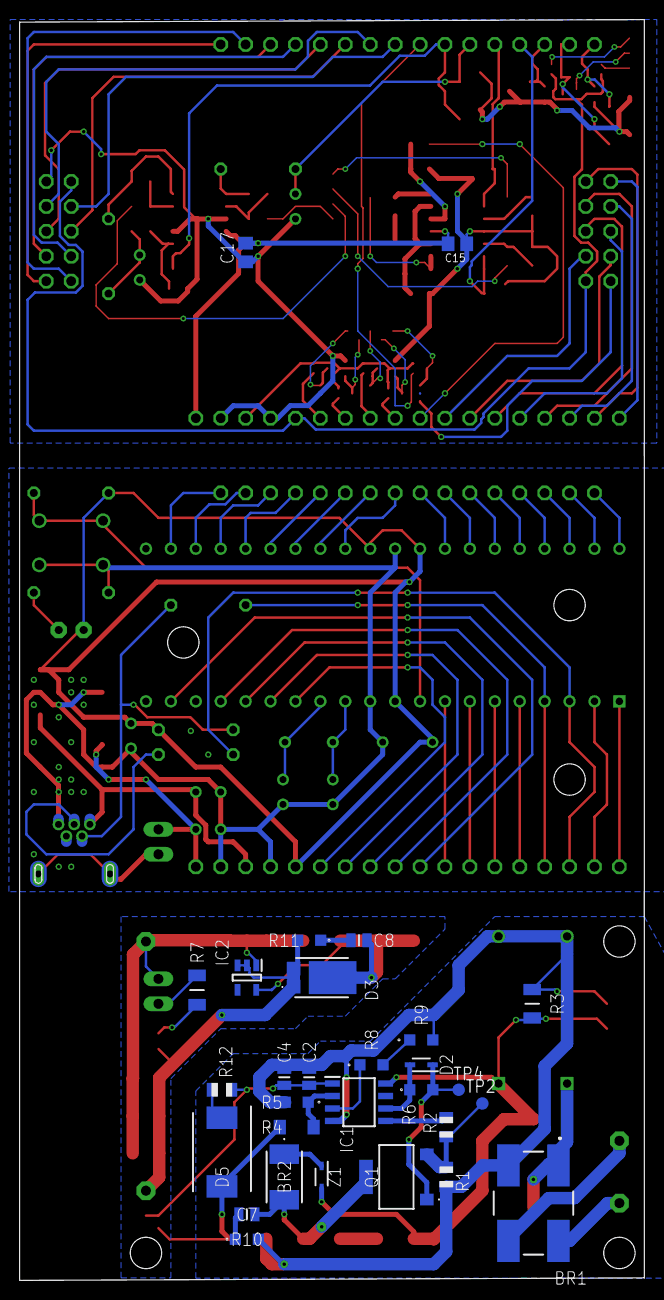
[picture p121: board 220nF.brd from below]

Board: 2 copper layers, 63.7 x 128.5 mm, 128 parts (29 on the bottom side), 122 nets.
