kaichodesu/sotond5/Project Files/Interface Simulations/Schematic/3.3to10DC.sch

## EAGLE design Project Files/Interface Simulations/Schematic/3.3to10DC.sch (2023-03-17)

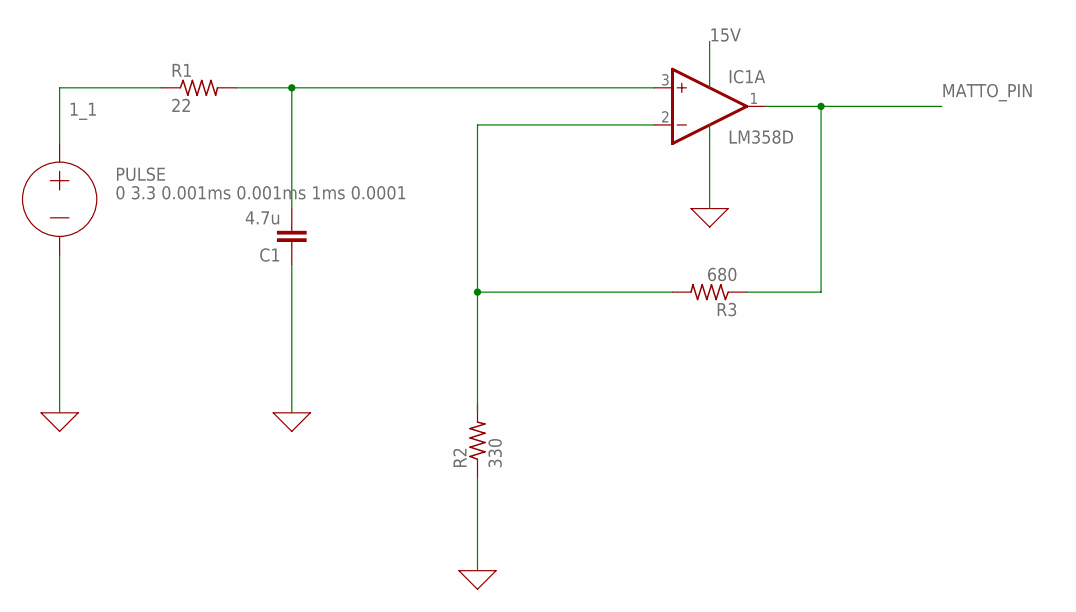
[picture p122: schematic 3.3to10DC.sch]

Parts:
C1: 4.7u; C2.5-2
IC1: LM358D; SO08
R1: 22; 0204/7
R2: 330; 0204/7
R3: 680; 0204/7

Connections:
0: C1.1, R2.1
1_1: R1.1
MATTO_PIN: IC1.1 (OUT), R3.1
unnamed: C1.2, IC1.3 (+IN), R1.2
unnamed: IC1.2 (-IN), R2.2, R3.2
