kaichodesu/sotond5/Project Files/Interface Simulations/Schematic/4AC to 3.6DC (0 Cost).sch

## EAGLE design Project Files/Interface Simulations/Schematic/4AC to 3.6DC (0 Cost).sch (2023-03-17)

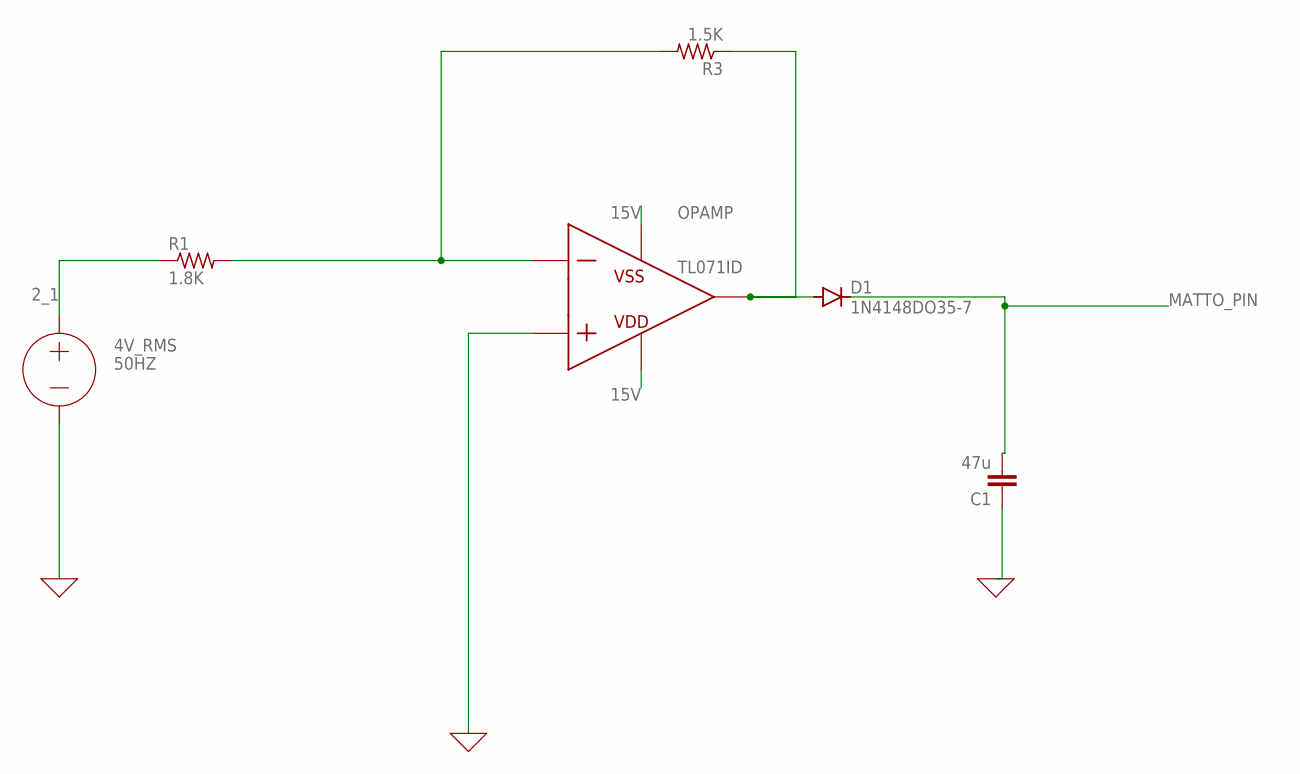
[picture p123: schematic 4AC to 3.6DC (0 Cost).sch]

Parts:
C1: 47u; C2.5-2
D1: 1N4148DO35-7; DO35-7
R1: 1.8K; 0204/7
R3: 1.5K; 0204/7

Connections:
0: C1.1
2_1: R1.1
MATTO_PIN: C1.2, D1.C
unnamed: R1.2, R3.2
unnamed: D1.A, R3.1
