kaichodesu/sotond5/Project Files/Interface Simulations/Schematic/4AC to 3.6DC V1.sch

## EAGLE design Project Files/Interface Simulations/Schematic/4AC to 3.6DC V1.sch (2023-03-17)

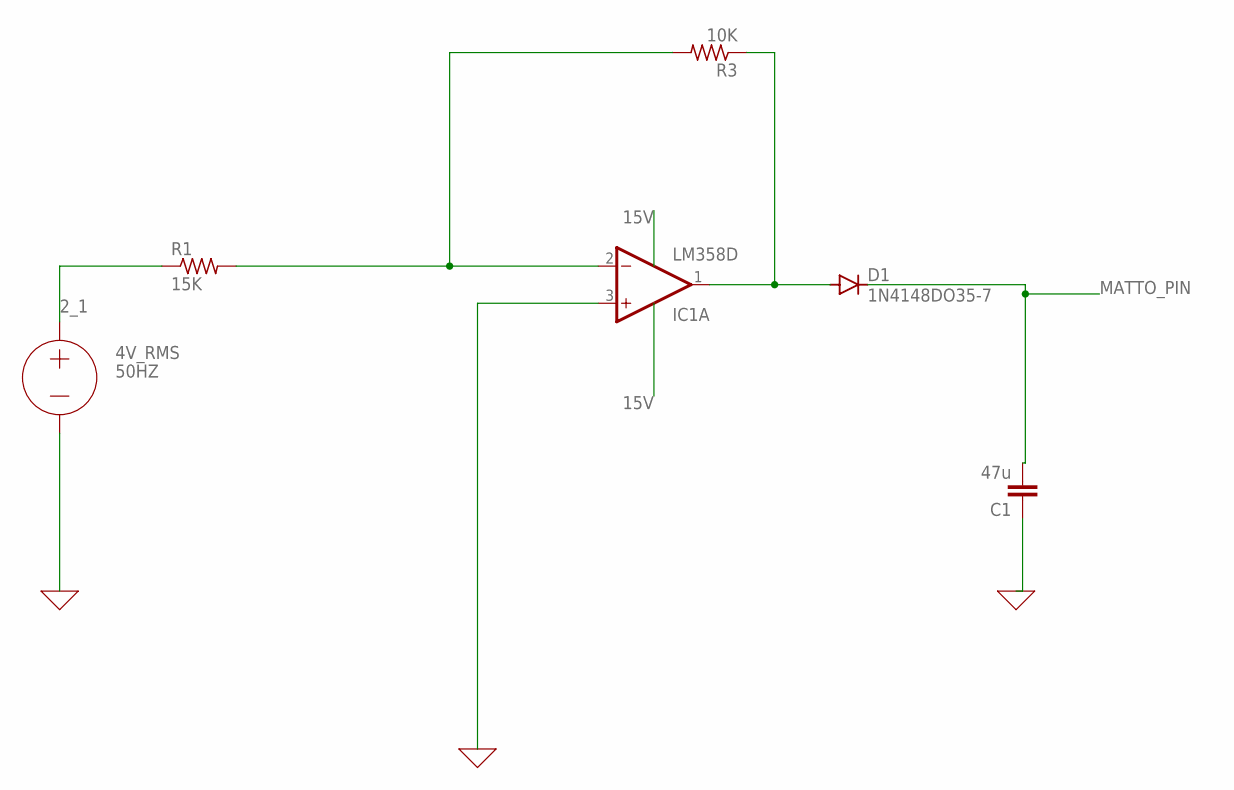
[picture p124: schematic 4AC to 3.6DC V1.sch]

Parts:
C1: 47u; C2.5-2
D1: 1N4148DO35-7; DO35-7
IC1: LM358D; SO08
R1: 15K; 0204/7
R3: 10K; 0204/7

Connections:
0: C1.1, IC1.3 (+IN)
2_1: R1.1
MATTO_PIN: C1.2, D1.C
unnamed: IC1.2 (-IN), R1.2, R3.2
unnamed: D1.A, IC1.1 (OUT), R3.1
