kaichodesu/sotond5/Project Files/Interface Simulations/Schematic/4ACto3.3DC (version 0).sch

## EAGLE design Project Files/Interface Simulations/Schematic/4ACto3.3DC (version 0).sch (2023-03-17)

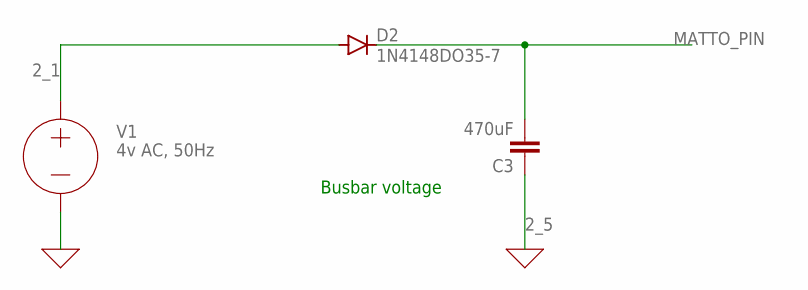
[picture p125: schematic 4ACto3.3DC (version 0).sch]

Parts:
C3: 470uF; C2.5-3
D2: 1N4148DO35-7; DO35-7

Connections:
2_1: D2.A
2_5: C3.1
MATTO_PIN: C3.2, D2.C

Notes on the sheet:
Busbar voltage
