kaichodesu/sotond5/Project Files/Interface Simulations/Schematic/5DC to 3.3DC(digital output and part of analg output ).sch

## EAGLE design Project Files/Interface Simulations/Schematic/5DC to 3.3DC(digital output and part of analg output ).sch (2023-03-17)

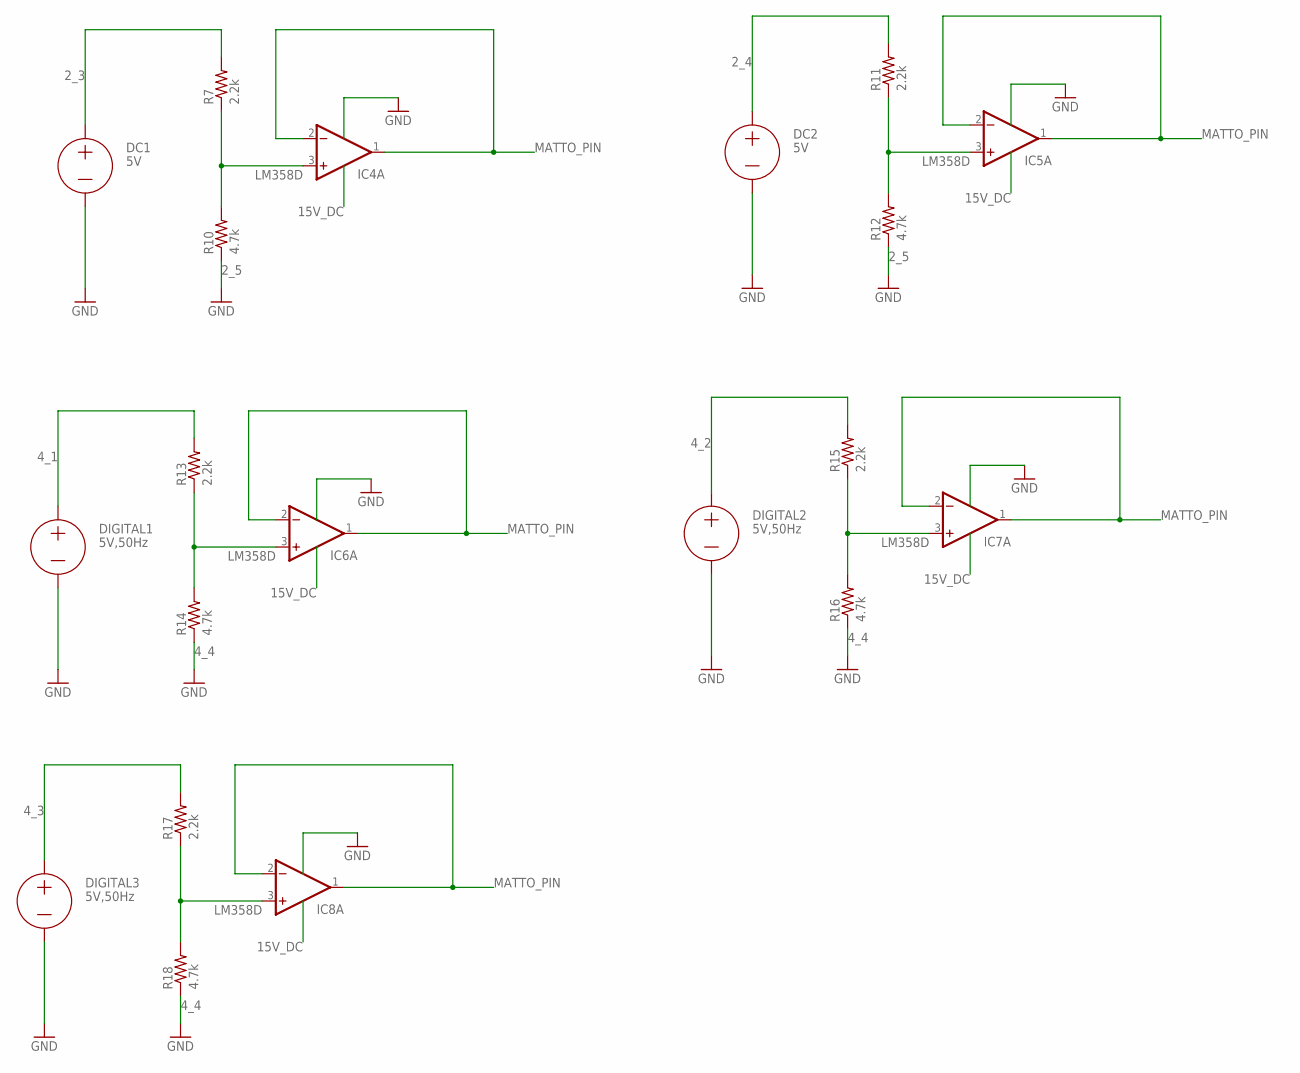
[picture p126: schematic 5DC to 3.3DC(digital output and part of analg output ).sch]

Parts:
IC4, IC5, IC6, IC7, IC8: LM358D; SO08
R7, R11, R13, R15, R17: 2.2k; 0204/7
R10, R12, R14, R16, R18: 4.7k; 0204/7

Connections:
2_3: R7.2
2_4: R11.2
2_5: R10.1, R12.1
4_1: R13.2
4_2: R15.2
4_3: R17.2
4_4: R14.1, R16.1, R18.1
MATTO_PIN: IC4.1 (OUT), IC4.2 (-IN), IC5.1 (OUT), IC5.2 (-IN), IC6.1 (OUT), IC6.2 (-IN), IC7.1 (OUT), IC7.2 (-IN), IC8.1 (OUT), IC8.2 (-IN)
unnamed: IC4.3 (+IN), R7.1, R10.2
unnamed: IC5.3 (+IN), R11.1, R12.2
unnamed: IC6.3 (+IN), R13.1, R14.2
unnamed: IC7.3 (+IN), R15.1, R16.2
unnamed: IC8.3 (+IN), R17.1, R18.2
