kaichodesu/sotond5/Project Files/Interface Simulations/Schematic/10ACto3.3DC (second version) .sch

## EAGLE design Project Files/Interface Simulations/Schematic/10ACto3.3DC (second version) .sch (2023-03-17)

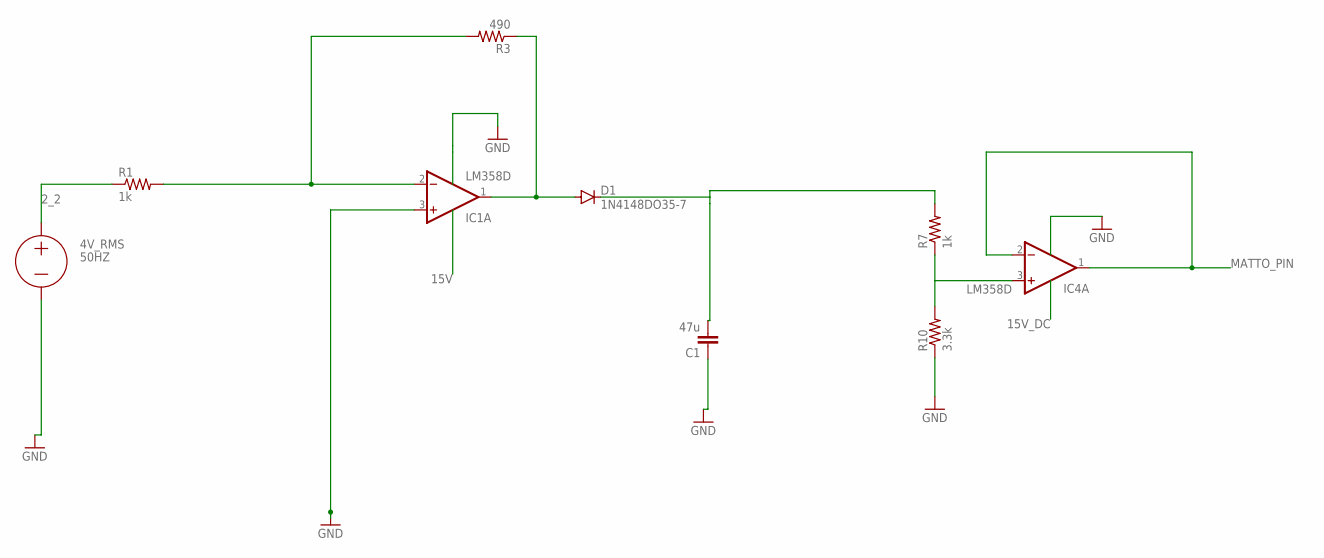
[picture p127: schematic 10ACto3.3DC (second version) .sch]

Parts:
C1: 47u; C2.5-2
D1: 1N4148DO35-7; DO35-7
IC1, IC4: LM358D; SO08
R1, R7: 1k; 0204/7
R3: 490; 0204/7
R10: 3.3k; 0204/7

Connections:
2_2: R1.1
GND: C1.1, IC1.3 (+IN), R10.1
MATTO_PIN: IC4.1 (OUT), IC4.2 (-IN)
unnamed: IC1.2 (-IN), R1.2, R3.2
unnamed: C1.2, D1.C, R7.2
unnamed: D1.A, IC1.1 (OUT), R3.1
unnamed: R7.1, R10.2
