kaichodesu/sotond5/Project Files/Interface Simulations/Schematic/10ACto3.3DC V1.sch

## EAGLE design Project Files/Interface Simulations/Schematic/10ACto3.3DC V1.sch (2023-03-17)

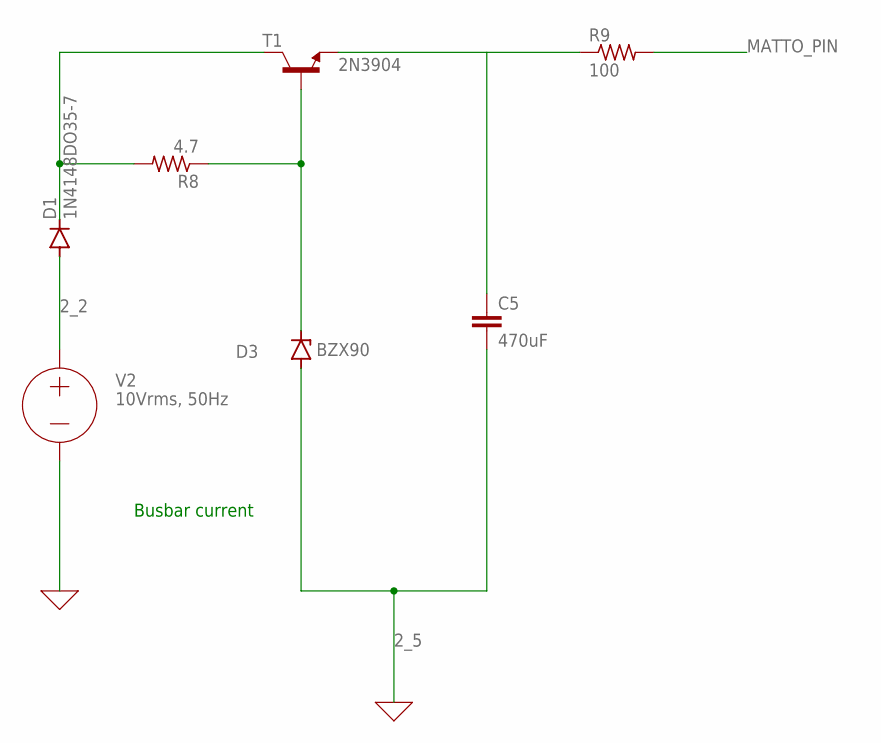
[picture p128: schematic 10ACto3.3DC V1.sch]

Parts:
C5: 470uF; C2.5-3
D1: 1N4148DO35-7; DO35-7
D3: BZX90; DO34Z7
R8: 4.7; 0204/7
R9: 100; 0204/7
T1: 2N3904; TO92

Connections:
2_2: D1.A
2_5: C5.2, D3.A
BUSBAR_CURRENT: D1.C, R8.2, T1.1 (C)
MATTO_PIN: R9.2
unnamed: D3.C, R8.1, T1.2 (B)
unnamed: C5.1, R9.1, T1.3 (E)

Notes on the sheet:
Busbar current
