kaichodesu/sotond5/liblcd/graphics.c

#include <avr/pgmspace.h>


// array size is 28800
const uint16_t hachikuji[] PROGMEM  = {
  0xcd14, 0xd556, 0xd5d7, 0xde18, 0xd639, 0xd638, 0xd618, 0xd618, 0xd618, 0xd618, 0xd618, 0xd618, 0xd5f8, 0xcdb7, 0xbcf4, 0xb472, 0xb412, 0xb3f1, 0xb3d1, 0xb3d0, 0xabb0, 0xabb0, 0xab8f, 0xa36e, 0x9b4e, 0x932d, 0x932c, 0x8b2c, 0x8b2c, 0x934c, 0x9b8d, 0xa3cf, 0xb450, 0xbcb2, 0xcd14, 0xd555, 0xd575, 0xd555, 0xccf3, 0xcc92, 0xc430, 0xb3ce, 0xab4d, 0xa30c, 0xa30c, 0xab4d, 0xb3ae, 0xbc0f, 0xc450, 0xc490, 0xc490, 0xccb0, 0xccd1, 0xcd11, 0xd552, 0xdd93, 0xdd93, 0xdd93, 0xd552, 0xccf0, 0xc46f, 0xbbed, 0xb38c, 0xab6b, 0xab4b, 0xab6b, 0xab6b, 0x9b2b, 0x82a9, 0x6a07, 0x4985, 0x3903, 0x30e3, 0x3903, 0x4944, 0x5185, 0x59a5, 0x59a6, 0x59a6, 0x59c6, 0x59e6, 0x6228, 0x6aa9, 0x7b2b, 0x83ad, 0x8bee, 0x93ee, 0x93ee, 0x93ee, 0x8bce, 0x838d, 0x7b4b, 0x6aca, 0x5a48, 0x49e6, 0x3985, 0x3124, 0x3104, 0x3104, 0x3924, 0x3945, 0x4166, 0x4186, 0x49c7, 0x51e7, 0x5a28, 0x628a, 0x6acb, 0x7b0c, 0x836d, 0x93cf, 0xa430, 0xb472, 0xc492, 0xc493, 0xcc93, 0xccb3, 0xccb3, 0xccb3, 0xcc92, 0xcc92, 0xcc92, 0xccb3, 0xd4f3, 0xd534, 0xd554, 0xdd74, 0xdd94, 0xdd93, 0xd572, 0xcd10, 0xb48e, 0x9bcc, 0x7b09, 0x6247, 0x49a5, 0x3923, 0x30c2, 0x2881, 0x2861, 0x2040, 0x1840, 0x2040, 0x2040, 0x2040, 0x2020, 0x1820, 0x1820, 0x1000, 0x0800, 0x0800, 0x0800, 0x0800, 0x0800, 0x0000, 0x0000, 0x0000, 0x0000, 0x0000, 0x0800,
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
  0xf679, 0xff5c, 0xff7d, 0xff7d, 0xff5c, 0xff5d, 0xff3c, 0xde79, 0xcdf7, 0xcdf7, 0xcdb6, 0xe533, 0xecf2, 0xecf2, 0xe513, 0xd595, 0xc576, 0xcdb7, 0xcdb7, 0xadf9, 0x3e9f, 0xa63b, 0xd618, 0xcdd8, 0xcdd8, 0xcdf9, 0xd619, 0xe67a, 0xf6fb, 0xff3c, 0xff5d, 0xff9d, 0xff7d, 0xf71c, 0xcdb7, 0xbd35, 0xb514, 0x95da, 0x3e9f, 0x9598, 0xacd3, 0xb4f4, 0xb4f4, 0xb4f3, 0xb4d3, 0xacd3, 0xacd3, 0xacb2, 0xacb2, 0xacb2, 0xacd3, 0xacb2, 0xacd2, 0xacb2, 0xacd2, 0x8d78, 0x3e9f, 0x85d9, 0xb534, 0xb534, 0xb533, 0xb4f3, 0xb4f2, 0xacd2, 0xacd2, 0xb4f2, 0xacd2, 0xb4f2, 0xbd33, 0xc554, 0xb513, 0xb513, 0xb4f2, 0x8dd9, 0x3e9f, 0x9db8, 0xbd54, 0xbd54, 0xbd54, 0xc574, 0xa5d8, 0x3e9f, 0x9e1a, 0xcdd6, 0xcdd6, 0xcdb6, 0xcdb6, 0xc5d6, 0xc5d6, 0xcdd6, 0xcdd6, 0xc5b6, 0xc5b6, 0xc595, 0xc5b6, 0xc5b6, 0xcdd6, 0xc595, 0x9e1a, 0x3e9f, 0xa5d9, 0xc595, 0xc5b5, 0xc595, 0xc574, 0xc574, 0xc513, 0xbb2f, 0xcdd5, 0xbd74, 0xbd54, 0xc574, 0xbd54, 0x82ca, 0x732b, 0xbd12, 0x40c1, 0x61c4, 0xbcf2, 0xbd55,
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
};
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
