kaichodesu/sotond5/liblcd/graphics.h

#include <avr/pgmspace.h>

extern const uint16_t bg1_1[] PROGMEM;
extern const uint16_t bg1_2[] PROGMEM;
extern const uint16_t BATCHR[] PROGMEM;
extern const uint16_t BATDRN[] PROGMEM;
extern const uint16_t hachikuji[] PROGMEM;
