kaichodesu/sotond5/(commit log)

2023-03-09 calibration msg
2023-03-09 adc updates
2023-03-11 adc bugfix
2023-03-11 adc phase capture fix
    [adc.c, adc.h, main.c]
2023-03-12 fixed Fast PWM
2023-03-12 adc update
2023-03-13 fixed hh8() memory addressing corruption
    [graphics.c, graphics.h, lcd.c, lcd.h, main.c, pgmspace.h]
2023-03-14 System Flowchart
2023-03-14 Added Interrupt Service Routine.drawio
2023-03-14 Update Interrupt Service Routine.drawio
2023-03-17 removing oversized files and fixing HEAD
    [.ms14, 10ACto3.3DC (second version) .ms14, 10ACto3.3DC (second version) .sch, 10ACto3.3DC V1.ms14, 10ACto3.3DC V1.sch, 16SVF270M.PcbLib, 16svf270m.psm, 1C20C0G220J050B.PcbLib]
